Robot-printer/ROV-project/README.md

This is our ROV project, let's add a description here!
