Robot-printer/ROV-project/Documents/Mechanical Documention/CAD Documentation/Design Choices/Structure-Overview wip.md

![[rev3 proto.png]]
 This revision of the AUV was designed to optimize the the our usable space and motor placements. The motors are now at a 45 degree angle. Compared to the previous version having motors at an angle will give the AUV higher degrees of maneuverability
