Robot-printer/ROV-project/Documents/Mechanical Documention/CAD Documentation/Design Choices/Vertical Nacelle documentation -Carson.docx

The vertical nacelles are on either side of both tube brackets. They span the whole height of the sub and are secured in place by flanges on the top and bottom. The propeller is located at the bottom of the nacelle to prioritize upward movement. The propeller mount is removable to allow for the insertion of the propeller. The nacelle is curved to improve flow efficiency.
