Robot-printer/ROV-project/Arduino/mega pinout.png

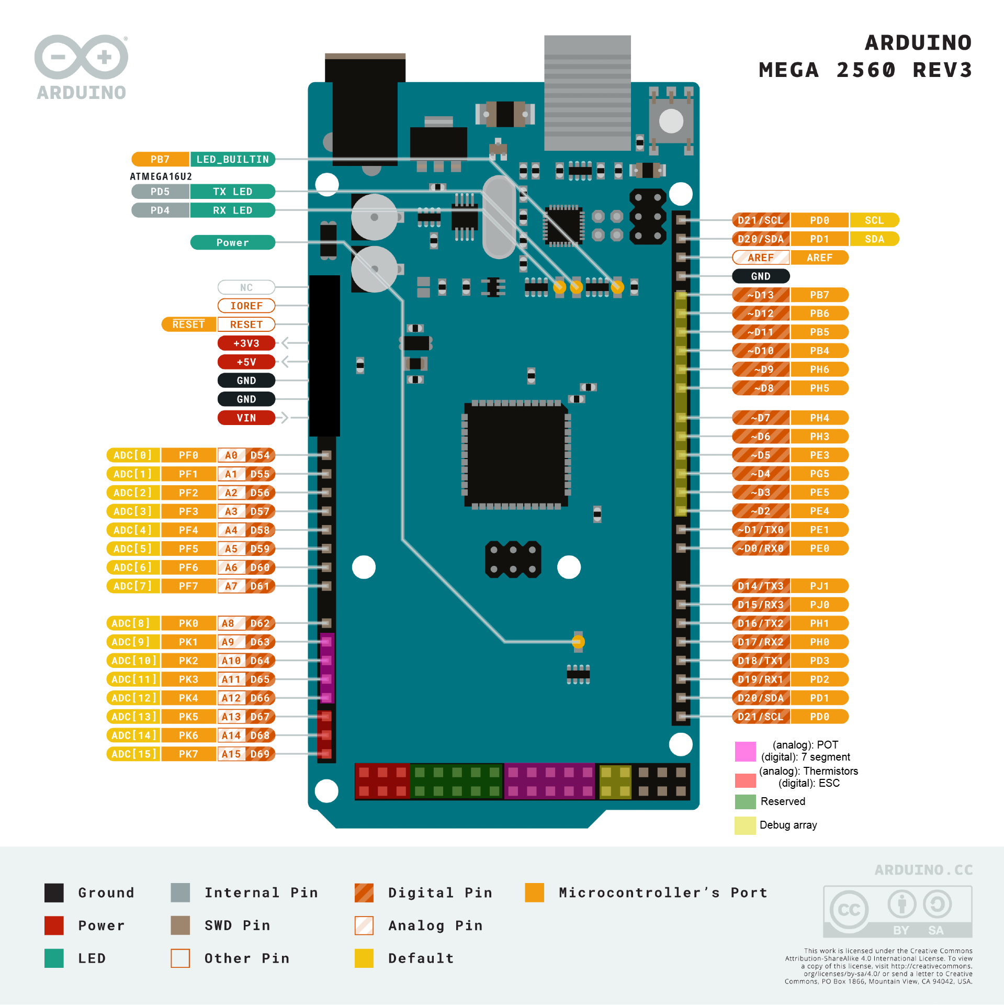
Arduino/mega pinout.png
