Robot-printer/ROV-project/Documents/Mechanical Documention/images/rev3 proto.png

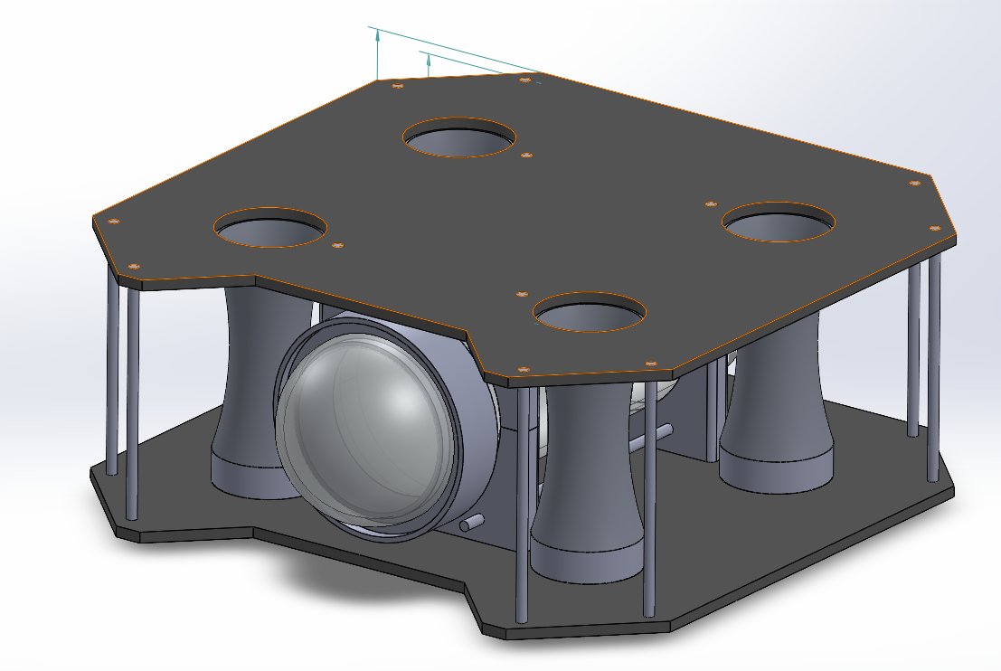
Documents/Mechanical Documention/images/rev3 proto.png
