Robot-printer/ROV-project/3D files/CAD parts/Spring 2025/README.txt

Please follow the guidelines laid out in the CAD Guidelines and CAD Part ID Format files located in the Documents/Cad Documentation folder
