Robot-printer/ROV-project/Documents/BOMs/Anonymous parts list 1 - pending, submitted.pdf

- 50 ft x External cable (https://www.wireandcableyourway.com/18-3-soow-portable-cord-600v-ul-csa) - $0.55/ft - $27.5 total (wireandcable your way)
- 2 x Heat blocks (https://www.amazon.com/dp/B07FZWM4Z7) - $12.99 ea - $ 22.98 total
- Noctua fan (https://www.amazon.com/Noctua-NF-S12A-PWM-Premium-Quiet/dp/B00BEZZBFO) - $21.95
- Coolant (https://www.amazon.com/CORSAIR-Hydro-Performance-Coolant-Clear/dp/B097S5C6DS) - $19.99
- Pump (https://www.amazon.com/Water-Cooling-Pump-Integrated-Exchanger/dp/B09DB7KX41) - $28.99
- Fittings (https://www.amazon.com/uxcell-Straight-Pneumatic-Connect-Fittings/dp/B07KBXZNZH) - $9.49
- Radiator (https://www.amazon.com/DIYhz-Computer-Radiator-Aluminum-Exchanger/dp/B08DMTF9KW) - $15.99
- Soft tubing (https://www.amazon.com/QuQuyi-Vinyl-Tubing-Lightweight-Plastic/dp/B08ZS54YTF) - $11.99
- External pumps (https://www.amazon.com/HiLetgo-Water-Brushless-Pumping-Aquarium/dp/B07X9L5RNS) - $13.69
- Pin headers (https://www.amazon.com/MCIGICM-Header-2-45mm-Arduino-Connector/dp/B07PKKY8BX) - $4.99
- 40 pin block (https://www.amazon.com/Break-Away-2x20-pin-Strip-Header-Raspberry/dp/B0756KM7CY) - $4.61
- 40 pin ribbon cable (https://www.amazon.com/Gowoops-Ribbon-Cable-40pin-Raspberry/dp/B01H53OK5U) - $14.98
- 2x SD card (https://www.amazon.com/SanDisk-Extreme-microSDTM-Adapter-SDSQXCD-256G-GN6MA/dp/B09X7DMBVF) - $ (Sandisk)
- Lipoly charger (https://www.adafruit.com/product/259) - $12.50 (Adafruit)
- Lipoly pack (https://www.adafruit.com/product/5035) - $29.95 (Adafruit)
- E-stop (https://www.digikey.com/en/products/detail/eao/61-6441-4047/8735380?s=N4IgTCBcDaIGwEYC0cAsqEDpUAZUHYQBdAXyA) - $51.64 (digikey)
