Robot-printer/ROV-project/Documents/Electronics Documentation/Electronics team BOM - Sheet1.csv

 | Part name | Unit Price | Total Price | Source | Team | Location (on vehicle) | Specs | Purpose | Part Qauntitiy | Purchase Quantity | Link
 |  | $712.44 | $1,768.63
1 | Raspberry Pi 5 | $80.00 | $80.00 | Digikey | Electronics | Electronics tray | 8gb ram [Need exact part] | Main processor | 1 | 1 | https://www.digikey.com/en/products/detail/raspberry-pi/SC1112/21658257?gclsrc=aw.ds&gad_source=1&gclsrc=aw.ds
1 | Pi Heatsink (ED-PI5PCOOLER) | $4.08 | $4.08 | Digikey | Electronics | Pi | N/A | Cool the Pi | 1 | 1 | https://www.digikey.com/en/products/detail/edatec/ED-PI5PCOOLER/25660654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
 | Micro SD card | $12.80 | $12.80 | Amazon | Electronics | Pi | 128 gb | Store Pi Programs and OS | 1 | 1 | https://www.amazon.com/SanDisk-128GB-Ultra-microSDXC-Memory/dp/B0BDYVC5TD?hvadid=730312820598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
1 | Raspberry Pi M.2 HAT+ | $12.00 | $12.00 | Digikey | Electronics | Pi | N/A | add PCIE expansion to Pi | 1 | 1 | https://www.digikey.com/en/products/detail/raspberry-pi/SC1166/23350779?gclsrc=aw.ds&gad_source=1&gclsrc=aw.ds
1 | Arduino Mega | $22.99 | $22.99 | Amazon | Electronics | Electronics tray | N/A | Main Microcontroller | 1 | 1 | https://www.amazon.com/ELEGOO-Compatible-Arduino-Projects-Compliant/dp/B01H4ZDYCE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
1 | Adafruit ItsyBitsy M0 Express | $11.95 | $35.85 | Adafruit | Electronics | Electronics tray | N/A | Auxilliary microcontroller | 3 | 3 | https://www.adafruit.com/product/3727
1 | DF Robot FIT0701 | $9.90 | $9.90 | Digikey | Electronics | Camera arm | Any USB webcam module | Main Camera | 1 | 1 | https://www.digikey.com/en/products/detail/dfrobot/FIT0701/13166487?gclsrc=aw.ds&gad_source=1&gclsrc=aw.ds
4 | Mg996R | $12.98 | $12.98 | Amazon | Electronics | Dome plate | 55g | Camera Arm Servo | 1 | 1 | https://www.amazon.com/MG996R-Digital-Waterproof-Airplane-Helicopter/dp/B0DCK462XZ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
8 | COM-18732 12v buck regulator | $14.98 | $119.84 | Digikey | Electronics | Electronics tray | 5A minimum, 13v or less minimum voltage input | Regulate voltage to motors | 8 | 8 | https://www.digikey.com/en/products/detail/sparkfun-electronics/COM-18732/15927228
1 | DFRobot DFR0884 5v converter | $8.50 | $17.00 | Digikey | Electronics | Electronics tray | 3A minimum, 13v or less minimum voltage input | regulate voltage to 5v sys | 2 | 2 | https://www.digikey.com/en/products/detail/dfrobot/DFR0884/14824983?gclsrc=aw.ds&gad_source=1&gclsrc=aw.ds
1 | LM3671 3.3V Buck Converter | $4.95 | $14.85 | Adafruit | Electronics | Electronics tray | 0.5A minimum, 13v or less minimum voltage input | regulate voltage to 3.3v sys | 3 | 3 | https://www.adafruit.com/product/2745
2 | 4s 5.2 AH LiPO | $98.99 | $197.98 | Amazon | Electronics | Battery bank | See Part Name | Main Power | 4 | 2 | https://www.amazon.com/Zeee-Battery-5200mAh-Crawler-Monster/dp/B0B1DHNSKZ?s=toys-and-games
 | Samsung 25R 18650 2500mAh 20A | $3.99 | $23.94 | 18650BatteryStore | Electronics | Electronics tray | See Part Name | Auxilliary power | 6 | 6 | https://www.18650batterystore.com/products/samsung-25r-18650?adgroupid=43081474946&gad_source=1
 | AA Batteries | $9.99 | $9.99 | Amazon | Electronics | Battery Packs | N/A | IC power | 6 | 1 | https://www.amazon.com/AmazonBasics-Performance-Alkaline-Batteries-20-Pack/dp/B00NTCH52W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
3 | AA battery packs | $1.30 | $3.90 | Digikey | Electronics | Electronics tray | 2 pack | Hold AAs | 3 | 3 | https://www.digikey.com/en/products/detail/keystone-electronics/2463/303812?gclsrc=aw.ds&gad_source=1
 | 6 AWG cable | $0.92 | $9.20 | WireandCableYourWay | Electronics | Bus Bar to Electronics tray | Stranded | Internal High-current pwr | 10 ft | 10 | https://www.wireandcableyourway.com/6-awg-thhn-building-wire
 | 12 AWG cable | $0.27 | $3.24 | WireandCableYourWay | Electronics | Bus Bar to Electronics tray | Stranded | Internal Mid-Current pwr | 12 ft | 12 | https://www.wireandcableyourway.com/12-awg-xhhw-building-wire
 | Bus bars | $0.00 | $0.00 | Pre-Owned | Electronics | Battery bank |  | Distribute power | 2 | 2
 | Lugs | $0.00 | $0.00 | Pre-Owned | Electronics | Bus Bars |  | connect cables to parts
2 | SK2S120-100 Diodes | $18.24 | $36.48 | Digikey | Electronics | Electronics tray | 50A minimum | prevent backflow on batteries | 2 | 2 | https://www.digikey.com/en/products/detail/smc-diode-solutions/SK2S120-100/9566330
15 | 95SQ015 Diode | $0.99 | $14.85 | Digikey | Electronics | Electronics tray | 5A minimum | prevent backflow on circuits | 15 | 15 | https://www.digikey.com/en/products/detail/smc-diode-solutions/95SQ015/8021508
8 | Waterproof brushless motor 100W 2418 | $25.00 | $200.00 | UnderWaterThrusters | Electronics | Thrusters | [Need exact part] | Thruster motors | 8 | 8 | https://www.underwaterthruster.com/products/waterproof-brushless-motor-100w-2418-corrosion-and-oxidation-resistant-for-use-in-underwater-robots-rovs-unmanned-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
8 | 30A multi-directional Defiant ESC | $18.99 | $151.92 | Amazon | Electronics | Electronics tray | [Need exact part] | Control Thrusters | 8 | 8 | https://www.amazon.com/30A-Defiant-ESC-Controller-Multi-Directional/dp/B0C5RYKSV2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
1 | Flashlight | $8.49 | $8.49 | Amazon | Electronics | Exterior hull | Any | Control circuit and Reflector for led | 2 | 1 | https://www.amazon.com/Military-Lumens-Tactical-Waterproof-Flashlight/dp/B073VZZKK5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
2 | Seeed Studio XIAO ESP32C3 | $4.99 | $9.98 | Digikey | Electronics | Flashlights | [Need exact part] | Control Flashlight logic | 2 | 2 | https://www.digikey.com/en/products/detail/seeed-technology-co-ltd/113991054/16652880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
1 | 2s Lipo Battery 2200mAh | $27.89 | $27.89 | Amazon | Electronics | Flashlights | See Part Name | Powers Flashlights | 2 | 1 | https://www.amazon.com/Zeee-Connector-Helicopter-Airplane-Quadcopter/dp/B0BYNKBKGT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
2 | 5v buck converter | $6.95 | $13.90 | Adafruit | Electronics | Flashlights | 1A minimum | Regulates flashlight power | 2 | 2 | https://www.adafruit.com/product/4739
 | 2 inch pvc | $8.48 | $8.48 | Lowes | Electronics | Flashlights | N/A | Flashlight body | 2ft | 1 | https://www.lowes.com/pd/Charlotte-Pipe-2-in-x-2-ft-PVC-Pipe/5005518961
1 | 2 inch Threaded pvc cap | $7.95 | $15.90 | Amazon | Electronics | Flashlights | N/A | Openable end of flashlights | 2 | 2 | https://www.amazon.com/Threaded-Cap-Schedule-40-PVC/dp/B000VYN23W?mcid=a34623da747b374fb0f44df343a1dd15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
 | 2 inch Threaded pvc adapter | $2.59 | $5.18 | Home Depot | Electronics | Flashlights | N/A | adapter for threaded cap | 2 | 2 | https://www.homedepot.com/pep/Charlotte-Pipe-2-in-PVC-Schedule-40-MPT-x-S-Male-Adapter-PVC-02109-1600HD/203825431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
 | 1 1/2 inch pvc | $5.85 | $5.85 | Home Depot | Electronics | Flashlights | N/A | pvc for clear cap | 6 inches | 1 | https://www.homedepot.com/p/Charlotte-Pipe-1-1-2-in-x-2-ft-PVC-DWV-Schedule-40-Pipe-PVC071120200HA/100581718
 | 2 inch to 1 1/2 inch pvc reducer | $3.32 | $6.64 | Lowes | Electronics | Flashlights | N/A | pvc adapter | 2 | 2 | https://www.lowes.com/pd/Charlotte-Pipe-2-IN-X-1-1-2-IN-SCH40-REDUCER-BUSHING/5012474889
 | 1 1/2 inch clear pvc cap | $3.90 | $7.80 | US Plastic | Electronics | Flashlights | N/A | clear cap | 2 | 2 | https://www.usplastic.com/catalog/item.aspx?itemid=154673&clickid=search
 | Pvc cement | $5.22 | $5.22 | Home Depot | Electronics | Flashlights | N/A | holds PVC parts together | 1 | 1 | https://www.homedepot.com/pep/Oatey-8-oz-Regular-Clear-PVC-Cement-California-Compliant-310133V/322402448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
1 | USB A hub | $6.99 | $13.98 | Amazon | Electronics | Electronics tray | 3 ports or more | adds more USB ports to the Pi | 2 | 2 | https://www.amazon.com/UGREEN-Splitter-Ultra-Slim-Expander-Compatible/dp/B0CD1BHXPZ
1 | Dupont cables | $6.98 | $13.96 | Amazon | Electronics | Electronics tray | N/A | Connects microcontrollers to circuits | 2 | 2 | https://www.amazon.com/Elegoo-EL-CP-004-Multicolored-Breadboard-arduino/dp/B01EV70C78
1 | Noctua 80mm fan | $16.11 | $48.33 | Amazon | Electronics | Interior Cooling ducts | N/A | Provides air circulation | 3 | 3 | https://www.amazon.com/Noctua-Bearing-Premium-NF-A8-PWM/dp/B00VG9PJBO?mcid=9df0e357253335b19d65e9c5ce952d09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
5 | 4468 fans | $2.95 | $14.75 | Digikey | Electronics | Interior Cooling ducts | N/A | directs air onto components | 5 | 5 | https://www.digikey.com/en/products/detail/adafruit-industries-llc/4468/11587354
 | Copper Sheet | $0.00 | $0.00 | Pre-Owned | Electronics | Interior face of Hull |  | Provides thermal mass for dissipation | 1 | 1
 | Thermal paste | $13.99 | $13.99 | Amazon | Electronics | (various locations) | N/A | Provides a thermal bridge | 100g | 1 | https://www.amazon.com/HY-510-1pcs-25g-Thermal-Paste-Conductivity/dp/B07PHT3LWC?sp_csd=d2lkZ2V0TmFtZT1zcF9hdGY
 | Ptm7950 phase change thermal pads | $25.99 | $25.99 | Newegg | Electronics | (various locations) | N/A | Provides a more effective, thinner thermal bridge | 80mmx80mm | 1 | https://www.newegg.com/p/2MB-001F-00072?Item=9SIA4REK368786&cm_sp=product-_-from-price-options
 | Heatsinks | $0.00 | $0.00 | Pre-Owned | Electronics | Interior face of Hull |  | Dissipates heat
10 | 8 connector terminal blocks | $3.83 | $30.64 | Digikey | Electronics | Back plate near glands | [Need exact part] | Takes cable inputs from glands | 8 | 8 | https://www.digikey.com/en/products/detail/phoenix-contact/1715789/260634?gclsrc=aw.ds&gad_source=1
 | 16 gauge x6 cables | $1.48 | $23.68 | WireandCableYourWay | Electronics | Gland outputs | [Need exact part] | cable for glands | 16 | 16 | https://www.wireandcableyourway.com/16-6-soow-portable-cord-600v-ul-csa
 | 18 gauge x3 cables | $0.53 | $21.20 | WireandCableYourWay | Electronics | Gland outputs | [Need exact part] | cable for glands | 40 | 40 | https://www.wireandcableyourway.com/18-3-soow-portable-cord-600v-ul-csa
10 | SPST switch | $0.71 | $7.10 | Digikey | Electronics | Electronics tray | 5V, 5A | Control circuits for power off and debugging | 10 | 10 | https://www.digikey.com/en/products/detail/e-switch/RA1113112R/3778055?gclsrc=aw.ds&gad_source=1
1 | Cutoff switch | $14.99 | $14.99 | Amazon | Electronics | Electronics tray | 12V, 200A | Hard cut for main power | 1 | 1 | https://www.amazon.com/Battery-Disconnect-Current-Isolator-Outboards/dp/B0B17BGHPS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
1 | OLED graphic display | $19.95 | $39.90 | Adafruit | Electronics | Electronics tray | Monochrome 1.3" 128x64 | provides a display for system info | 2 | 2 | https://www.adafruit.com/product/938?gQT=1
1 | Waterproof switch cover | $3.08 | $3.08 | Digikey | Electronics | Back plate | [Need exact part] | Waterproofs a button | 1 | 1 | https://www.digikey.com/en/products/detail/apm-hexseal/N3030-2/340286?gclsrc=aw.ds&gad_source=1
 | Exterior cutoff switch | $2.61 | $2.61 | Digikey | Electronics | Back plate | N/A | Button for emergency cutoff | 1 | 1 | https://www.digikey.com/en/products/detail/c-k/F2UEE/417517
1 | HiLetgo RFID Kit | $5.69 | $5.69 | Amazon | Electronics | Interior face of Hull | [Need exact part] | Reads RFID cards for external controls | 1 | 1 | https://www.amazon.com/HiLetgo-RFID-Kit-Arduino-Raspberry/dp/B01CSTW0IA?mcid=896d590d183434548498ee0eaa5bc8a9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
1 | T5577 Thick Smart Cards | $6.98 | $6.98 | Amazon | Electronics | N/A | Any Programmable RFID cards or tags | Extra RFID cards for other functions | 5 | 1 | https://www.amazon.com/Contactless-Rewritable-Proximity-Clamshell-Compatible/dp/B0DHVXYNZL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
 | Underwater Ultrasonic Obstacle Avoidance Sensor | $32.00 | $256.00 | DFR Robot | Electronics | Exterior mounts | [Need exact part] | Ultrasonic distance sensor, for 3d mapping | 8 | 8 | https://www.dfrobot.com/product-2760.html
1 | 6 axis accelerometer and 3 axis gyroscope | $19.95 | $39.90 | Adafruit | Electronics | Electronics tray | [Need exact part] | detects the orientation of the vehicle | 2 | 2 | https://www.adafruit.com/product/4517
1 | Adafruit AM2320 Sensor | $3.95 | $3.95 | Digikey | Electronics | Electronics tray | [Need exact part] | Detects humidity | 1 | 1 | https://www.digikey.com/en/products/detail/adafruit-industries-llc/3721/8558266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
10 | 10k thermistor | $0.95 | $9.50 | Digikey | Electronics | (various locations) | [Need exact part] | Detects heat at a point to prevent overheating | 10 | 10 | https://www.digikey.com/en/products/detail/adafruit-industries-llc/4890/13982731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
1 | DF Robot SEN0257 | $17.50 | $17.50 | Digikey | Electronics | Exterior mounts | [Need exact part] | Detects pressure under the water (to tell depth) | 1 | 1 | https://www.digikey.com/en/products/detail/dfrobot/SEN0257/8341836?gclsrc=aw.ds&gad_source=1&gclsrc=aw.ds
 | Adafruit MPRLS Ported Pressure Sensor | $29.95 | $29.95 | Adafruit | Electronics | Electronics tray | [Need exact part] | Detects interior pressure to monitor for issues | 1 | 1 | https://www.adafruit.com/product/3965
 | Waterproof DS18B20 Digital temperature sensor | $6.90 | $6.90 | Digikey | Electronics | Exterior mounts | [Need exact part] | detects water temperature | 1 | 1 | https://www.digikey.com/en/products/detail/dfrobot/DFR0198/7597054?gclsrc=aw.ds&gad_source=1&gclsrc=aw.ds
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
 |  | $0.00 | $0.00
 |  | $0.00 | $0.00
 |  | $0.00 | $0.00
 |  | $0.00 | $0.00
 |  | $0.00 | $0.00
 |  | $0.00 | $0.00
 |  | $0.00 | $0.00
 |  | $0.00 | $0.00
 |  | $0.00 | $0.00
 |  | $0.00 | $0.00
 |  | $0.00 | $0.00
 |  | $0.00 | $0.00
 |  | $0.00 | $0.00
 |  | $0.00 | $0.00
