Robot-printer/ROV-project/Documents/Mechanical Documention/BOM/Mech-BOM May.ods

Part number (internal) | Part name | Unit Price | Total Price | Source | Team | Location (on vehicle) | Purpose | Specs | Quantity | Link | Note:
 | HDPE Sheet | 69.72 | 139.44 | McMaster | 1 | Wings | Wings | 75cm/50cm | 2 | https://www.mcmaster.com/products/hdpe-sheets/marine-grade-moisture-resistant-polyethylene-hdpe-sheets-and-bars/
 | M3 Screws/hex kit | 21.99 | 21.99 | Amazon | 1 | everywhere | fix parts to other parts |  | 1 | https://www.amazon.com/M3-Assortment-Screws-Internal-Assorted/dp/B0C7QRW2TF?hvadid=694085230790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
 | M5 Screws/hex kit | 11.99 | 11.99 | Amazon | 1 | everywhere | fix parts to other parts |  | 1 | https://www.amazon.com/Pieces-Washers-Sutemribor-Assortment-Threaded/dp/B0CZRT2B8M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
 | 1kg ASA filament | 29.99 | 499.95 | Elegoo, PolyMaker, Overture, Hatchbox, Bambu Labs | 1 | support parts | support | Color: black | 5 | https://www.amazon.com/Creality-Filament-Printer-Temperature-Resistance/dp/B0CF2384QL
 | Adhesive | unknown | unknown | unknown | 1 | End caps | Glue parts of the end caps together | waterproof | 2
 | n
