Robot-printer/ROV-project/Documents/Mechanical Documention/BOM/Mech-BOM.ods

Part number (internal) | Part name | Unit Price | Total Price | Source | Team | Location (on vehicle) | Purpose | Specs | Quantity | Link | Note:
 | HDPE Sheet | 69.72 | 139.44 | McMaster | 1 | Wings | Wings | 75cm/50cm | 2 | https://www.mcmaster.com/products/hdpe-sheets/marine-grade-moisture-resistant-polyethylene-hdpe-sheets-and-bars/
 | M3 Screws/hex kit | 21.99 | 21.99 | Amazon | 1 | everywhere | fix parts to other parts |  | 1 | https://www.amazon.com/M3-Assortment-Screws-Internal-Assorted/dp/B0C7QRW2TF?hvadid=694085230790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
 | M5 Screws/hex kit | 11.99 | 11.99 | Amazon | 1 | everywhere | fix parts to other parts |  | 1 | https://www.amazon.com/Pieces-Washers-Sutemribor-Assortment-Threaded/dp/B0CZRT2B8M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
 | 3/8’’ threaded rod | 5.68 | 17.04 | Lowe’s | 1 | 4 on each wing | support rods | 36’’ long | 3 | https://www.lowes.com/pd/Hillman-3-8-in-dia-x-3-ft-L-Coarse-Steel-Threaded-Rod/3129283
 | 3/8’’ nuts | 8.42 | 8.42 | Home Depot | 1 | Threaded onto the support rods | lock the support the rods |  | 1(25Pack) | https://www.homedepot.com/p/Everbilt-3-8-in-16-Galvanized-Hex-Nut-25-Pack-802244/204274099
 | PVC tube | unknown | unknown | unknown | 1 | Pressure chamber | Pressure chamber | 18’’ long, ID 152, OD 168 | 1
 | Aluminum | 52 | 208 | ebay | 1 | End caps | support | 6061 T6 9’’x 9’’, ¼’’ thick | 4 | https://www.ebay.com/str/USA-Metal-Online | This was provided to us. This seller does not do standard sizes
 | 1kg nylon filament | $0.00 | $0.00 | Elegoo, PolyMaker, Overture, Hatchbox, Bambu Labs | 1 | support parts | support | Color: black | 5
 | Large Cable Gland | 9.29 | 18.58 | Amazon | 1 | End caps | Cable port | 21mm | 2(20 packs) | https://www.amazon.com/MAKERELE-Plastic-Waterproof-Adjustable-6-8mm-12mm/dp/B0CTCG3PQG?th=1
 | Small Cable Gland | 9.97 | 19.94 | Amazon | 1 | End caps | Cable port | 8.2mm | 2(20 packs)
 | Adhesive | unknown | unknown | unknown | 1 | End caps | Glue parts of the end caps together | waterproof | 2
