Robot-printer/ROV-project/Documents/Software Documentation/Software-BOM.csv

Part number (internal) | Part name | Unit Price | Total Price | Source | Team | Location (on vehicle) | Purpose | Quantity | Link
1 | Turtle Beach VelocityOne Flightstick | $129.36 | $129.36 | Amazon | 3 | N/A | Vehicle control | 1 | https://www.amazon.com/VelocityOne-Flightstick-Simulation-Controller-Gaming-Console/dp/B0BHTPP71M
1 | Crucial BX500 | $94.99 | $94.99 | Amazon | 3 | N/A | Video recording storage | 1 | https://www.amazon.com/Crucial-BX500-NAND-2-5-Inch-Internal/dp/B07YD579WM
 |  | $0.00 | $0.00
 |  | $0.00 | $0.00
 |  | $0.00 | $0.00
 |  | $0.00 | $0.00
 |  | $0.00 | $0.00
 |  | $0.00 | $0.00
 |  | $0.00 | $0.00
 |  | $0.00 | $0.00
 |  | $0.00 | $0.00
 |  | $0.00 | $0.00
 |  | $0.00 | $0.00
 |  | $0.00 | $0.00
 |  | $0.00 | $0.00
 |  | $0.00 | $0.00
 |  | $0.00 | $0.00
 |  | $0.00 | $0.00
 |  | $0.00 | $0.00
 |  | $0.00 | $0.00
 |  | $0.00 | $0.00
 |  | $0.00 | $0.00
 |  | $0.00 | $0.00
 |  | $0.00 | $0.00
 |  | $0.00 | $0.00
 |  | $0.00 | $0.00
 |  | $0.00 | $0.00
 |  | $0.00 | $0.00
 |  | $0.00 | $0.00
 |  | $0.00 | $0.00
 |  | $0.00 | $0.00
 |  | $0.00 | $0.00
 |  | $0.00 | $0.00
 |  | $0.00 | $0.00
 |  | $0.00 | $0.00
 |  | $0.00 | $0.00
 |  | $0.00 | $0.00
 |  | $0.00 | $0.00
 |  | $0.00 | $0.00
 |  | $0.00 | $0.00
 |  | $0.00 | $0.00
 |  | $0.00 | $0.00
 |  | $0.00 | $0.00
 |  | $0.00 | $0.00
 |  | $0.00 | $0.00
 |  | $0.00 | $0.00
 |  | $0.00 | $0.00
 |  | $0.00 | $0.00
 |  | $0.00 | $0.00
 |  | $0.00 | $0.00
 |  | $0.00 | $0.00
 |  | $0.00 | $0.00
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
 |  | $0.00 | $0.00
 |  | $0.00 | $0.00
 |  | $0.00 | $0.00
 |  | $0.00 | $0.00
 |  | $0.00 | $0.00
 |  | $0.00 | $0.00
 |  | $0.00 | $0.00
 |  | $0.00 | $0.00
 |  | $0.00 | $0.00
 |  | $0.00 | $0.00
 |  | $0.00 | $0.00
 |  | $0.00 | $0.00
 |  | $0.00 | $0.00
 |  | $0.00 | $0.00
