Robot-printer/ROV-project/PCB/Altium files/endcap.csv

Line # | Name | Description | Designator | Revision ID | Revision State | Revision Status | Quantity | Manufacturer 1 | Manufacturer Part Number 1 | Manufacturer Lifecycle 1 | Supplier 1 | Supplier Part Number 1 | Supplier Unit Price 1 | Supplier Subtotal 1
 | 615008138221 | Rj45 ports | Rj1, Rj2, Rj3, Rj4, Rj5, Rj6 | CMP-1502-01731-2 | Released | Up to date | 6 | Wurth Electronics | 615008138221 | Volume Production | Digikey | 732-2743-ND | 2.42 | 14.52
