Robot-printer/ROV-project/3D files/CAD parts/Spring 2025/Contemporary Parts/Assembled UUV 1.0.SLDASM

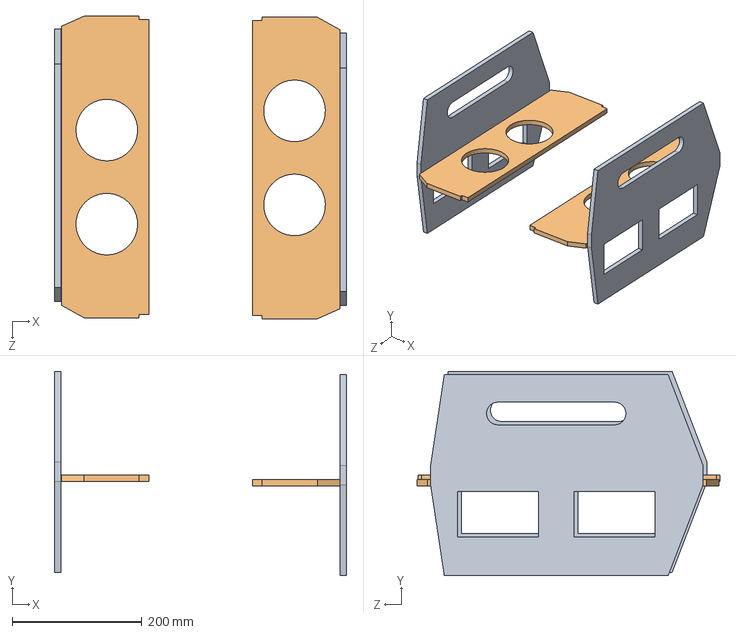
[picture p3: CAD file, 2025-02-06]
3D files/CAD parts/Spring 2025/Contemporary Parts/Assembled UUV 1.0.SLDASM
450.1 x 315.0 x 466.6 mm
Side Flaps 1.0 x 2
Side Wings 1.0 x 2
