Robot-printer/ROV-project/3D files/CAD parts/Spring 2025/Revision3/AUV Assembly.SLDASM

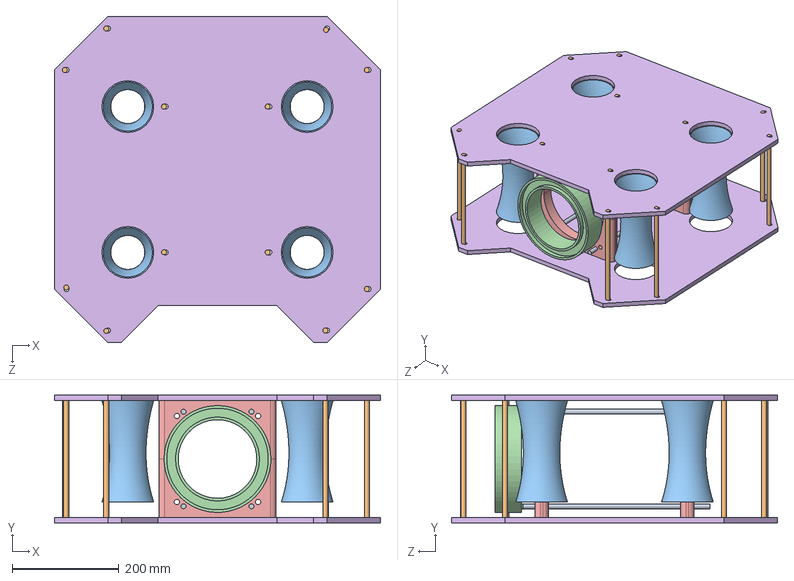
[picture p4: CAD file, 2025-05-07]
3D files/CAD parts/Spring 2025/Revision3/AUV Assembly.SLDASM
610.0 x 239.0 x 610.0 mm
Plate1 x 2
PVC Bracket x 4
Front collar
Vertical Nacelles x 4
Steel Rod x 12
Long steel rod x 4
