Robot-printer/ROV-project/3D files/CAD parts/Spring 2025/Addison's CAD Files/Main tube mm.SLDPRT

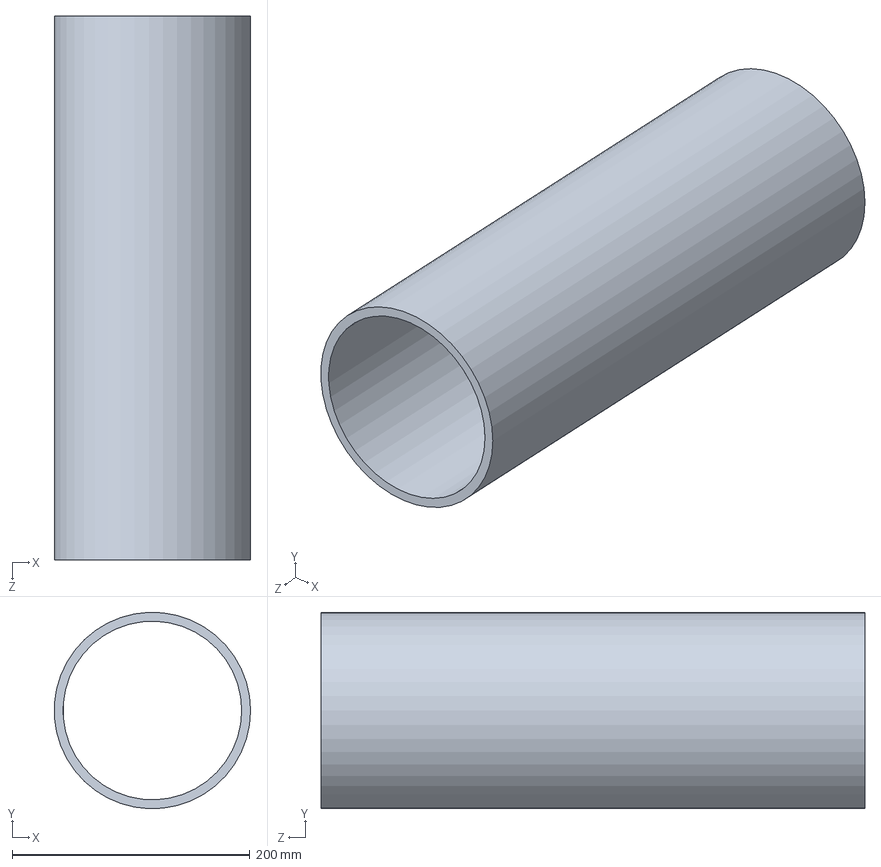
[picture p5: CAD file, 2025-04-10]
3D files/CAD parts/Spring 2025/Addison's CAD Files/Main tube mm.SLDPRT
164.9 x 165.0 x 457.2 mm
