Robot-printer/ROV-project/3D files/CAD parts/Spring 2025/Addison's CAD Files/Dimentioned assembly MMGS.SLDASM

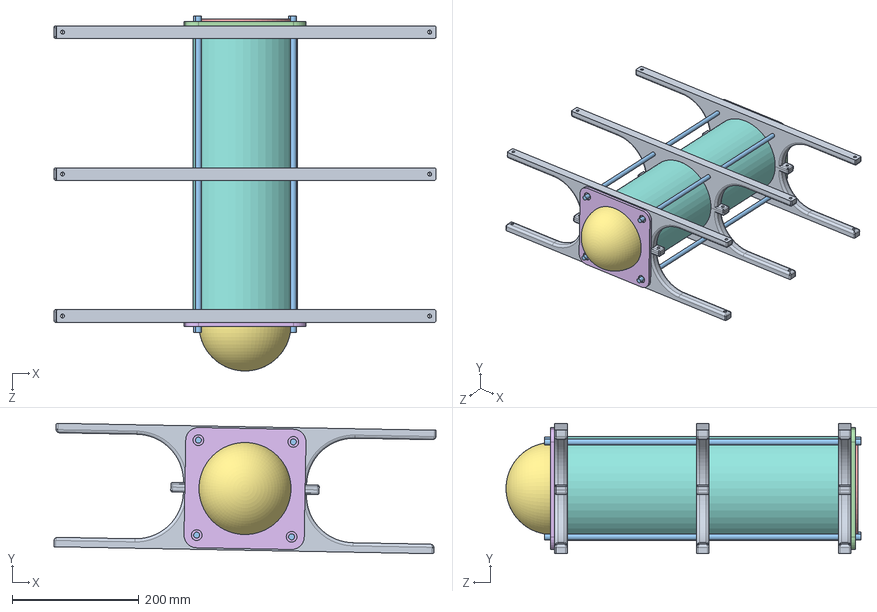
[picture p6: CAD file, 2025-04-10]
3D files/CAD parts/Spring 2025/Addison's CAD Files/Dimentioned assembly MMGS.SLDASM
603.5 x 206.0 x 560.8 mm
Main tube mm
Dome MMGS
Aluminum faceplate mms
Updated end cap
Back faceplate MMGS
aluminum rod MMGS x 4
Front Endcap Updated mmgs
Updated Bracket2 mmgs x 6
