Robot-printer/ROV-project/3D files/CAD parts/Active parts/Printables/PVC Bracket.STEP

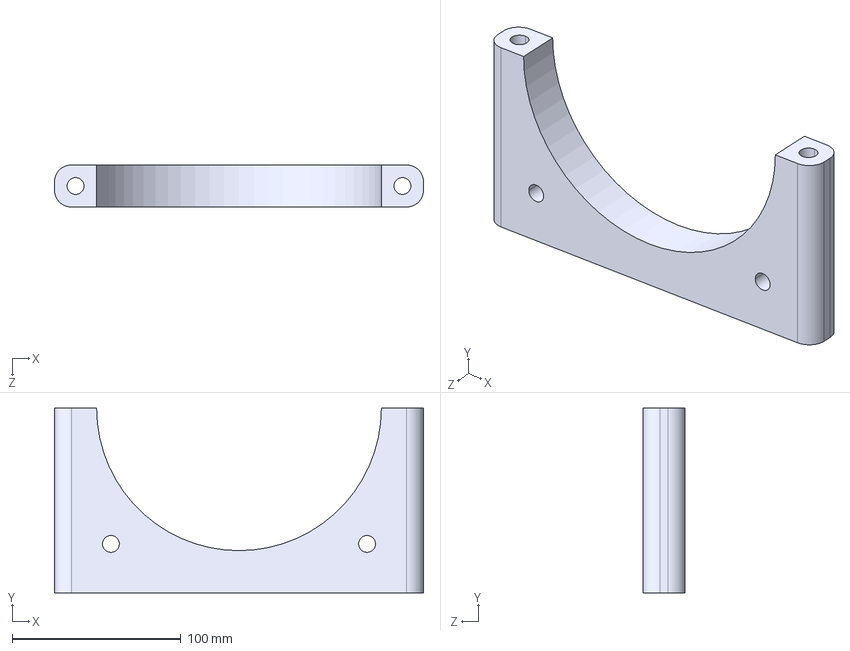
[picture p7: CAD file, 2025-07-30]
3D files/CAD parts/Active parts/Printables/PVC Bracket.STEP
219.0 x 109.5 x 25.0 mm
