Robot-printer/ROV-project/3D files/CAD parts/Spring 2025/Addison's CAD Files/Aluminum faceplate mms.SLDPRT

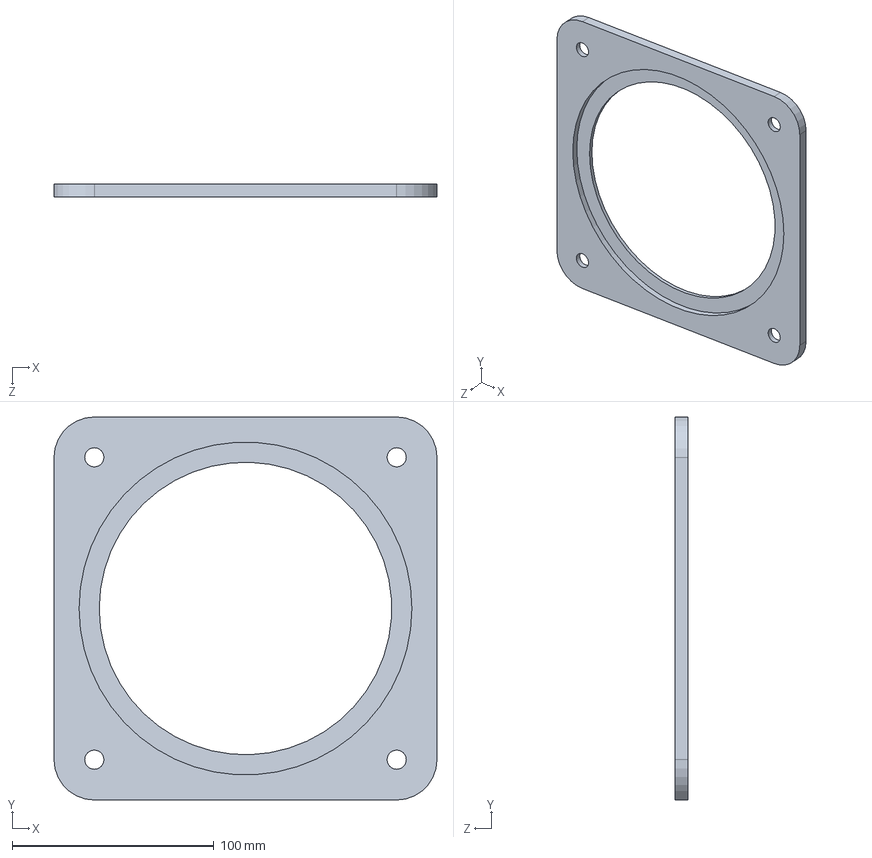
[picture p8: CAD file, 2025-04-10]
3D files/CAD parts/Spring 2025/Addison's CAD Files/Aluminum faceplate mms.SLDPRT
190.0 x 190.0 x 6.35 mm
