Robot-printer/ROV-project/3D files/CAD parts/Spring 2025/Contemporary Parts/UUV Battery 1.0.SLDPRT

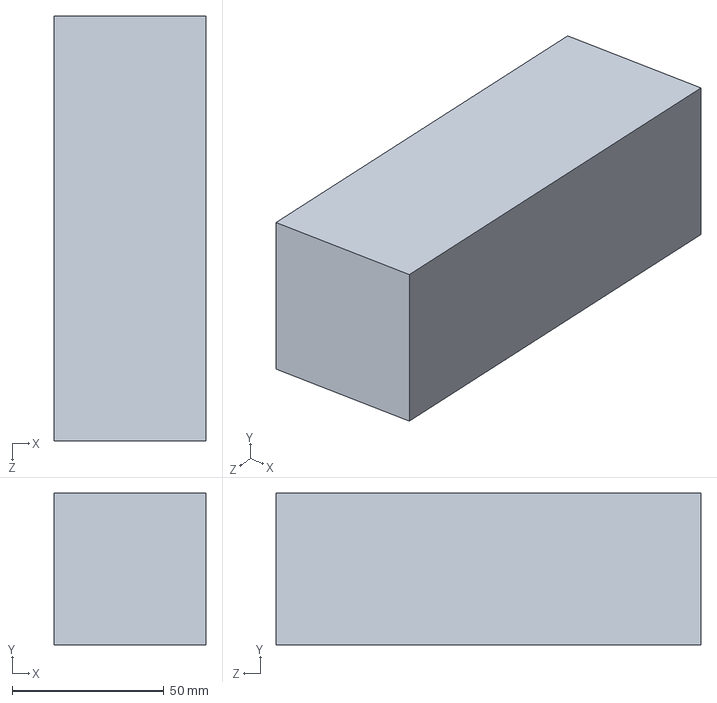
[picture p9: CAD file, 2025-02-06]
3D files/CAD parts/Spring 2025/Contemporary Parts/UUV Battery 1.0.SLDPRT
50.0 x 50.0 x 140.0 mm
