Robot-printer/ROV-project/3D files/CAD parts/Spring 2025/Feet 02.SLDPRT

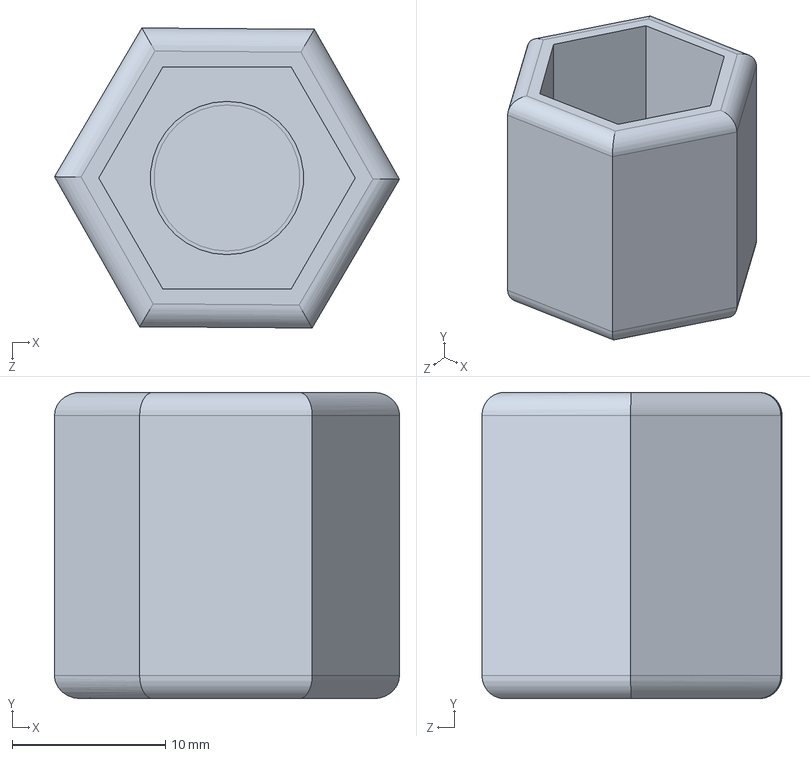
[picture p11: CAD file, 2025-08-07]
3D files/CAD parts/Spring 2025/Feet 02.SLDPRT
22.5 x 20.0 x 19.6 mm
