Robot-printer/ROV-project/3D files/CAD parts/Spring 2025/Revision3/Vertical Nacelles.SLDPRT

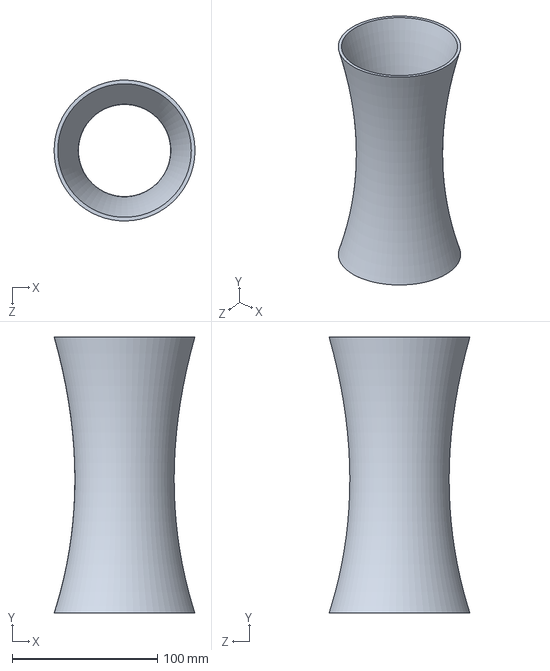
[picture p12: CAD file, 2025-05-07]
3D files/CAD parts/Spring 2025/Revision3/Vertical Nacelles.SLDPRT
96.9 x 190.0 x 97.0 mm
