Robot-printer/ROV-project/3D files/CAD parts/Spring 2025/WIP/electronics tray.SLDPRT

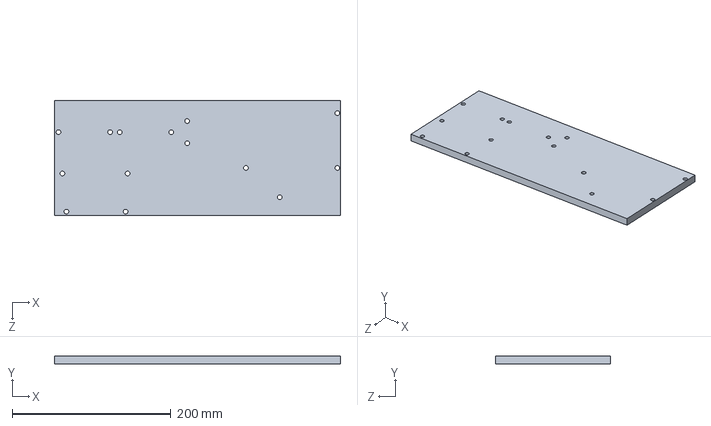
[picture p13: CAD file, 2025-06-06]
3D files/CAD parts/Spring 2025/WIP/electronics tray.SLDPRT
360.0 x 10.0 x 145.0 mm
