Robot-printer/ROV-project/3D files/CAD parts/Summer 2025/HandleA.STEP

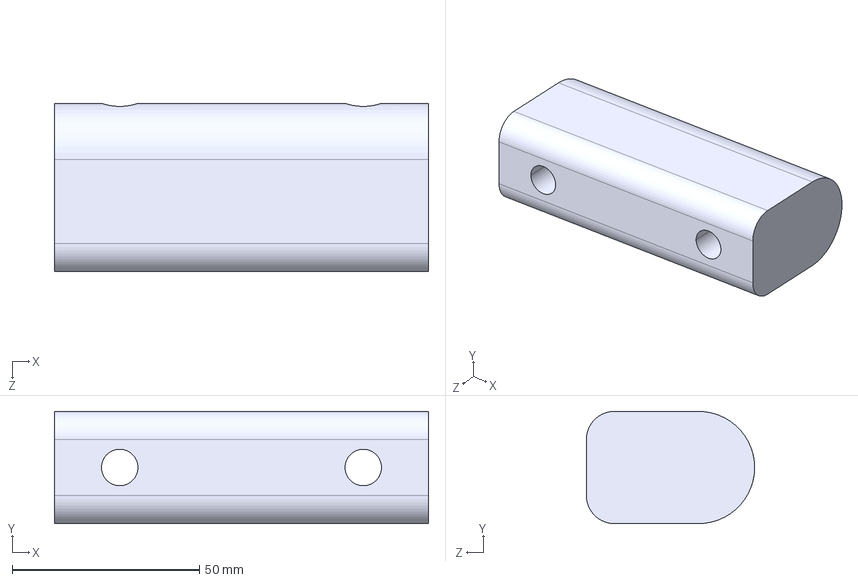
[picture p14: CAD file, 2025-07-07]
3D files/CAD parts/Summer 2025/HandleA.STEP
100.0 x 30.0 x 45.0 mm
