Robot-printer/ROV-project/3D files/electronic mock ups/EndCapPCB.step

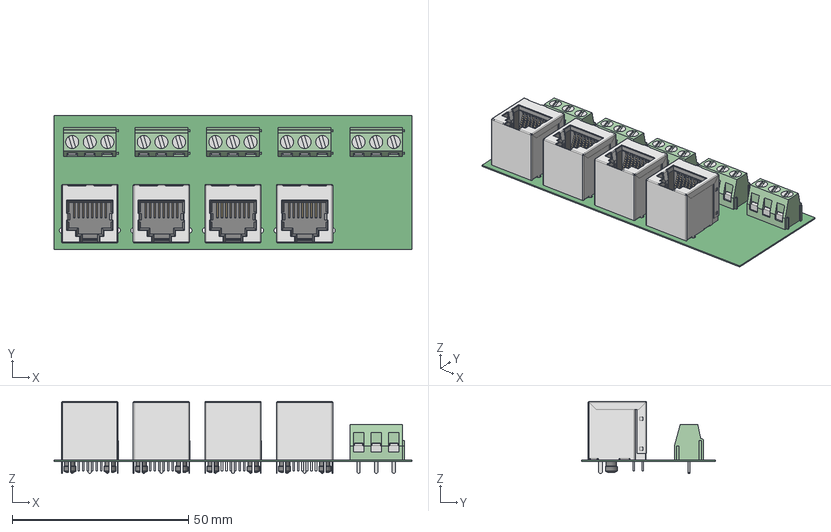
[picture p15: CAD file, 2025-04-16]
3D files/electronic mock ups/EndCapPCB.step
101.6 x 38.0 x 20.5 mm
Shielding x 4
Insulator x 4
Insulator_2 x 4
Pin2 x 16
Pin1 x 16
6912137100xx_MASS x 15
6912137100xx_VIS x 15
6912137100xx_PIN x 15
