Robot-printer/ROV-project/3D files/Electronics mounts/Switch plate.SLDPRT

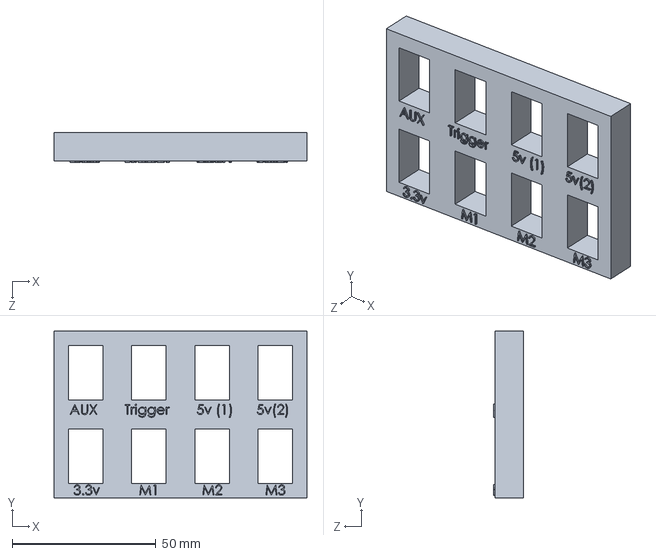
[picture p16: CAD file, 2025-07-03]
3D files/Electronics mounts/Switch plate.SLDPRT
88.0 x 58.0 x 10.5 mm
