Robot-printer/ROV-project/3D files/Structure/Rear Endcap Outer.SLDPRT

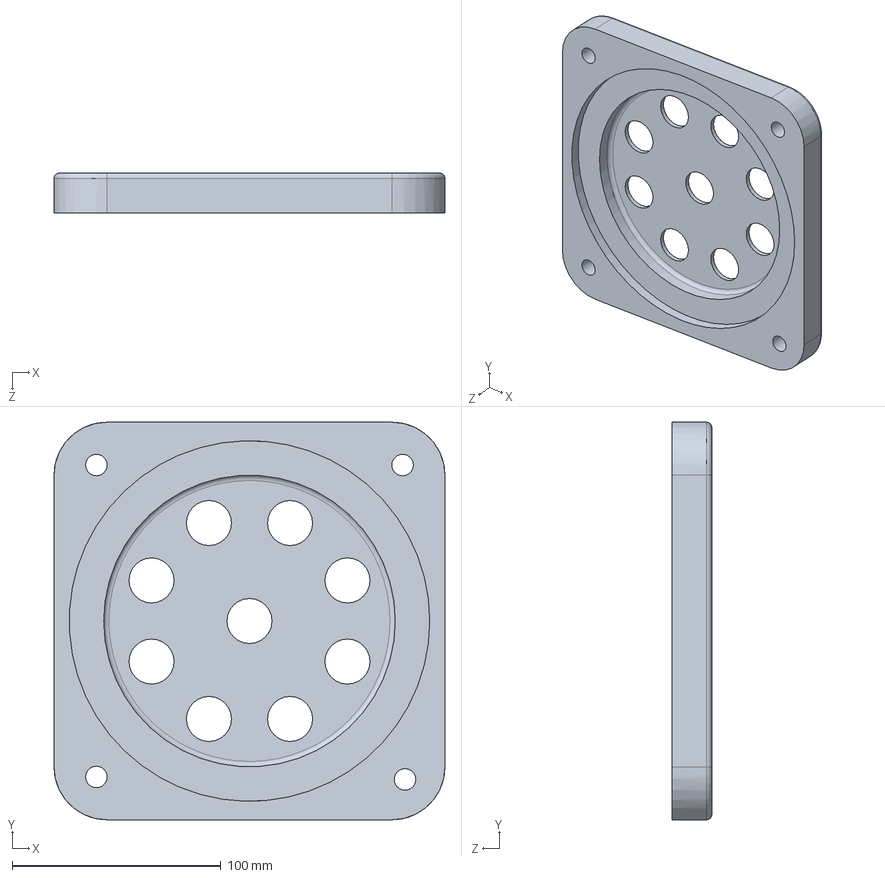
[picture p17: CAD file, 2025-01-29]
3D files/Structure/Rear Endcap Outer.SLDPRT
187.3 x 190.5 x 19.1 mm
