Robot-printer/ROV-project/3D files/CAD parts/Active parts/Printables/S01_1.3.STEP

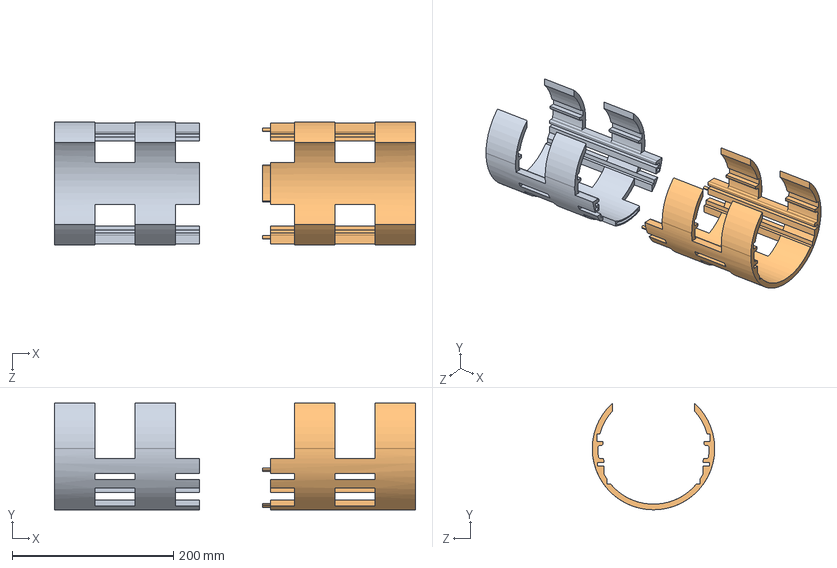
[picture p18: CAD file, 2025-02-06]
3D files/CAD parts/Active parts/Printables/S01_1.3.STEP
447.9 x 132.3 x 152.0 mm
