Robot-printer/ROV-project/3D files/CAD parts/Spring 2025/Addison's CAD Files/Updated end cap.SLDPRT

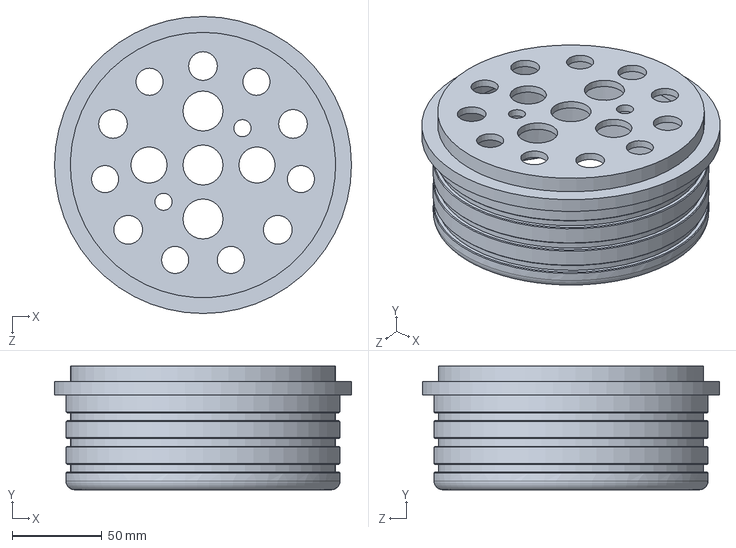
[picture p19: CAD file, 2025-04-10]
3D files/CAD parts/Spring 2025/Addison's CAD Files/Updated end cap.SLDPRT
165.1 x 68.8 x 165.1 mm
