Robot-printer/ROV-project/3D files/CAD parts/Spring 2025/AUV Assembly/Propeller-Z01.SLDPRT

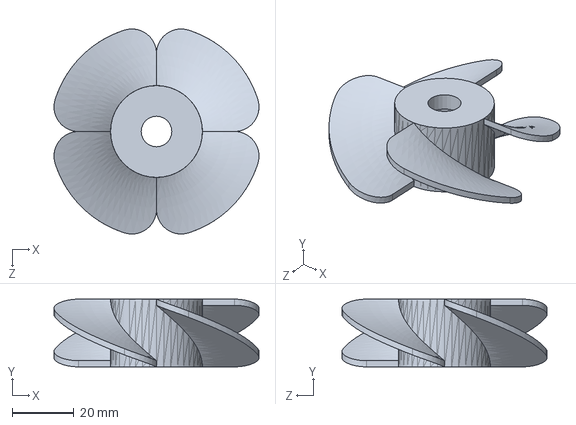
[picture p20: CAD file, 2025-07-01]
3D files/CAD parts/Spring 2025/AUV Assembly/Propeller-Z01.SLDPRT
66.5 x 22.0 x 66.5 mm
