Robot-printer/ROV-project/3D files/CAD parts/Spring 2025/Electronics tray/E04_1.0.STEP

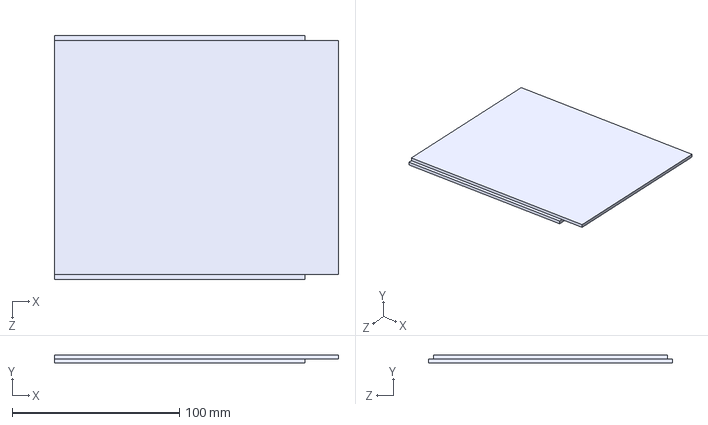
[picture p21: CAD file, 2025-07-30]
3D files/CAD parts/Spring 2025/Electronics tray/E04_1.0.STEP
170.0 x 5.00 x 146.0 mm
