Robot-printer/ROV-project/3D files/CAD parts/Spring 2025/Motor mount vert 003.SLDPRT

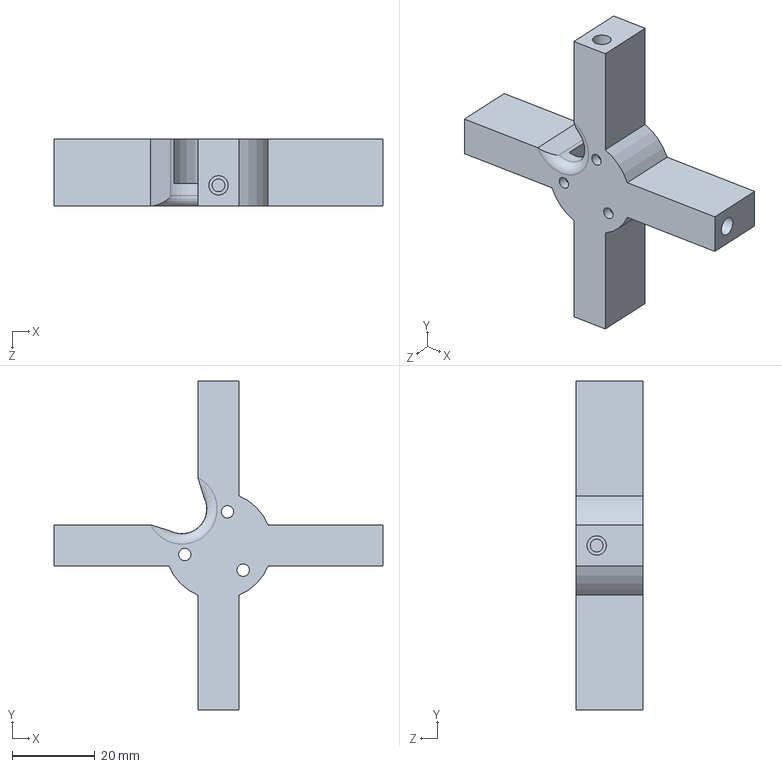
[picture p22: CAD file, 2025-07-30]
3D files/CAD parts/Spring 2025/Motor mount vert 003.SLDPRT
79.6 x 79.6 x 16.2 mm
