Robot-printer/ROV-project/3D files/CAD parts/Spring 2025/Revision3/Front collar.SLDPRT

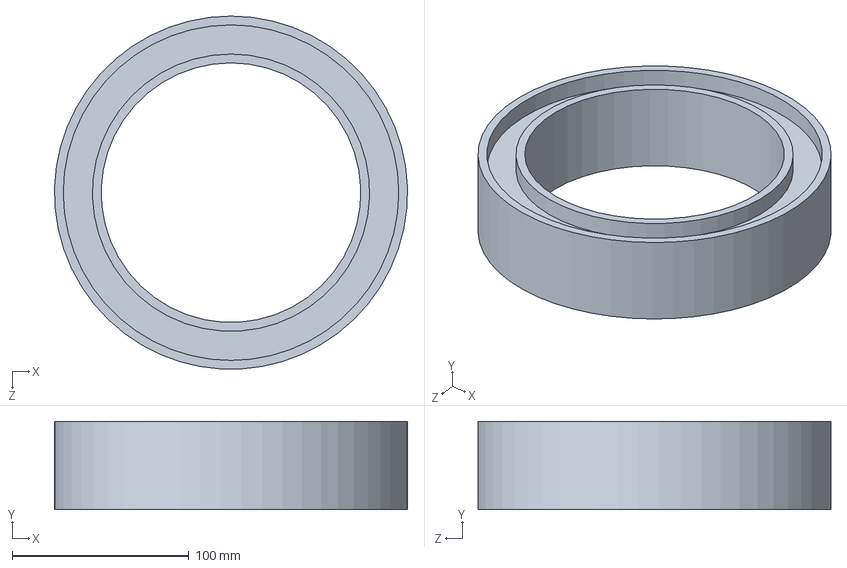
[picture p23: CAD file, 2025-05-07]
3D files/CAD parts/Spring 2025/Revision3/Front collar.SLDPRT
199.9 x 50.0 x 199.8 mm
