Robot-printer/ROV-project/3D files/CAD parts/Active parts/Ranger-01/Vertical Nacelle.SLDPRT

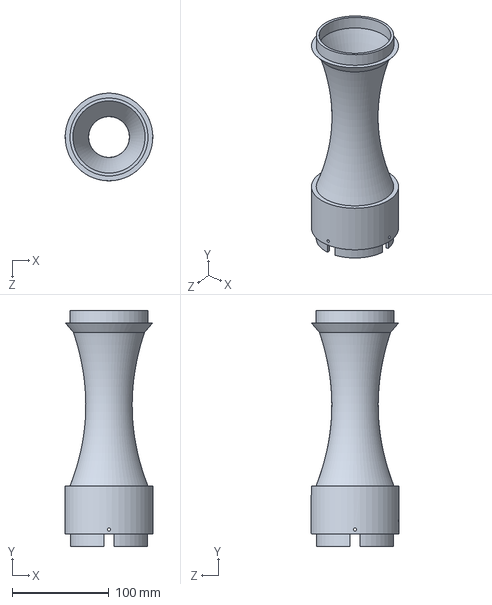
[picture p24: CAD file, 2025-07-10]
3D files/CAD parts/Active parts/Ranger-01/Vertical Nacelle.SLDPRT
90.8 x 244.4 x 90.8 mm
