Robot-printer/ROV-project/3D files/CAD parts/Spring 2025/Addison's CAD Files/aluminum rod MMGS.SLDPRT

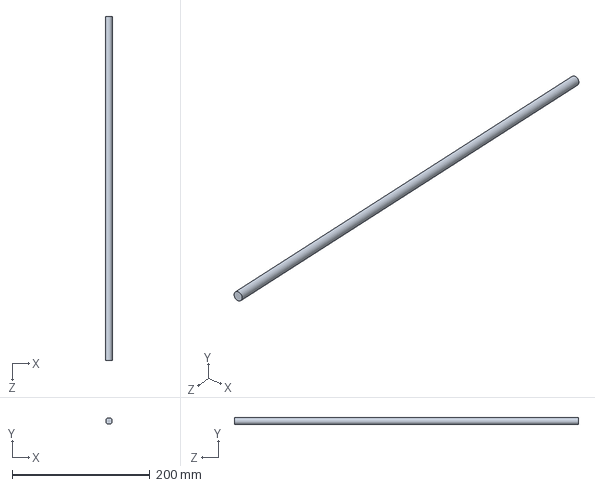
[picture p25: CAD file, 2025-04-10]
3D files/CAD parts/Spring 2025/Addison's CAD Files/aluminum rod MMGS.SLDPRT
9.53 x 9.53 x 500.0 mm
