Robot-printer/ROV-project/3D files/CAD parts/Spring 2025/Hor Nacell 005 FINAL.SLDPRT

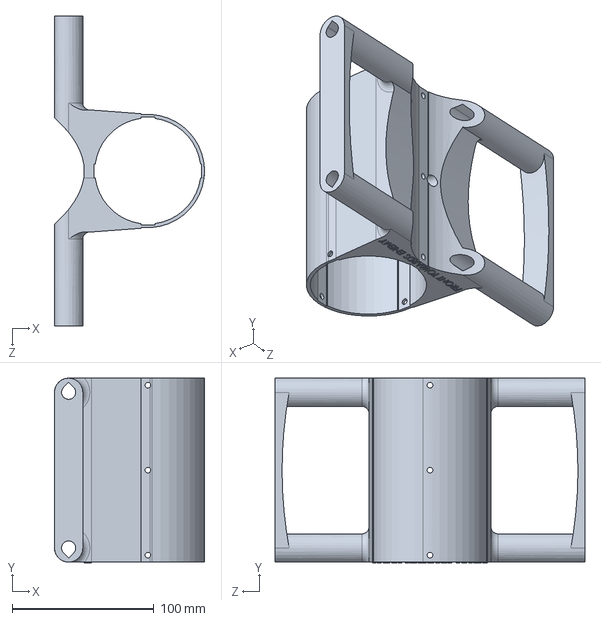
[picture p26: CAD file, 2025-07-30]
3D files/CAD parts/Spring 2025/Hor Nacell 005 FINAL.SLDPRT
106.0 x 130.5 x 219.0 mm
