Robot-printer/ROV-project/3D files/CAD parts/Spring 2025/Revision3/Plate1.SLDPRT

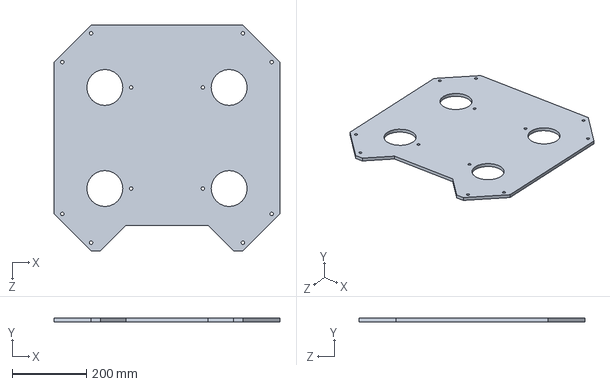
[picture p27: CAD file, 2025-05-07]
3D files/CAD parts/Spring 2025/Revision3/Plate1.SLDPRT
610.0 x 10.0 x 610.0 mm
