Robot-printer/ROV-project/3D files/CAD parts/Spring 2025/WIP/B02_1.2.SLDPRT

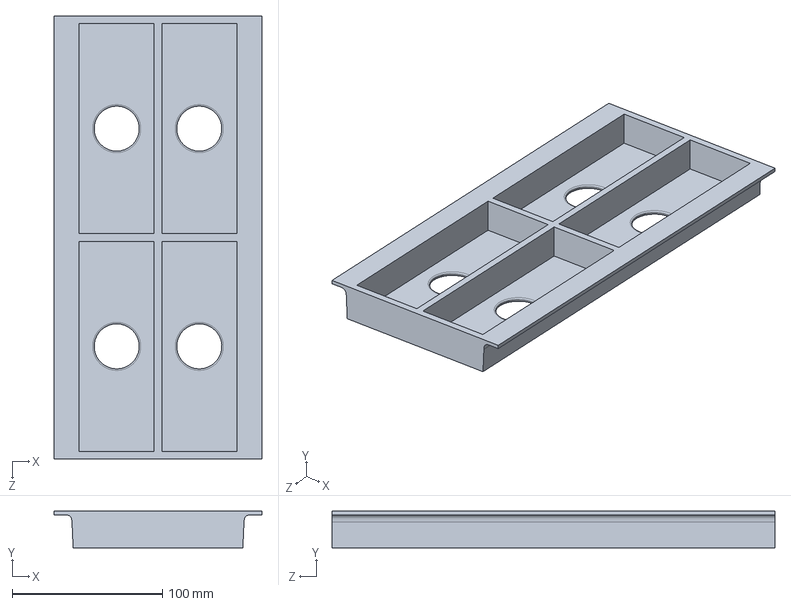
[picture p28: CAD file, 2025-02-06]
3D files/CAD parts/Spring 2025/WIP/B02_1.2.SLDPRT
138.4 x 24.5 x 295.0 mm
