Robot-printer/ROV-project/3D files/CAD parts/Spring 2025/Addison's CAD Files/Back faceplate MMGS.SLDPRT

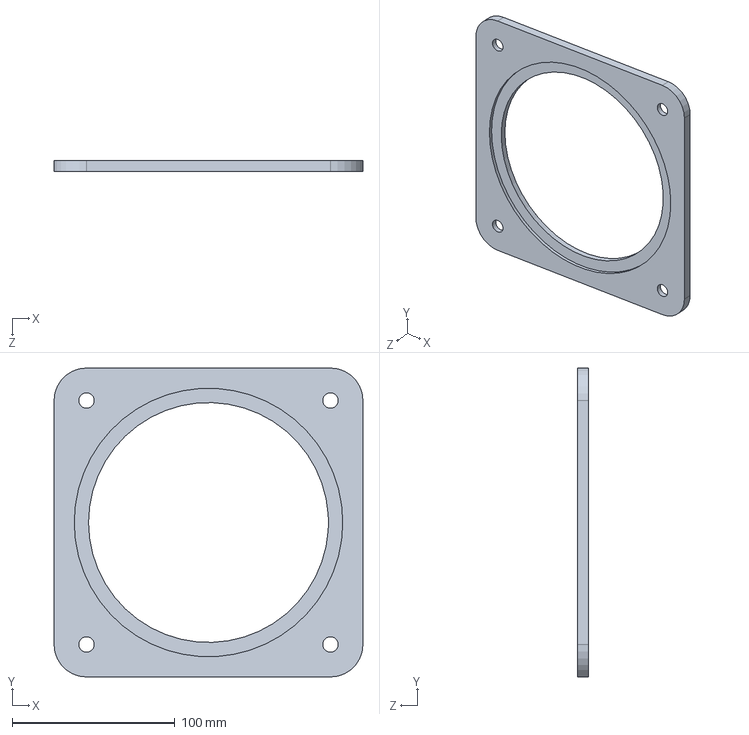
[picture p30: CAD file, 2025-04-10]
3D files/CAD parts/Spring 2025/Addison's CAD Files/Back faceplate MMGS.SLDPRT
190.0 x 190.0 x 6.75 mm
