Robot-printer/ROV-project/3D files/CAD parts/Spring 2025/Contemporary Parts/Electronics Tray 1.0 (WIP; Height subject to change).SLDPRT

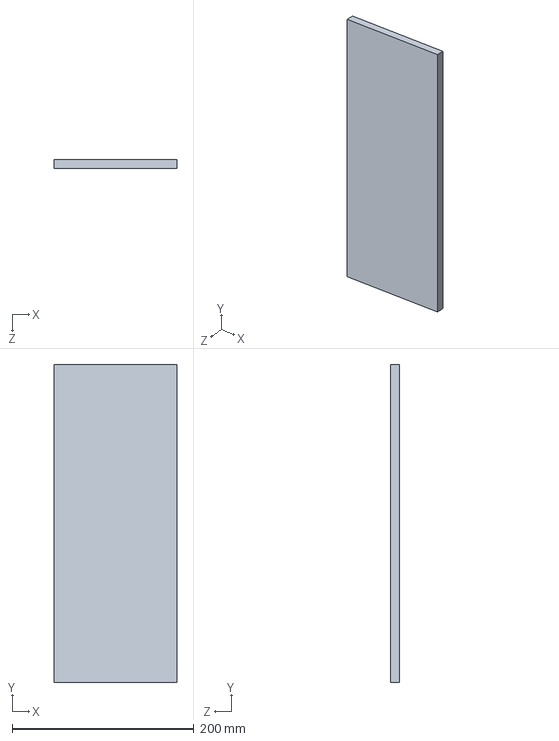
[picture p31: CAD file, 2025-02-06]
3D files/CAD parts/Spring 2025/Contemporary Parts/Electronics Tray 1.0 (WIP; Height subject to change).SLDPRT
135.0 x 350.0 x 10.0 mm
