Robot-printer/ROV-project/3D files/CAD parts/Spring 2025/Propeller FINAL.STEP

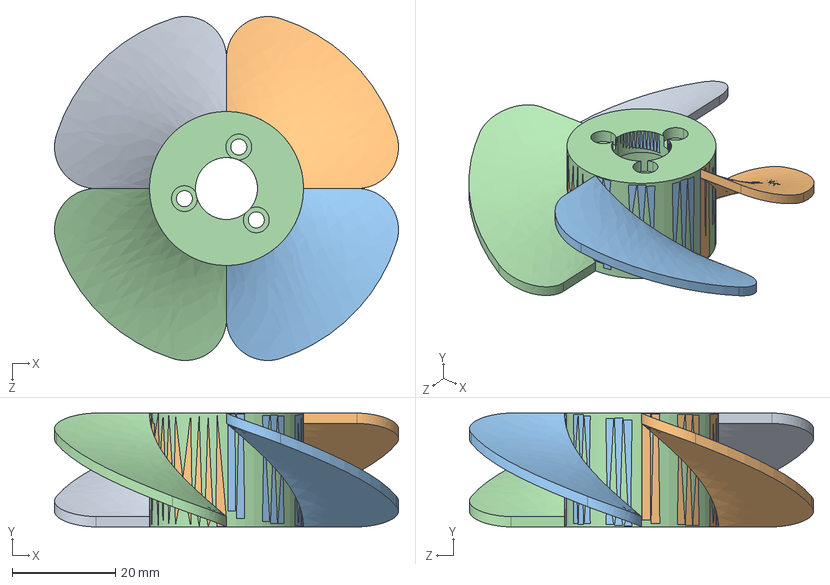
[picture p32: CAD file, 2025-07-30]
3D files/CAD parts/Spring 2025/Propeller FINAL.STEP
66.5 x 22.0 x 66.5 mm
