Robot-printer/ROV-project/3D files/CAD parts/Spring 2025/Revision3/Steel Rod.SLDPRT

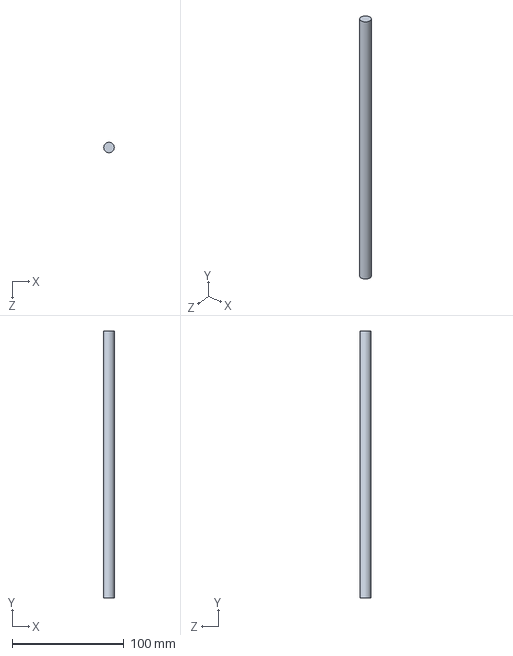
[picture p33: CAD file, 2025-05-07]
3D files/CAD parts/Spring 2025/Revision3/Steel Rod.SLDPRT
9.53 x 239.0 x 9.53 mm
