Robot-printer/ROV-project/3D files/Structure/T200 mounting bracket horizontal.SLDPRT

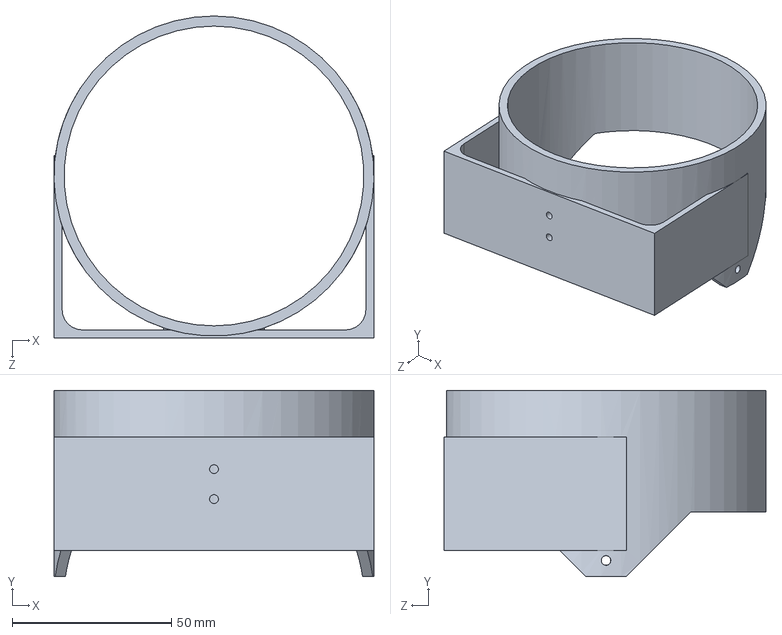
[picture p34: CAD file, 2025-01-29]
3D files/Structure/T200 mounting bracket horizontal.SLDPRT
100.3 x 58.4 x 101.0 mm
