Robot-printer/ROV-project/3D files/CAD parts/Active parts/Ranger-01/Vice Plate 002.SLDPRT

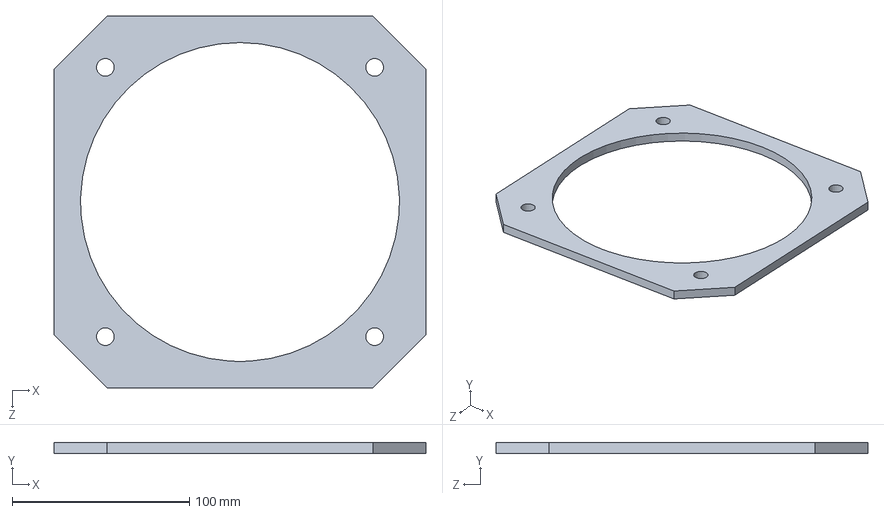
[picture p35: CAD file, 2025-07-10]
3D files/CAD parts/Active parts/Ranger-01/Vice Plate 002.SLDPRT
210.0 x 6.35 x 210.0 mm
