Robot-printer/ROV-project/3D files/CAD parts/Spring 2025/Addison's CAD Files/Front Endcap Updated mmgs.SLDPRT

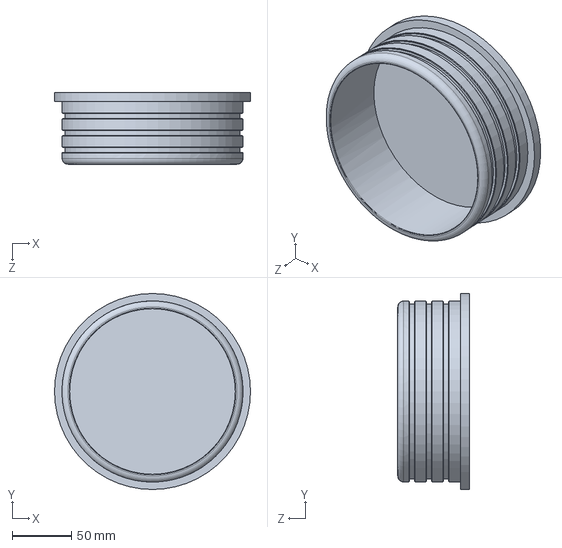
[picture p36: CAD file, 2025-04-10]
3D files/CAD parts/Spring 2025/Addison's CAD Files/Front Endcap Updated mmgs.SLDPRT
165.1 x 165.1 x 60.2 mm
