Robot-printer/ROV-project/3D files/CAD parts/Spring 2025/AUV Assembly/End Cap 012.SLDPRT

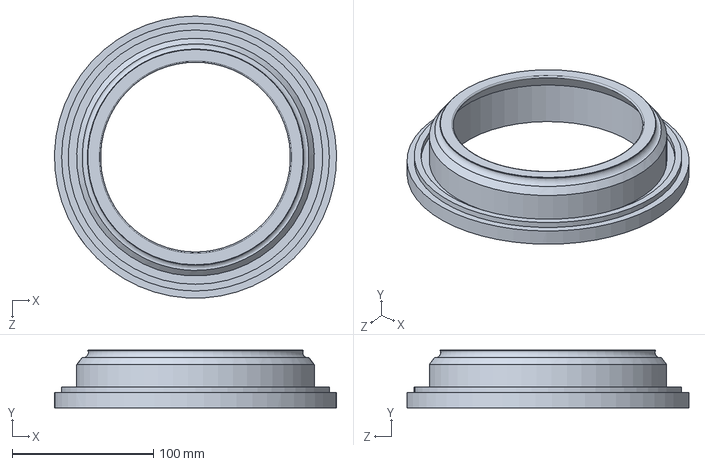
[picture p37: CAD file, 2025-05-23]
3D files/CAD parts/Spring 2025/AUV Assembly/End Cap 012.SLDPRT
199.9 x 41.0 x 199.8 mm
