Robot-printer/ROV-project/3D files/CAD parts/Spring 2025/Contemporary Parts/Side Wings 1.0.SLDPRT

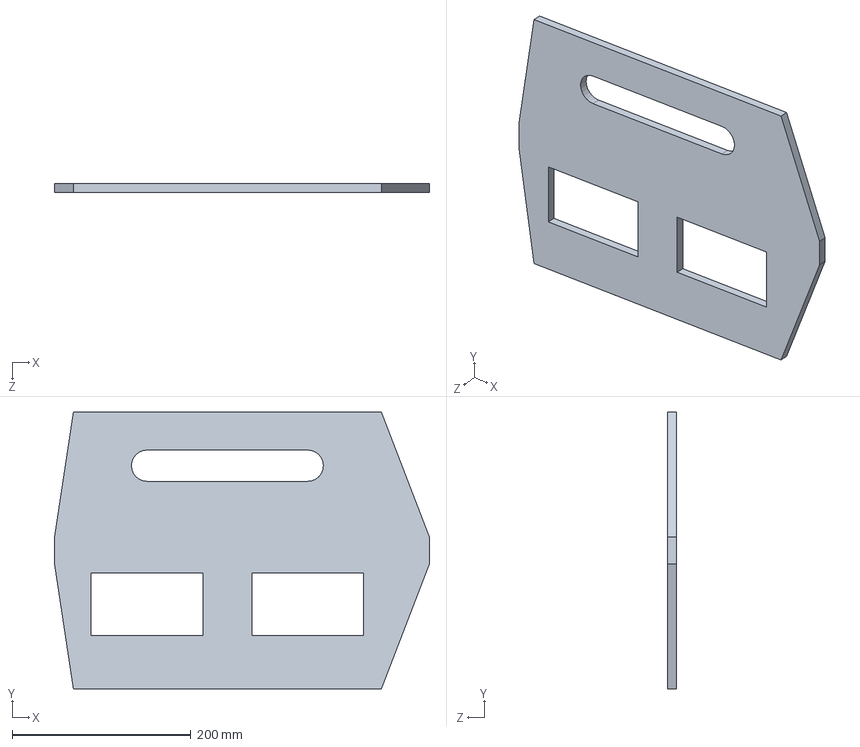
[picture p38: CAD file, 2025-02-06]
3D files/CAD parts/Spring 2025/Contemporary Parts/Side Wings 1.0.SLDPRT
420.0 x 310.0 x 10.0 mm
