Robot-printer/ROV-project/3D files/CAD parts/Spring 2025/Motor mount Hor 001 FINAL.SLDPRT

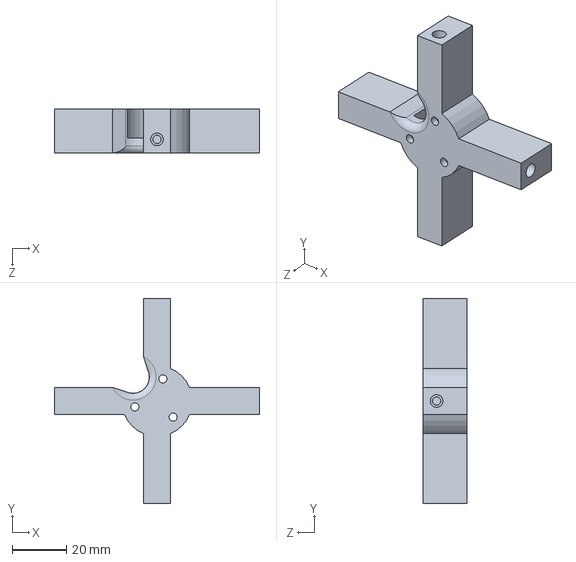
[picture p39: CAD file, 2025-07-30]
3D files/CAD parts/Spring 2025/Motor mount Hor 001 FINAL.SLDPRT
75.6 x 75.6 x 16.2 mm
