Robot-printer/ROV-project/3D files/CAD parts/Active parts/Ranger-01/Vert Steel Rod.SLDPRT

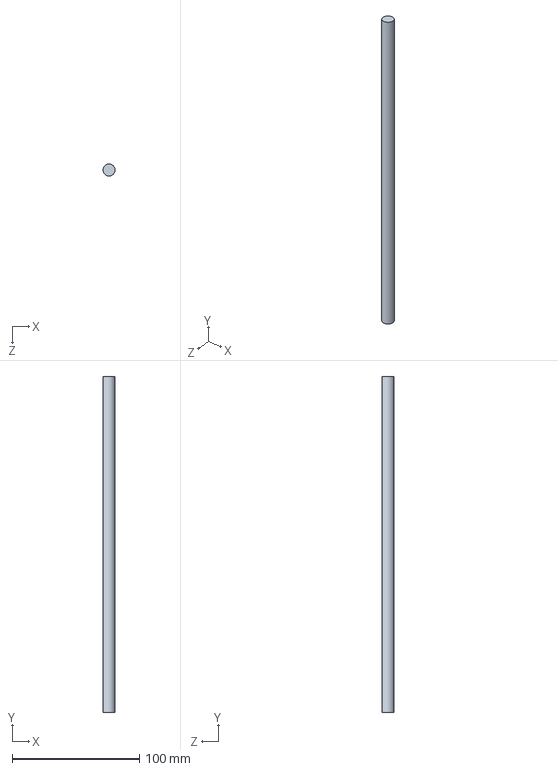
[picture p40: CAD file, 2025-07-10]
3D files/CAD parts/Active parts/Ranger-01/Vert Steel Rod.SLDPRT
9.49 x 264.0 x 9.51 mm
