Robot-printer/ROV-project/3D files/CAD parts/Spring 2025/Addison's CAD Files/Updated Bracket2 mmgs.SLDPRT

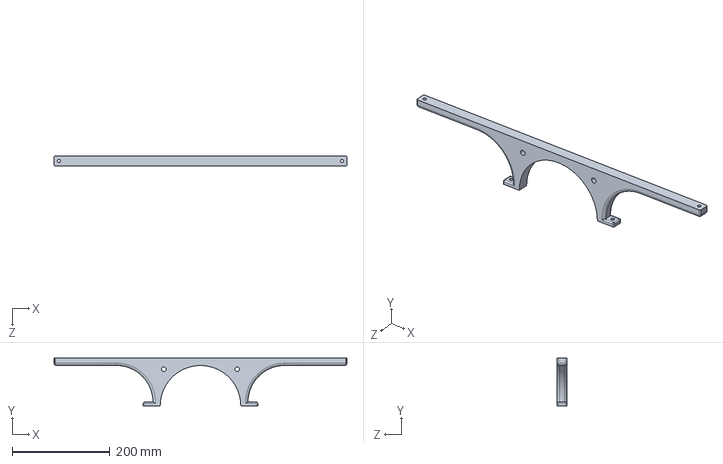
[picture p41: CAD file, 2025-04-10]
3D files/CAD parts/Spring 2025/Addison's CAD Files/Updated Bracket2 mmgs.SLDPRT
600.0 x 97.5 x 20.0 mm
