Robot-printer/ROV-project/3D files/CAD parts/Spring 2025/AUV Assembly/Plate1.SLDPRT

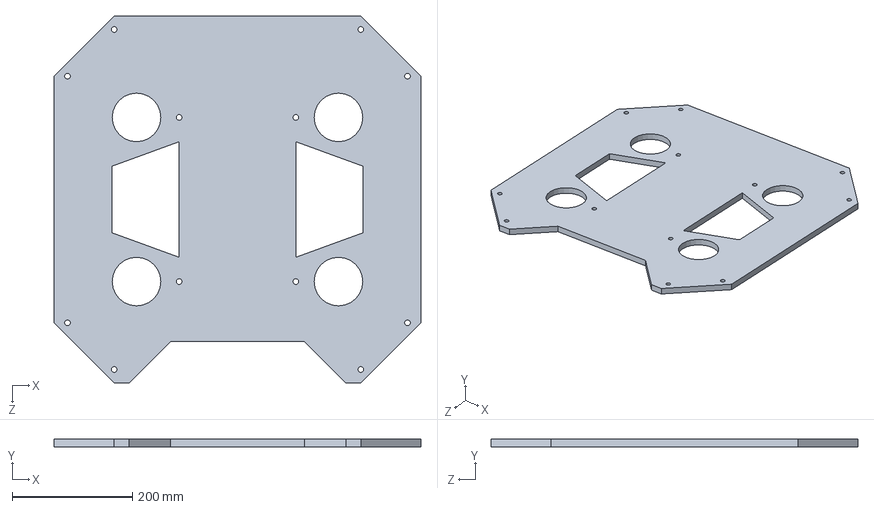
[picture p42: CAD file, 2025-05-23]
3D files/CAD parts/Spring 2025/AUV Assembly/Plate1.SLDPRT
610.0 x 12.7 x 610.0 mm
