Robot-printer/ROV-project/3D files/CAD parts/Spring 2025/Contemporary Parts/Side Flaps 1.0.SLDPRT

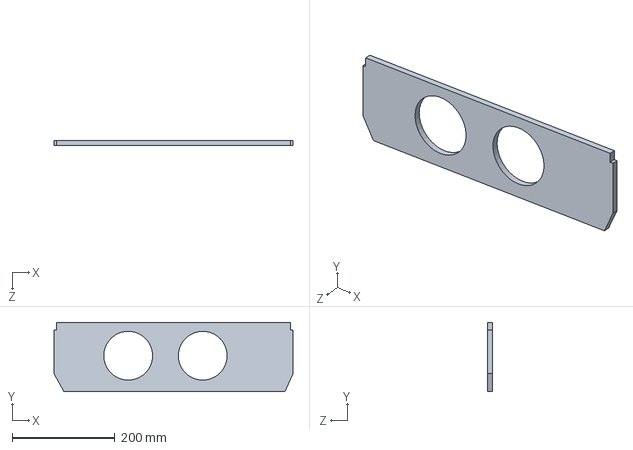
[picture p43: CAD file, 2025-02-06]
3D files/CAD parts/Spring 2025/Contemporary Parts/Side Flaps 1.0.SLDPRT
465.0 x 135.0 x 10.0 mm
