Robot-printer/ROV-project/3D files/CAD parts/Spring 2025/Revision3/Long steel rod.SLDPRT

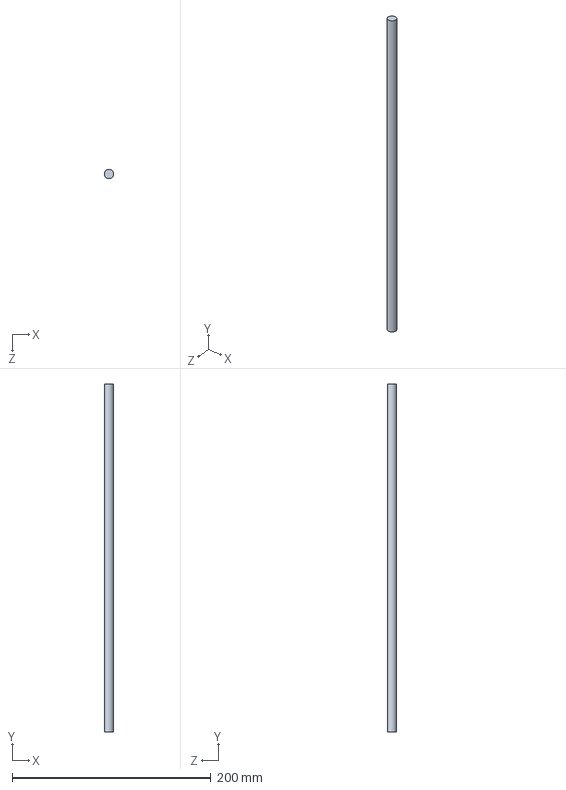
[picture p44: CAD file, 2025-05-07]
3D files/CAD parts/Spring 2025/Revision3/Long steel rod.SLDPRT
9.46 x 350.0 x 9.53 mm
