Robot-printer/ROV-project/3D files/Structure/Clear_Acrylic_Dome.SLDPRT

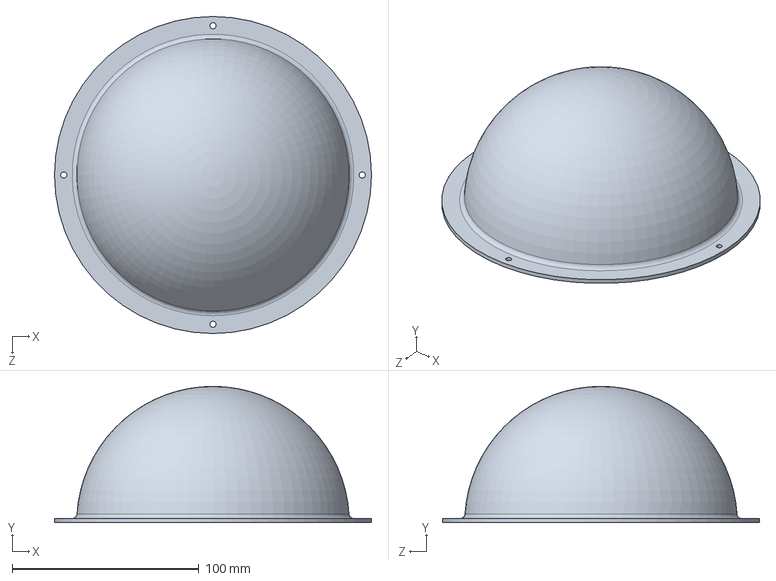
[picture p45: CAD file, 2025-01-29]
3D files/Structure/Clear_Acrylic_Dome.SLDPRT
169.9 x 73.0 x 169.9 mm
