Robot-printer/ROV-project/3D files/CAD parts/Spring 2025/Addison's CAD Files/Dome MMGS.SLDPRT

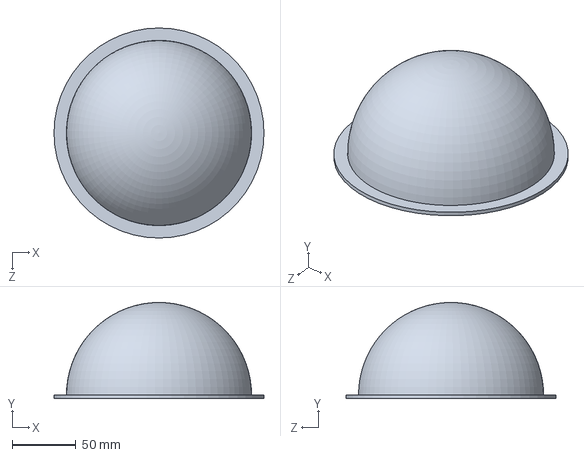
[picture p46: CAD file, 2025-04-10]
3D files/CAD parts/Spring 2025/Addison's CAD Files/Dome MMGS.SLDPRT
165.1 x 75.5 x 165.1 mm
