Robot-printer/ROV-project/3D files/CAD parts/Spring 2025/AUV Assembly/Hull Collar 003.SLDPRT

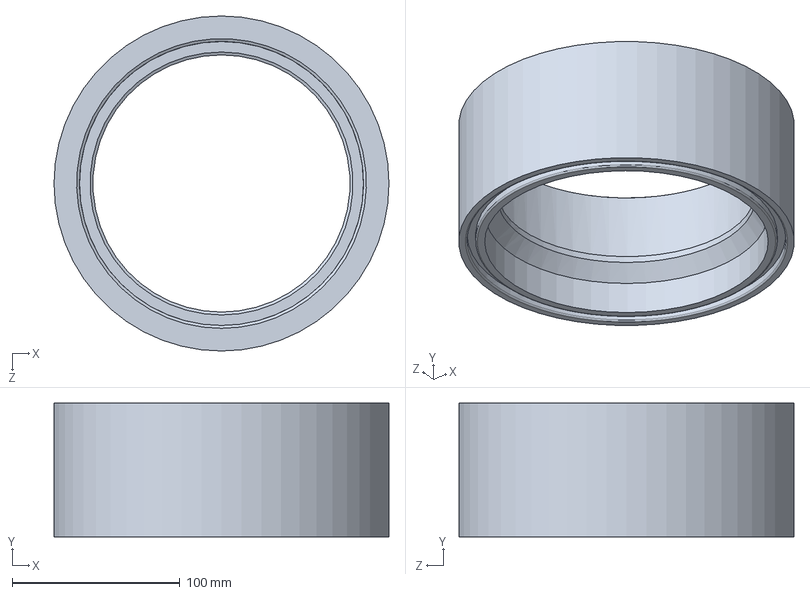
[picture p47: CAD file, 2025-05-23]
3D files/CAD parts/Spring 2025/AUV Assembly/Hull Collar 003.SLDPRT
200.0 x 80.0 x 200.0 mm
