Robot-printer/ROV-project/3D files/CAD parts/Spring 2025/Contemporary Parts/Central Pipe 1.0.SLDPRT

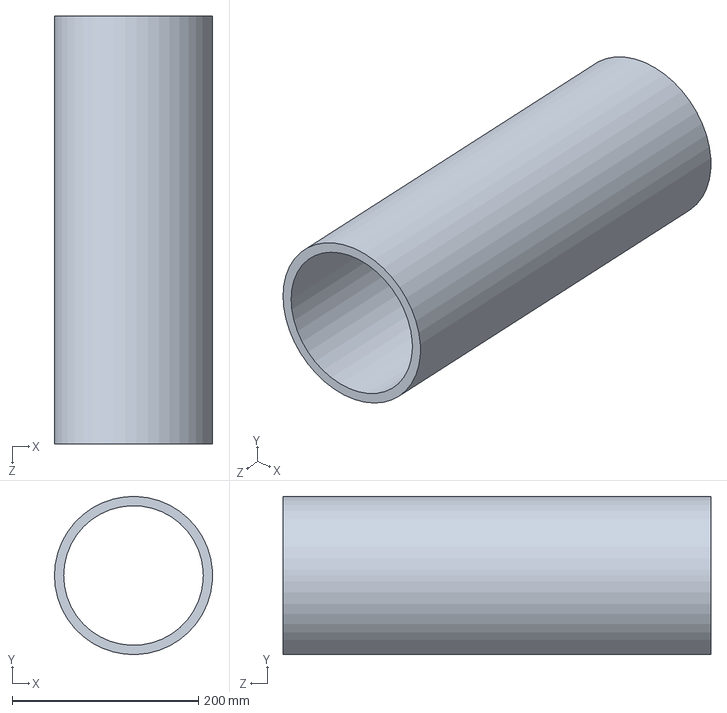
[picture p48: CAD file, 2025-02-06]
3D files/CAD parts/Spring 2025/Contemporary Parts/Central Pipe 1.0.SLDPRT
170.0 x 169.9 x 460.0 mm
