Robot-printer/ROV-project/3D files/CAD parts/Spring 2025/Revision3/Vert Shroud.SLDPRT

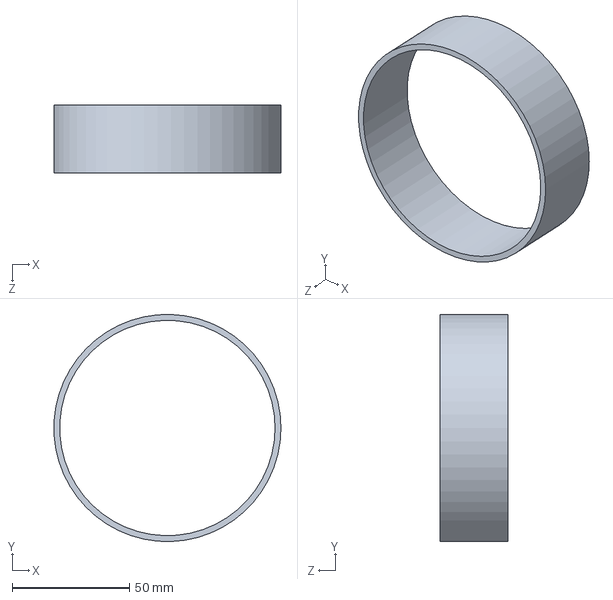
[picture p49: CAD file, 2025-05-07]
3D files/CAD parts/Spring 2025/Revision3/Vert Shroud.SLDPRT
96.9 x 97.0 x 29.0 mm
