Robot-printer/ROV-project/3D files/CAD parts/Active parts/Ranger-01/Dome 001.SLDPRT

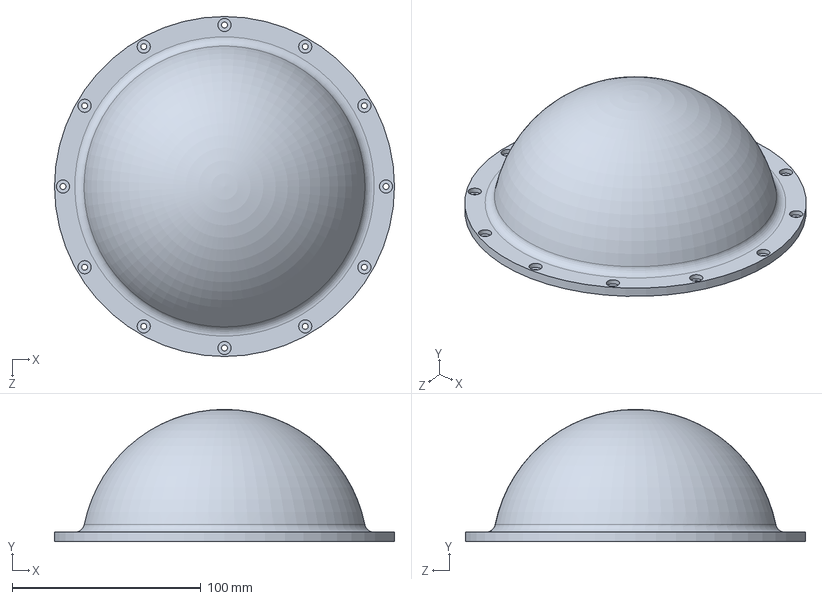
[picture p50: CAD file, 2025-07-10]
3D files/CAD parts/Active parts/Ranger-01/Dome 001.SLDPRT
180.0 x 70.0 x 180.0 mm
