Robot-printer/ROV-project/3D files/CAD parts/Spring 2025/Revision3/PVC Bracket.SLDPRT

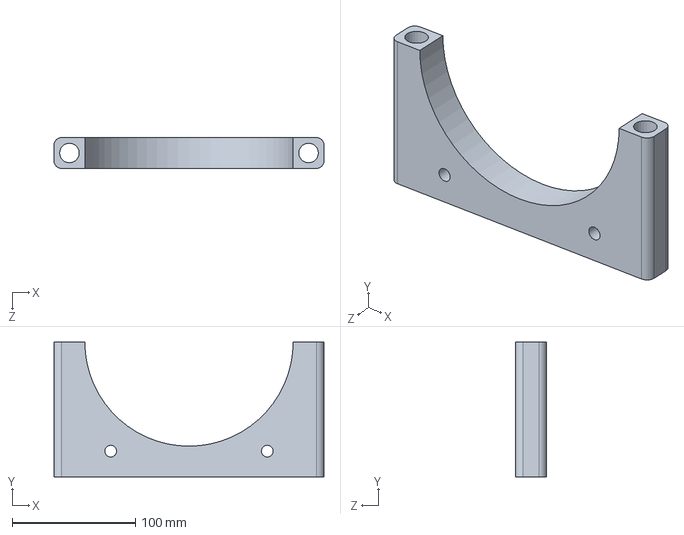
[picture p51: CAD file, 2025-05-07]
3D files/CAD parts/Spring 2025/Revision3/PVC Bracket.SLDPRT
219.0 x 109.5 x 25.0 mm
