Robot-printer/ROV-project/3D files/CAD parts/Active parts/Ranger-01/Horizontal Steel Rod.SLDPRT

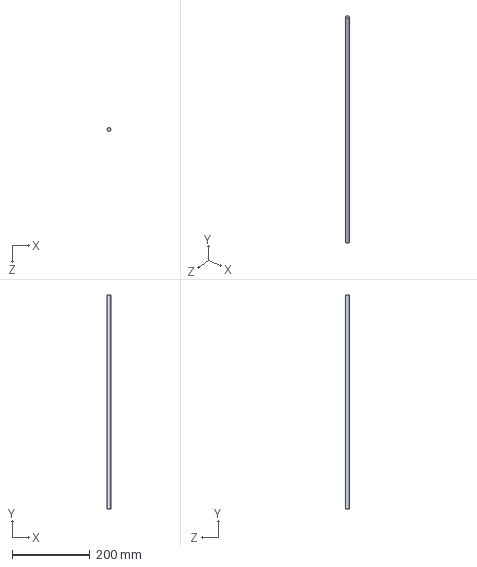
[picture p52: CAD file, 2025-07-10]
3D files/CAD parts/Active parts/Ranger-01/Horizontal Steel Rod.SLDPRT
9.53 x 550.0 x 9.53 mm
