Robot-printer/ROV-project/3D files/Structure/Rear Endcap v2.3mf

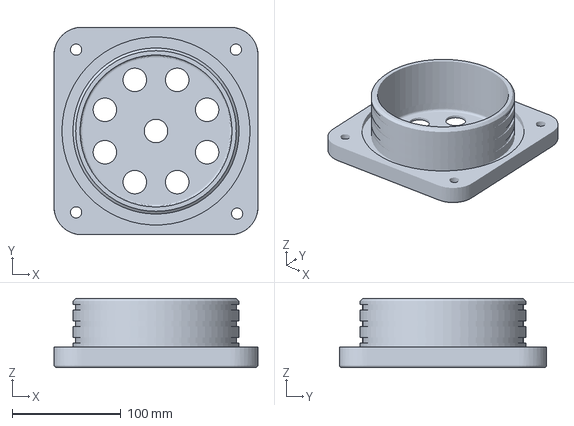
[picture p53: CAD file, 2025-01-29]
3D files/Structure/Rear Endcap v2.3mf
187.3 x 190.5 x 63.5 mm
