Robot-printer/ROV-project/3D files/CAD parts/Active parts/Ranger-01/Dome Spacer 001.SLDPRT

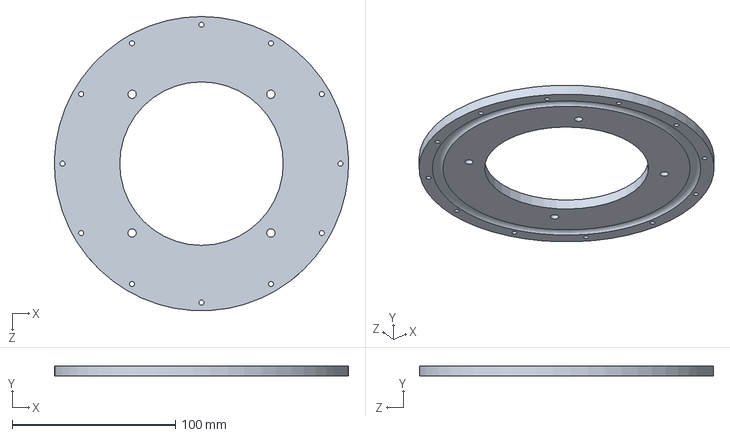
[picture p54: CAD file, 2025-07-10]
3D files/CAD parts/Active parts/Ranger-01/Dome Spacer 001.SLDPRT
179.9 x 6.35 x 179.8 mm
