Robot-printer/ROV-project/3D files/CAD parts/Spring 2025/AUV Assembly/Front dome.SLDPRT

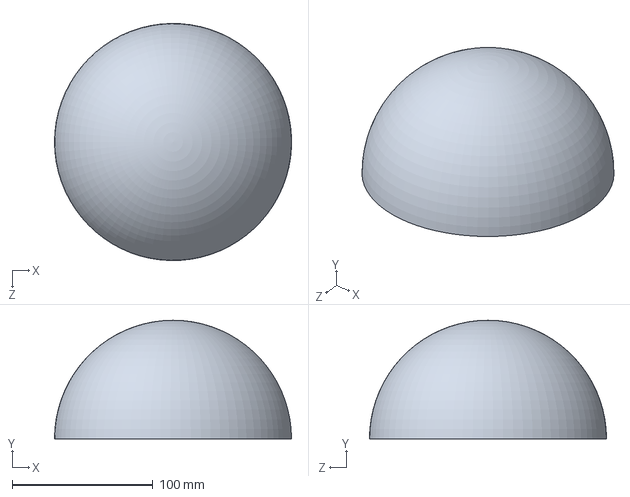
[picture p55: CAD file, 2025-05-07]
3D files/CAD parts/Spring 2025/AUV Assembly/Front dome.SLDPRT
168.4 x 84.2 x 168.5 mm
