Robot-printer/ROV-project/3D files/CAD parts/Active parts/Ranger-01/Plate1.SLDPRT

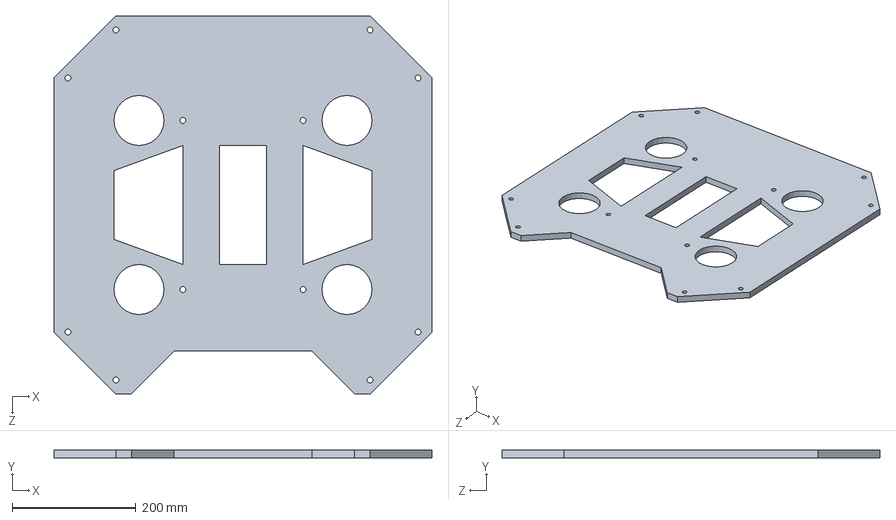
[picture p56: CAD file, 2025-07-10]
3D files/CAD parts/Active parts/Ranger-01/Plate1.SLDPRT
610.0 x 12.7 x 610.0 mm
