Robot-printer/ROV-project/3D files/CAD parts/Spring 2025/AUV Assembly/PVC Pipe.SLDPRT

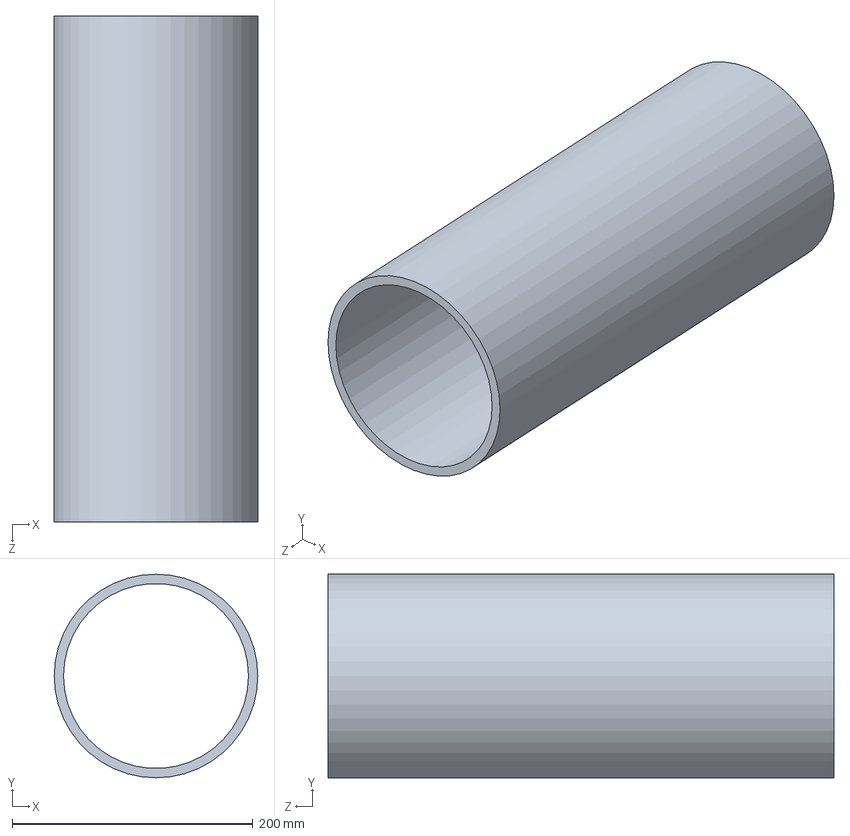
[picture p57: CAD file, 2025-05-07]
3D files/CAD parts/Spring 2025/AUV Assembly/PVC Pipe.SLDPRT
169.0 x 169.0 x 420.0 mm
