Robot-printer/ROV-project/3D files/Structure/Side Frame Panel [PORT]v2.SLDPRT

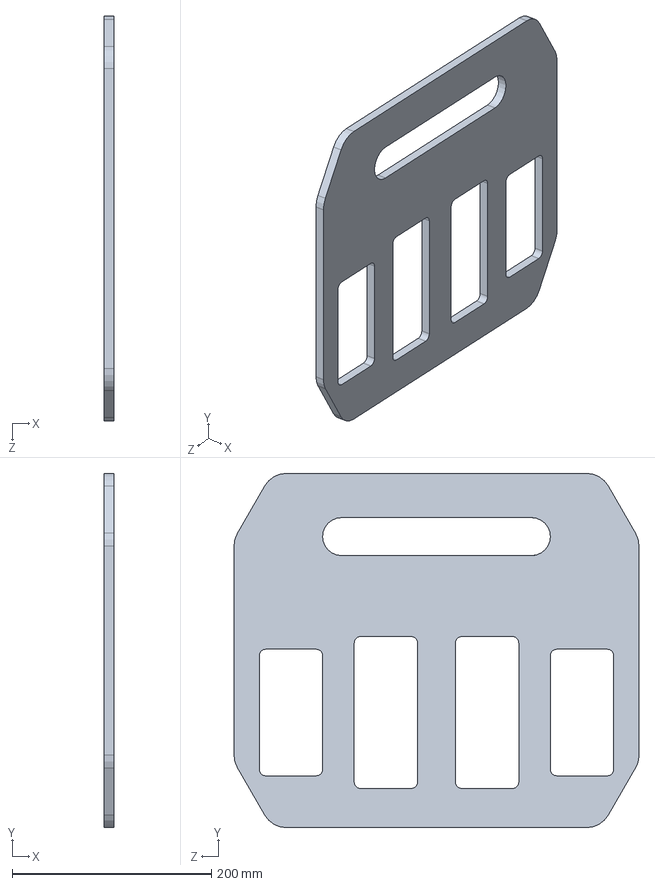
[picture p58: CAD file, 2025-01-29]
3D files/Structure/Side Frame Panel [PORT]v2.SLDPRT
10.2 x 355.6 x 406.4 mm
