Robot-printer/ROV-project/3D files/Structure/Front_cap thin.3MF

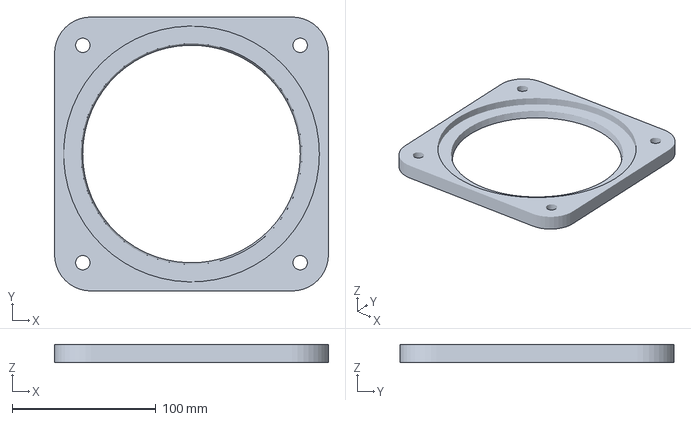
[picture p59: CAD file, 2025-01-29]
3D files/Structure/Front_cap thin.3MF
190.5 x 190.5 x 12.7 mm
