Robot-printer/ROV-project/3D files/CAD parts/Active parts/Ranger-01/Fan Blades.SLDPRT

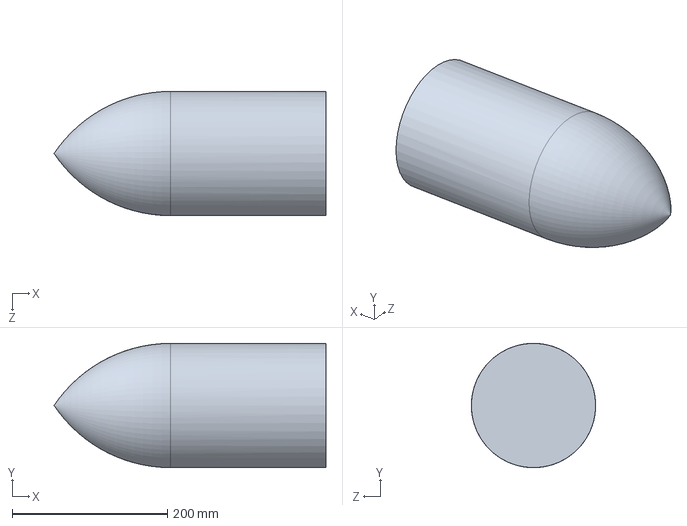
[picture p60: CAD file, 2025-07-10]
3D files/CAD parts/Active parts/Ranger-01/Fan Blades.SLDPRT
350.0 x 160.0 x 160.0 mm
