Robot-printer/ROV-project/3D files/Structure/Cage_Side.SLDPRT

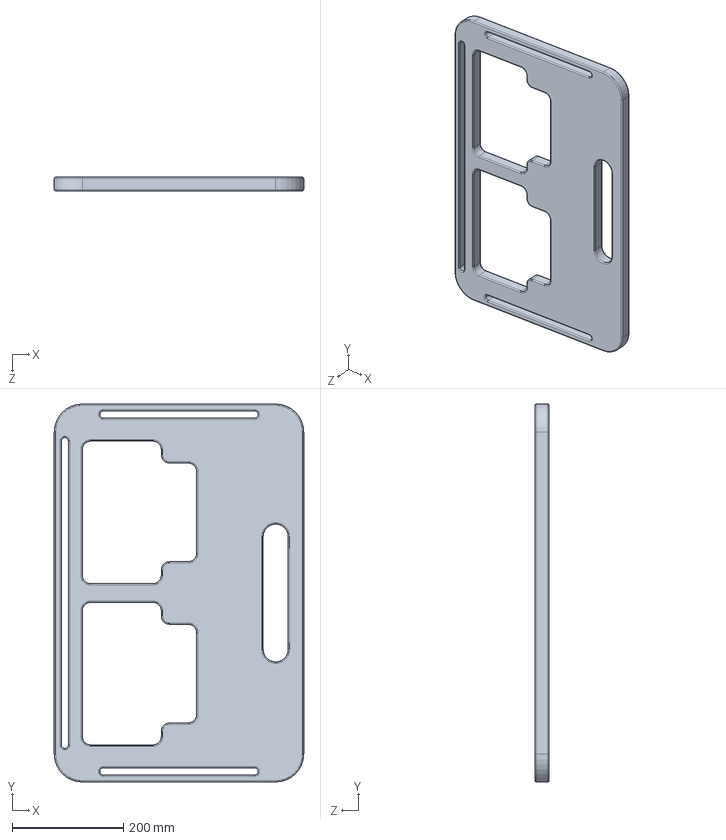
[picture p61: CAD file, 2025-01-29]
3D files/Structure/Cage_Side.SLDPRT
449.2 x 680.5 x 25.4 mm
