Robot-printer/ROV-project/3D files/CAD parts/Active parts/Ranger-01/Hull Collar 007.SLDPRT

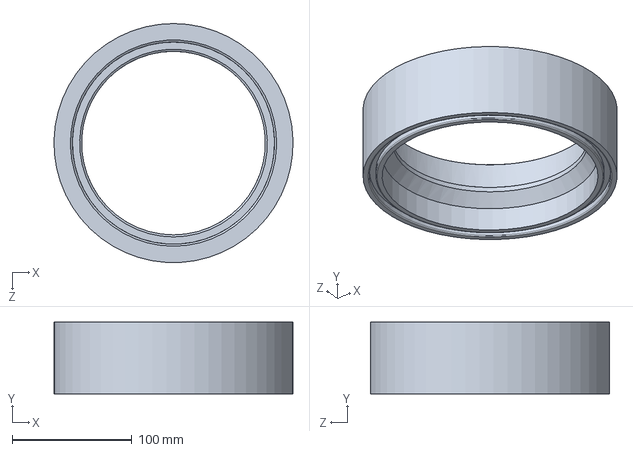
[picture p62: CAD file, 2025-07-10]
3D files/CAD parts/Active parts/Ranger-01/Hull Collar 007.SLDPRT
199.9 x 60.0 x 199.8 mm
