Robot-printer/ROV-project/3D files/Structure/Endcap thin.SLDPRT

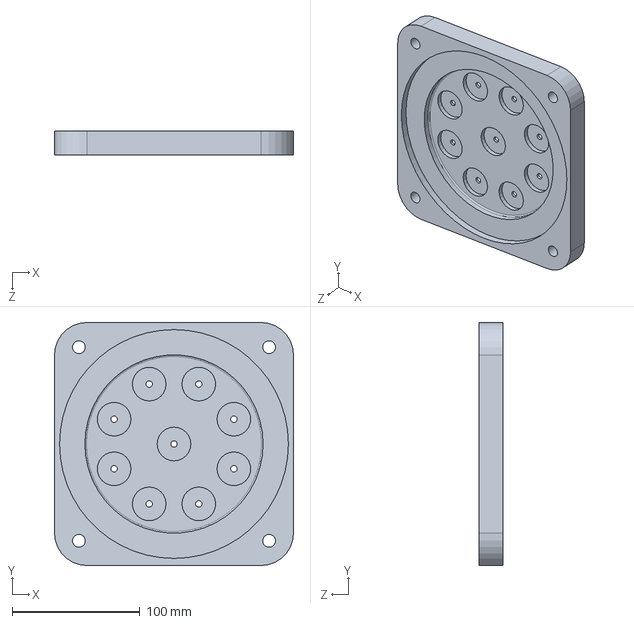
[picture p63: CAD file, 2025-01-29]
3D files/Structure/Endcap thin.SLDPRT
187.3 x 190.5 x 19.1 mm
