Robot-printer/ROV-project/3D files/CAD parts/Active parts/Ranger-01/End Cap 017 Hole Face Wetlinks.SLDPRT

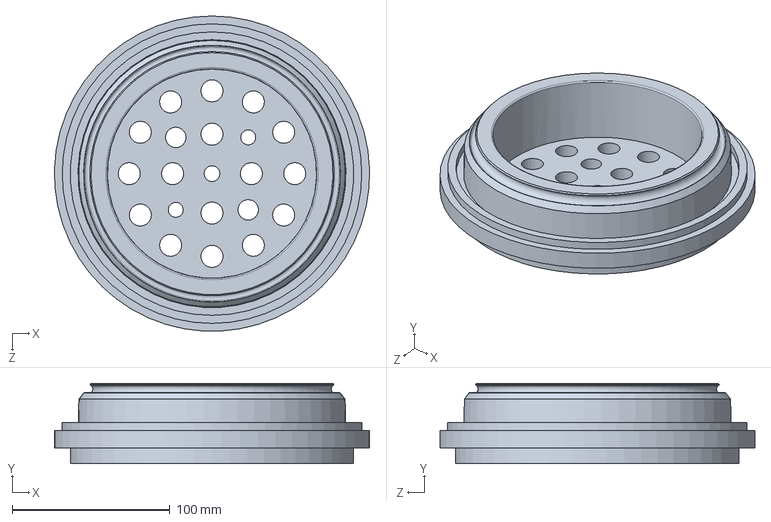
[picture p64: CAD file, 2025-07-10]
3D files/CAD parts/Active parts/Ranger-01/End Cap 017 Hole Face Wetlinks.SLDPRT
199.9 x 51.0 x 199.8 mm
