Robot-printer/ROV-project/3D files/Structure/Side Frame Panel [PORT].SLDPRT

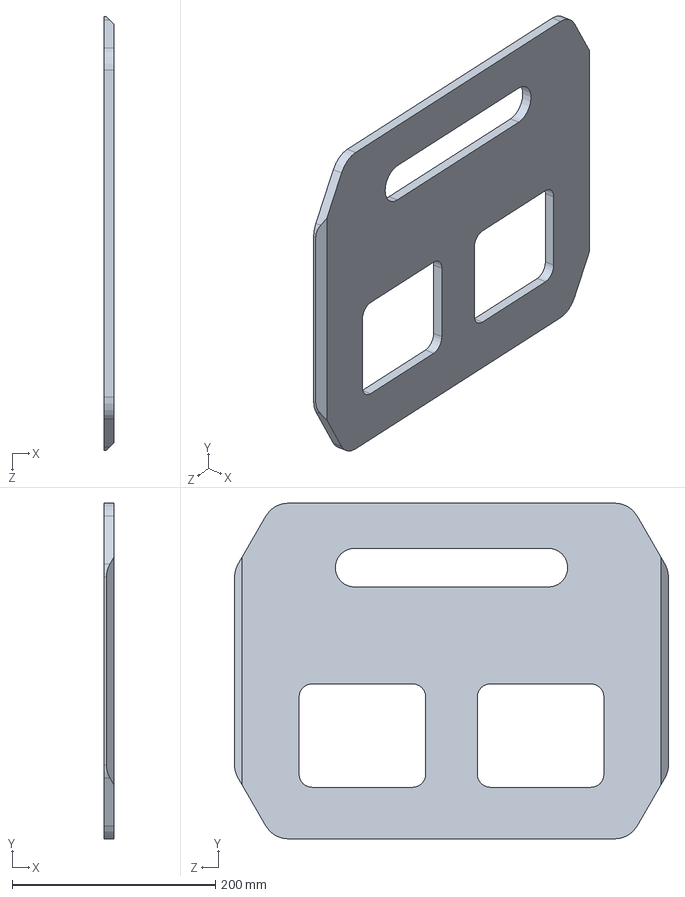
[picture p65: CAD file, 2025-01-29]
3D files/Structure/Side Frame Panel [PORT].SLDPRT
10.2 x 330.2 x 426.7 mm
