Robot-printer/ROV-project/3D files/CAD parts/Active parts/Ranger-01/AUVMotorSupport.SLDPRT

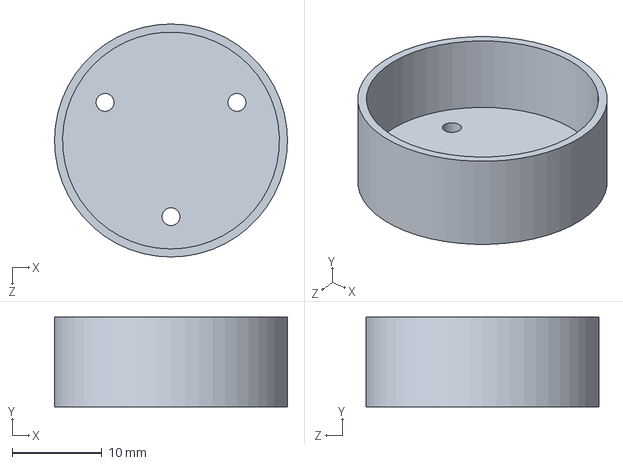
[picture p66: CAD file, 2025-04-10]
3D files/CAD parts/Active parts/Ranger-01/AUVMotorSupport.SLDPRT
26.0 x 10.0 x 26.0 mm
