Robot-printer/ROV-project/3D files/Structure/T200 mounting bracket round V2.SLDPRT

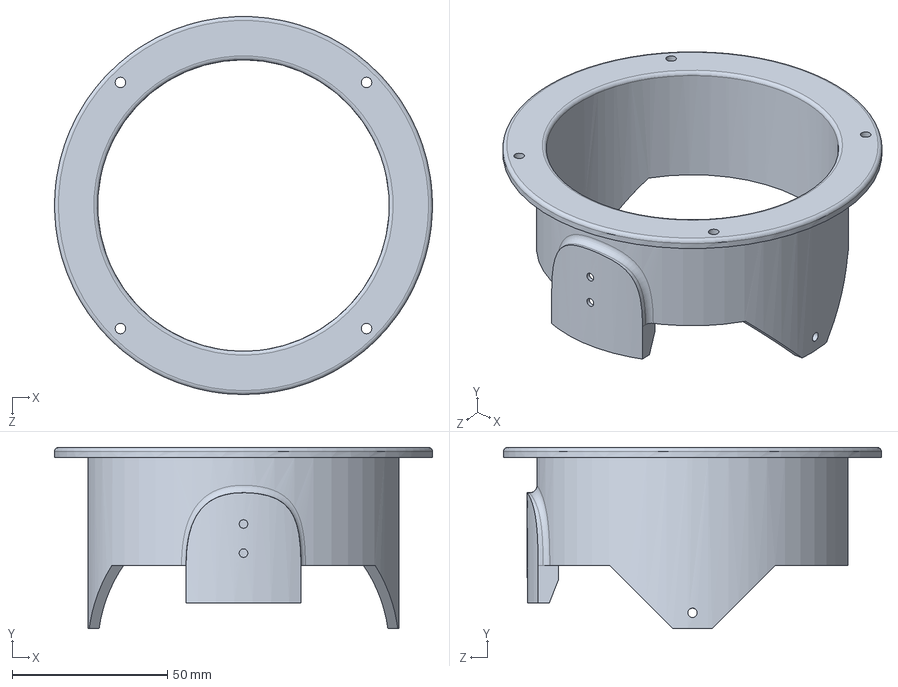
[picture p67: CAD file, 2025-01-29]
3D files/Structure/T200 mounting bracket round V2.SLDPRT
121.9 x 58.4 x 121.9 mm
