Robot-printer/ROV-project/3D files/CAD parts/Active parts/Ranger-01/Vertical Nacelles.SLDPRT

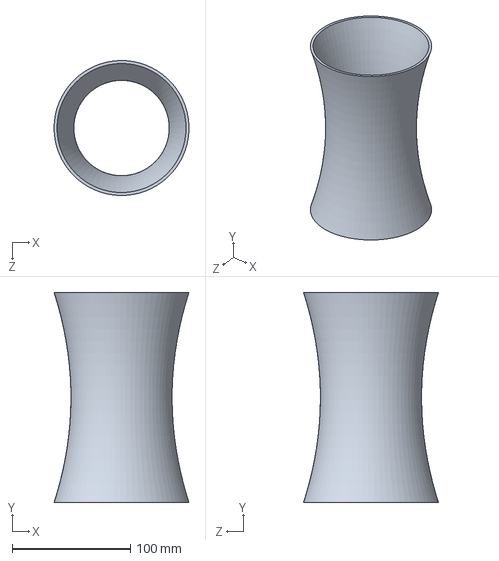
[picture p68: CAD file, 2025-04-10]
3D files/CAD parts/Active parts/Ranger-01/Vertical Nacelles.SLDPRT
114.2 x 177.8 x 114.3 mm
