Robot-printer/ROV-project/3D files/CAD parts/Active parts/Ranger-01/S01_1.2.SLDPRT

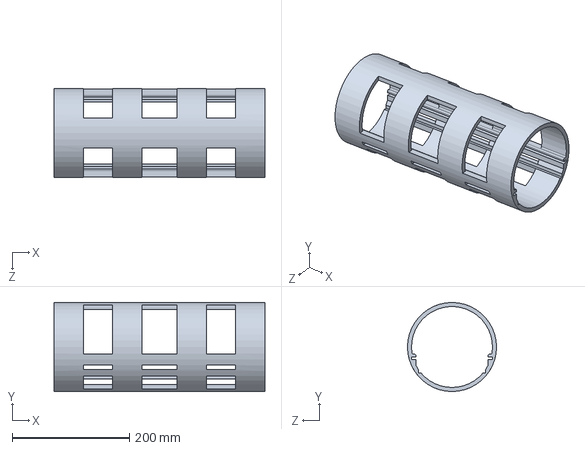
[picture p69: CAD file, 2025-02-06]
3D files/CAD parts/Active parts/Ranger-01/S01_1.2.SLDPRT
360.0 x 152.0 x 152.0 mm
