Robot-printer/ROV-project/3D files/CAD parts/Active parts/Ranger-01/E03_2.1.SLDPRT

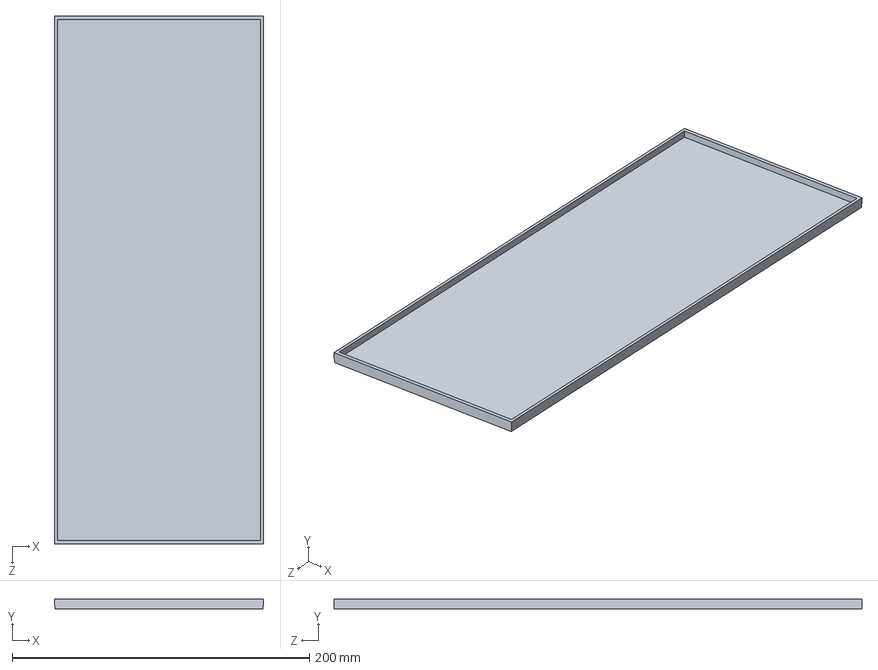
[picture p70: CAD file, 2025-02-06]
3D files/CAD parts/Active parts/Ranger-01/E03_2.1.SLDPRT
140.6 x 7.00 x 355.0 mm
