Robot-printer/ROV-project/3D files/Structure/Pi_Cam_Plate.SLDPRT

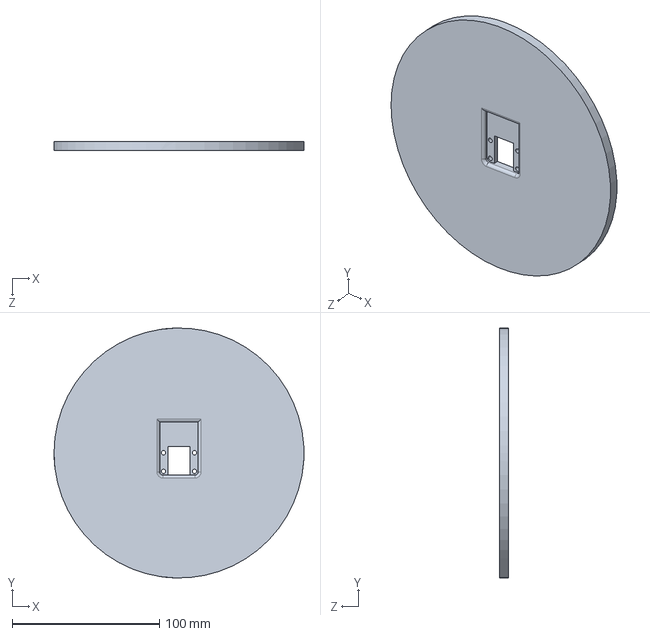
[picture p71: CAD file, 2025-01-29]
3D files/Structure/Pi_Cam_Plate.SLDPRT
169.9 x 169.8 x 6.35 mm
