Robot-printer/ROV-project/3D files/CAD parts/Active parts/Ranger-01/B02_1.1.SLDPRT

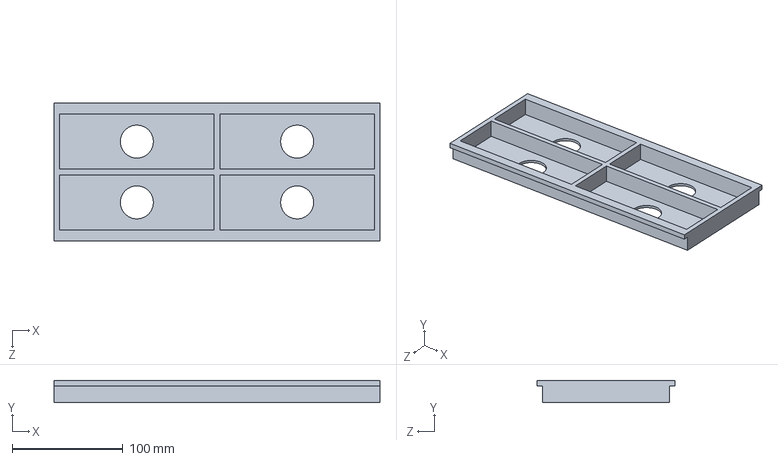
[picture p72: CAD file, 2025-02-06]
3D files/CAD parts/Active parts/Ranger-01/B02_1.1.SLDPRT
295.0 x 20.0 x 125.0 mm
