Robot-printer/ROV-project/3D files/Structure/Brackets.SLDPRT

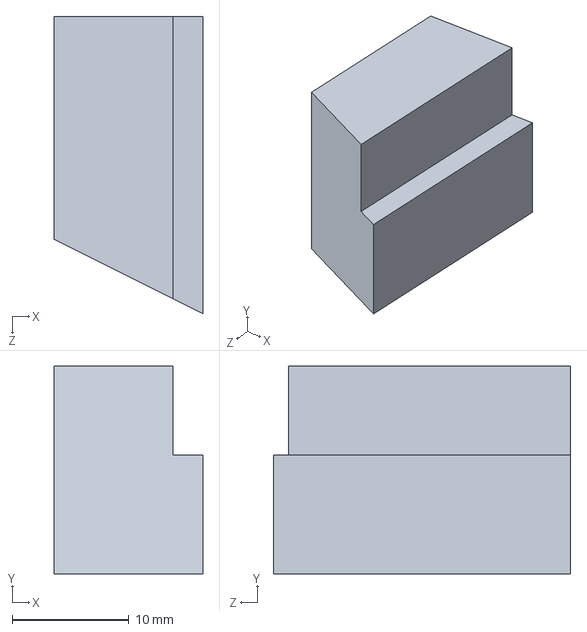
[picture p73: CAD file, 2025-01-29]
3D files/Structure/Brackets.SLDPRT
12.7 x 17.8 x 25.4 mm
