Robot-printer/ROV-project/3D files/CAD parts/Active parts/Ranger-01/S01_1.1.SLDPRT

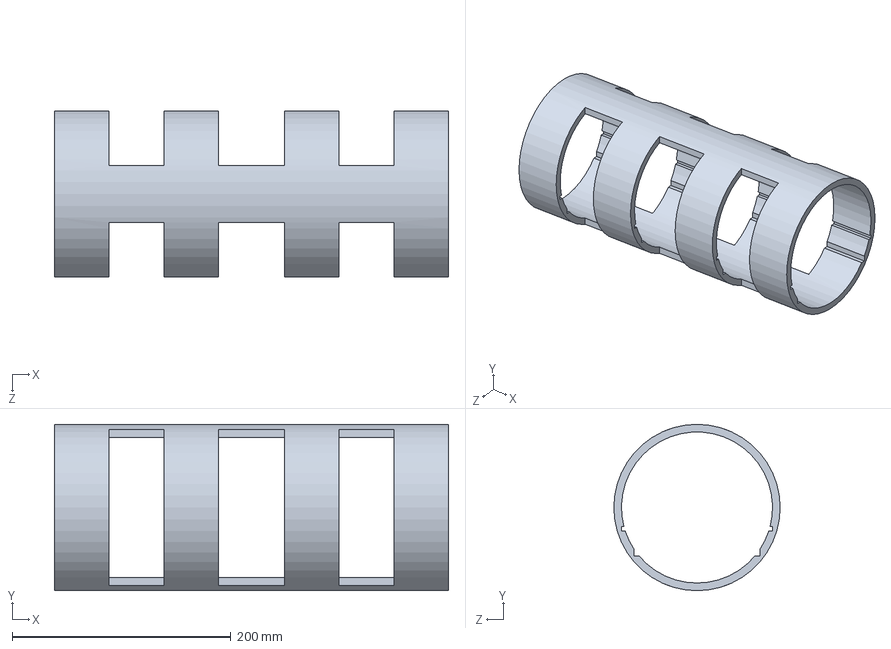
[picture p74: CAD file, 2025-02-06]
3D files/CAD parts/Active parts/Ranger-01/S01_1.1.SLDPRT
360.0 x 152.0 x 152.0 mm
