Robot-printer/ROV-project/3D files/CAD parts/Active parts/Ranger-01/E01_1.1.SLDPRT

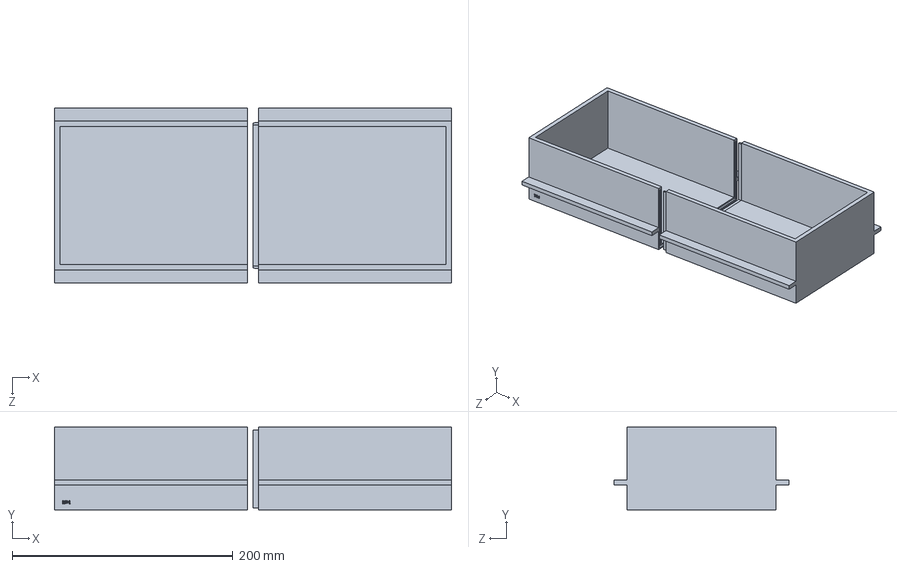
[picture p75: CAD file, 2025-02-06]
3D files/CAD parts/Active parts/Ranger-01/E01_1.1.SLDPRT
360.0 x 75.0 x 158.4 mm
