Robot-printer/ROV-project/3D files/Structure/T200 mounting bracket.SLDPRT

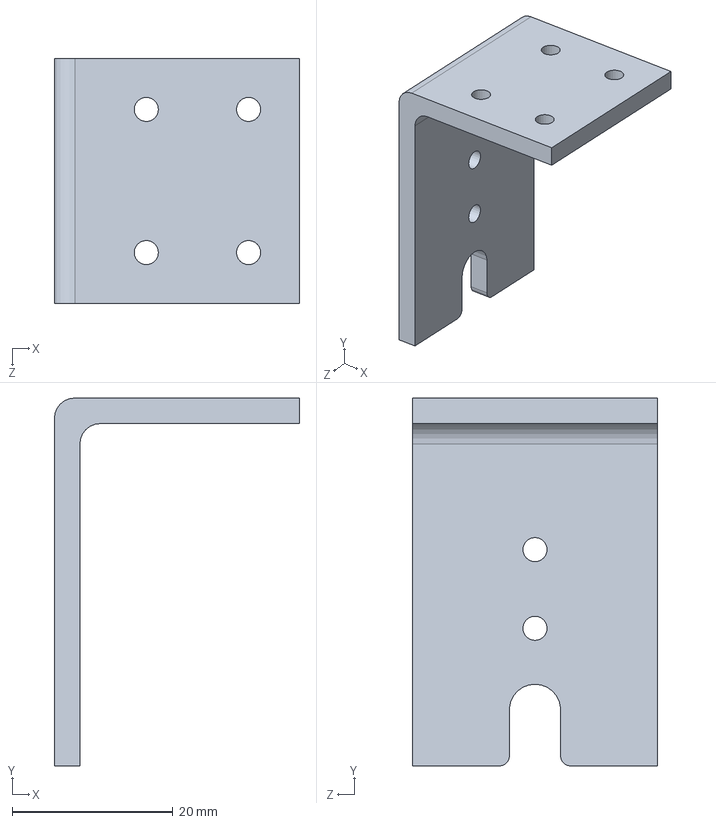
[picture p76: CAD file, 2025-01-29]
3D files/Structure/T200 mounting bracket.SLDPRT
30.5 x 45.7 x 30.5 mm
