Robot-printer/ROV-project/3D files/CAD parts/Active parts/Ranger-01/W02_1.1.SLDPRT

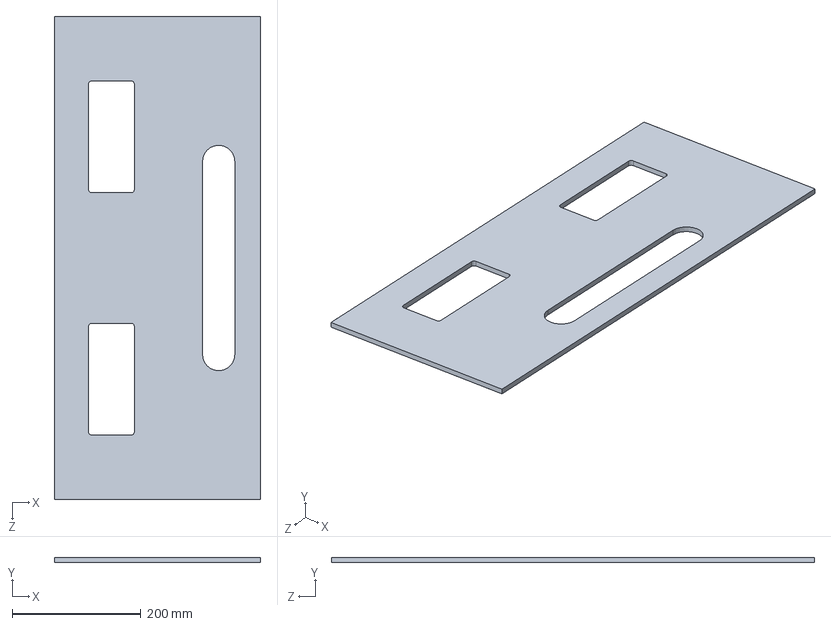
[picture p77: CAD file, 2025-02-06]
3D files/CAD parts/Active parts/Ranger-01/W02_1.1.SLDPRT
320.0 x 8.00 x 750.0 mm
