Robot-printer/ROV-project/3D files/CAD parts/Active parts/Ranger-01/W01_1.1.SLDPRT

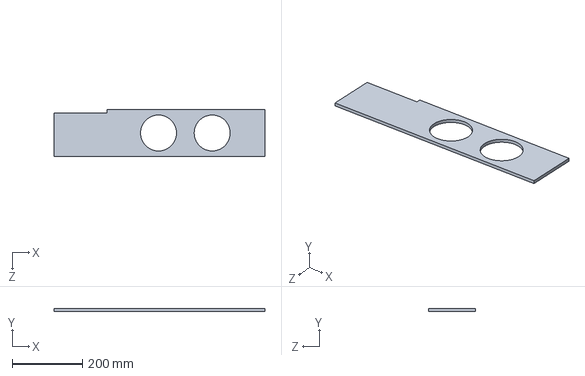
[picture p78: CAD file, 2025-02-06]
3D files/CAD parts/Active parts/Ranger-01/W01_1.1.SLDPRT
600.0 x 8.00 x 135.0 mm
