Robot-printer/ROV-project/3D files/Structure/Side Frame Panel [STBD].SLDPRT

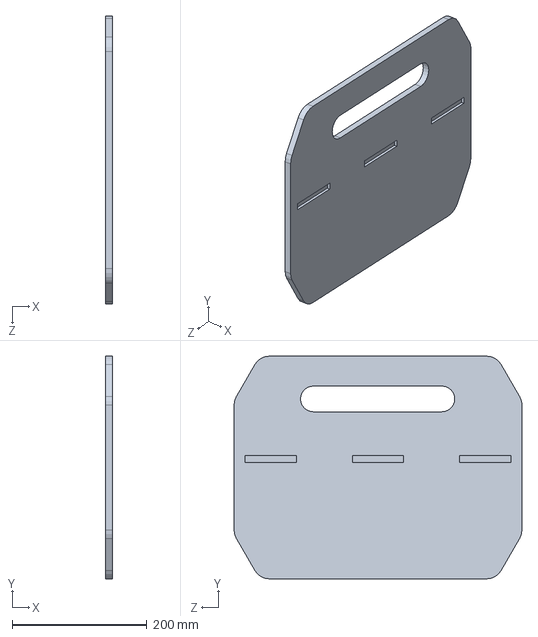
[picture p79: CAD file, 2025-01-29]
3D files/Structure/Side Frame Panel [STBD].SLDPRT
10.2 x 330.2 x 426.7 mm
