Robot-printer/ROV-project/3D files/Structure/Clear_PVC_Pipe.SLDPRT

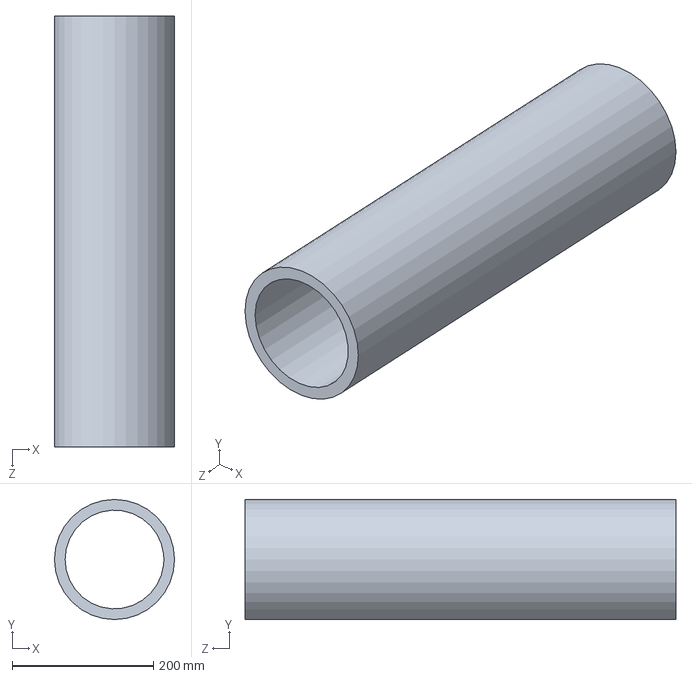
[picture p80: CAD file, 2025-01-29]
3D files/Structure/Clear_PVC_Pipe.SLDPRT
169.9 x 169.9 x 609.6 mm
