Robot-printer/ROV-project/3D files/Structure/T200 mounting bracket round.SLDPRT

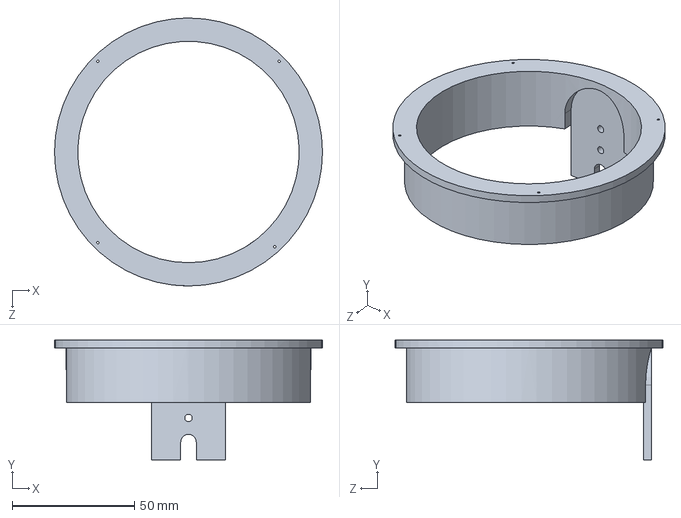
[picture p81: CAD file, 2025-01-29]
3D files/Structure/T200 mounting bracket round.SLDPRT
109.5 x 48.9 x 109.5 mm
