Robot-printer/ROV-project/3D files/Structure/Rear Endcap Inner TEST.SLDPRT

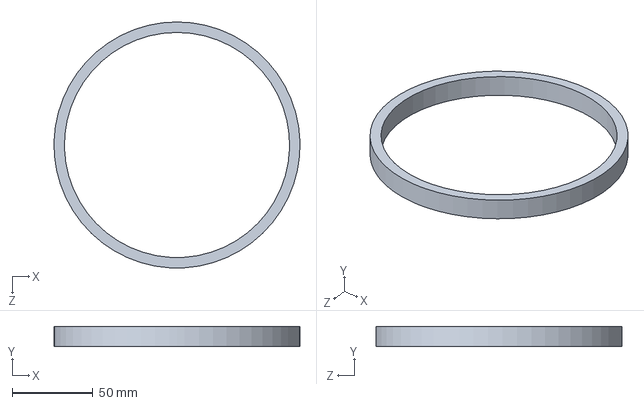
[picture p82: CAD file, 2025-01-29]
3D files/Structure/Rear Endcap Inner TEST.SLDPRT
152.4 x 12.7 x 152.5 mm
