Robot-printer/ROV-project/3D files/Structure/Cam servo mount.STEP

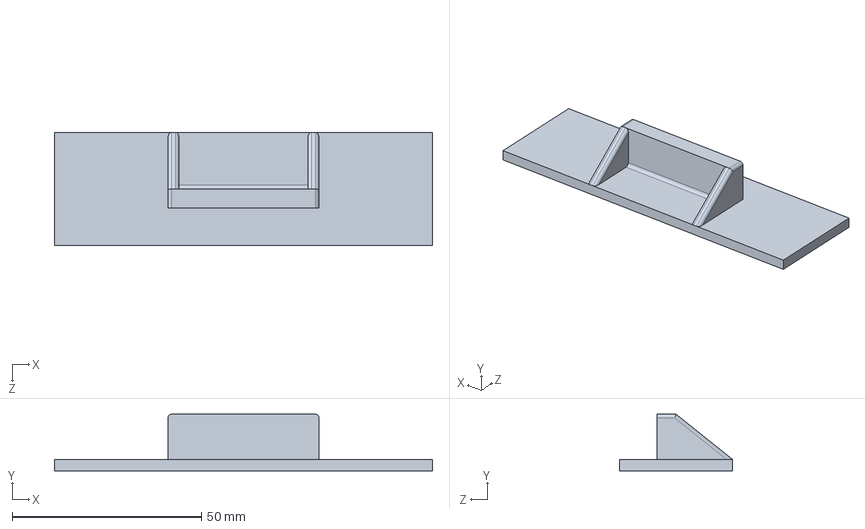
[picture p83: CAD file, 2025-01-29]
3D files/Structure/Cam servo mount.STEP
100.0 x 15.0 x 30.0 mm
