Robot-printer/ROV-project/3D files/Structure/T200 mounting bracket vertical.STL

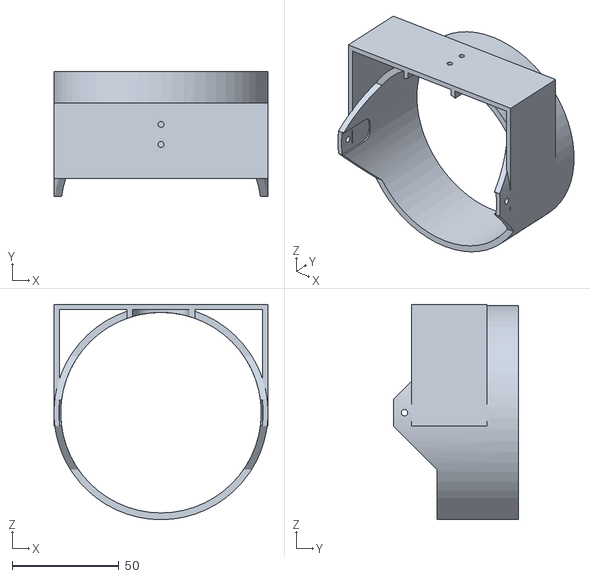
[picture p84: CAD file, 2025-01-29]
3D files/Structure/T200 mounting bracket vertical.STL
100.3 x 58.4 x 101.0
