Robot-printer/ROV-project/3D files/Structure/Endcap_inner_cap.SLDPRT

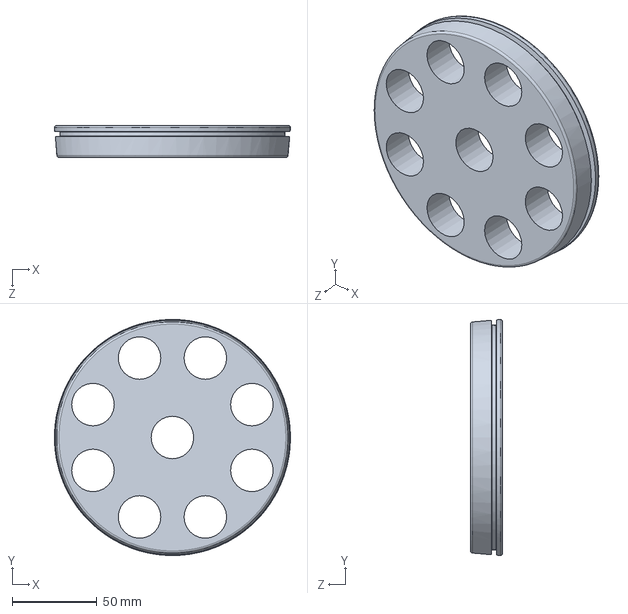
[picture p85: CAD file, 2025-01-29]
3D files/Structure/Endcap_inner_cap.SLDPRT
139.4 x 139.4 x 19.1 mm
