Robot-printer/ROV-project/3D files/Structure/Rear Endcap Inner-JamesSanPC.SLDPRT

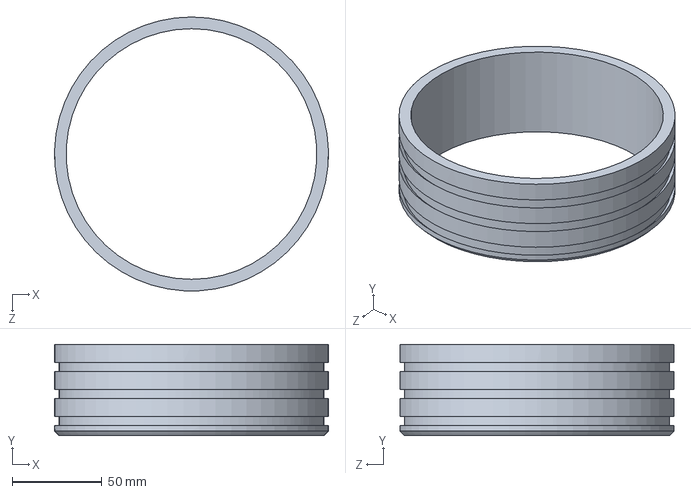
[picture p86: CAD file, 2025-01-29]
3D files/Structure/Rear Endcap Inner-JamesSanPC.SLDPRT
152.5 x 50.8 x 152.5 mm
