Robot-printer/ROV-project/3D files/Structure/Tray Railing.STL

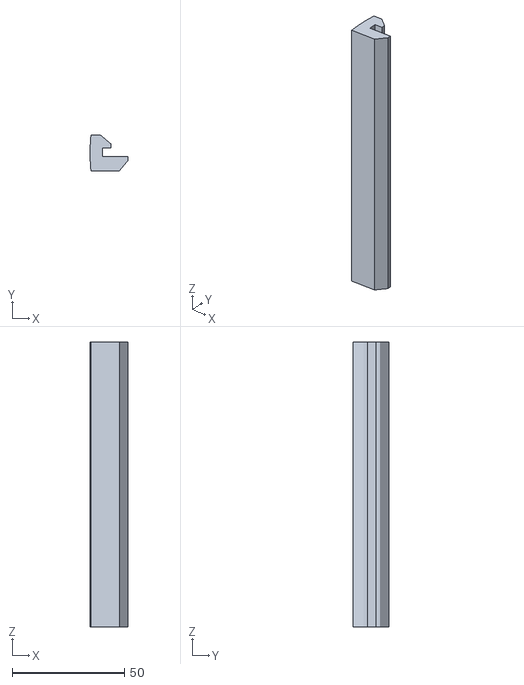
[picture p88: CAD file, 2025-01-29]
3D files/Structure/Tray Railing.STL
16.9 x 15.9 x 127.0
