Robot-printer/ROV-project/3D files/Structure/ShortRibs-Francis-2.SLDPRT

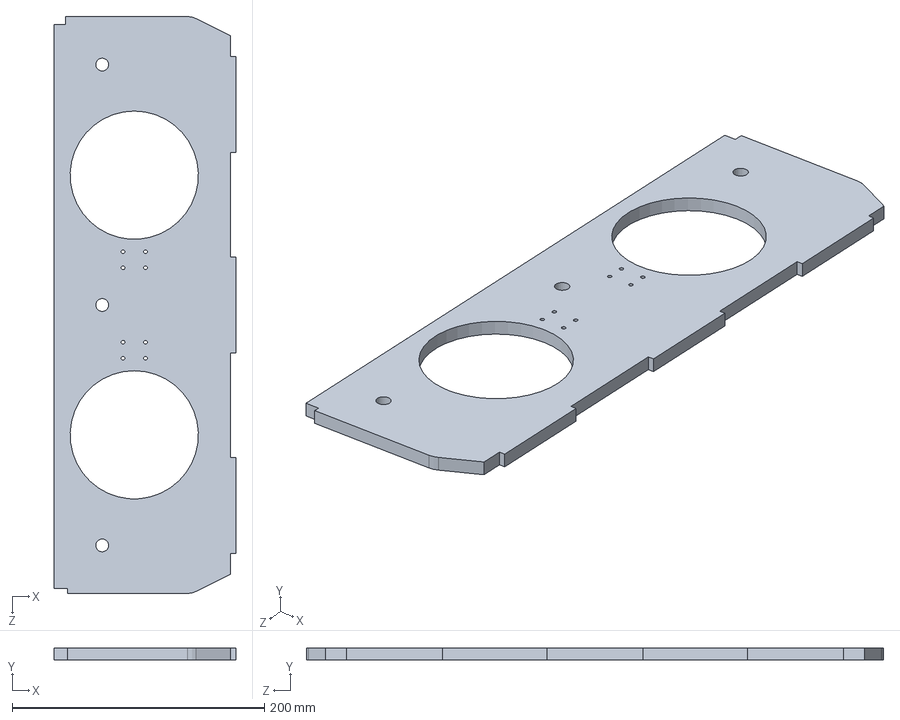
[picture p89: CAD file, 2025-01-29]
3D files/Structure/ShortRibs-Francis-2.SLDPRT
144.0 x 9.65 x 457.2 mm
