Robot-printer/ROV-project/3D files/Structure/Ribs.SLDPRT

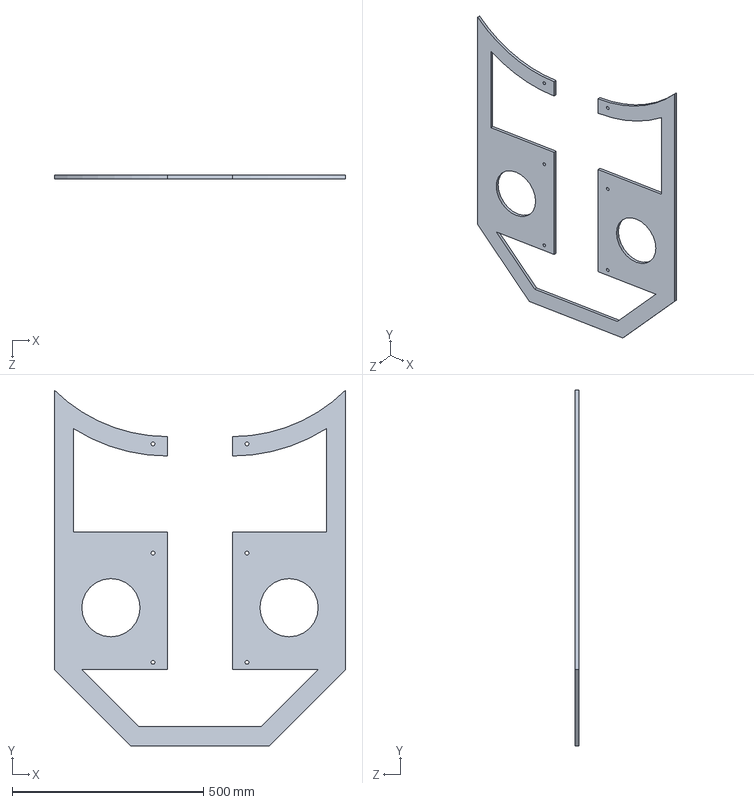
[picture p90: CAD file, 2025-01-29]
3D files/Structure/Ribs.SLDPRT
762.4 x 931.4 x 9.53 mm
