Robot-printer/ROV-project/3D files/Structure/Endcap_outer_cap (1).SLDPRT

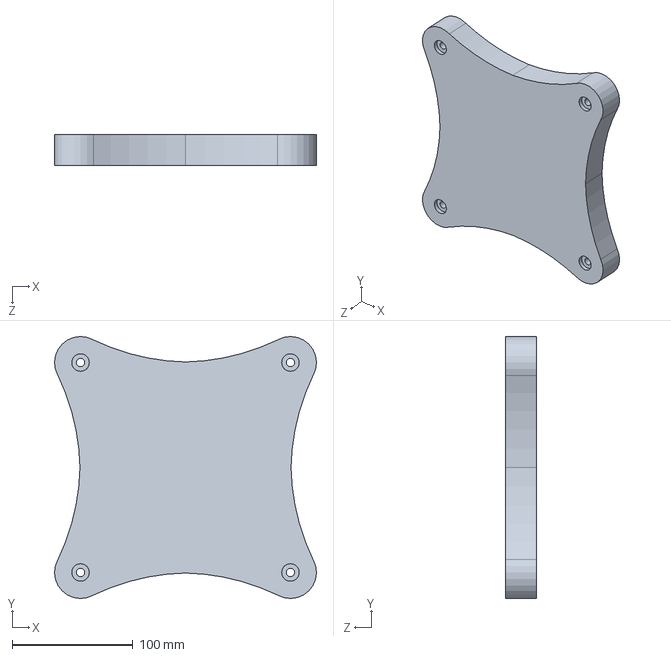
[picture p91: CAD file, 2025-01-29]
3D files/Structure/Endcap_outer_cap (1).SLDPRT
217.2 x 217.2 x 25.4 mm
