Robot-printer/ROV-project/3D files/Structure/T200-THRUSTER-R1.SLDPRT

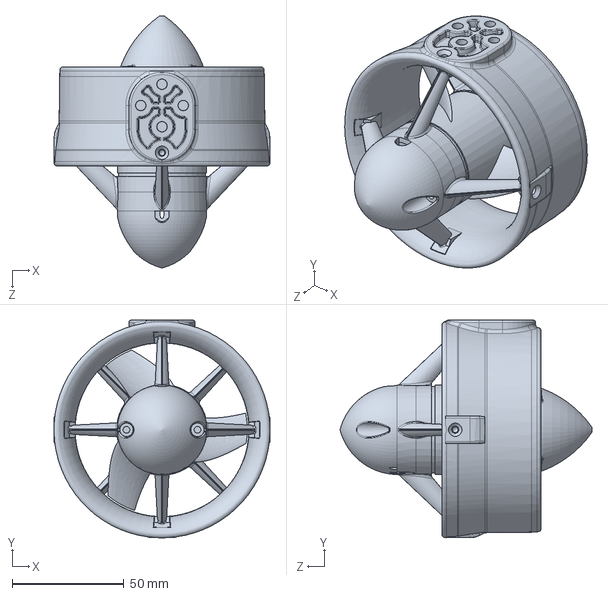
[picture p92: CAD file, 2025-01-29]
3D files/Structure/T200-THRUSTER-R1.SLDPRT
96.6 x 97.3 x 112.7 mm
