Robot-printer/ROV-project/3D files/Structure/Mid_Bracket.SLDPRT

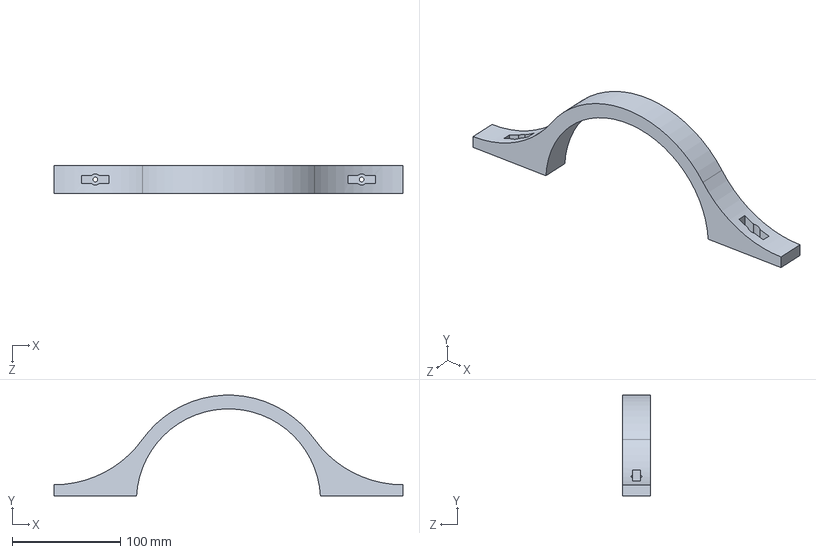
[picture p94: CAD file, 2025-01-29]
3D files/Structure/Mid_Bracket.SLDPRT
322.0 x 92.7 x 25.4 mm
