Robot-printer/ROV-project/3D files/Structure/ShortRibs-Francis.SLDPRT

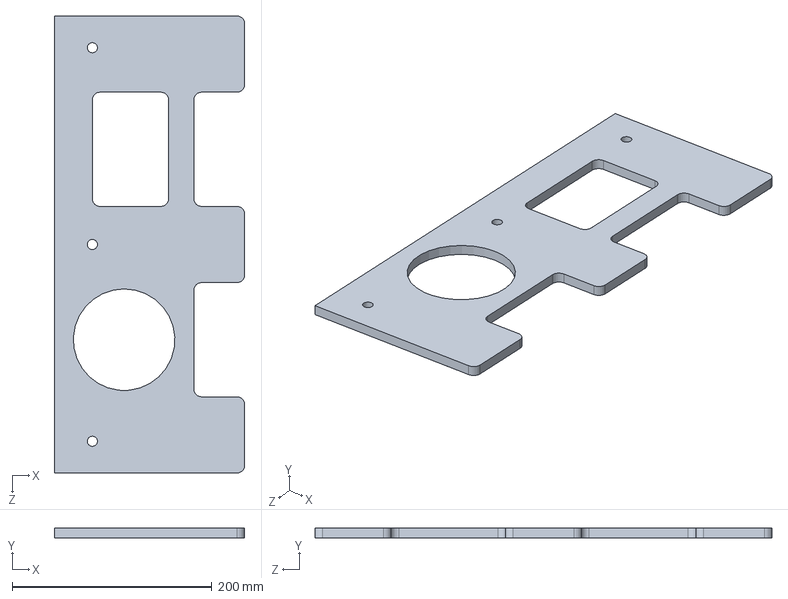
[picture p95: CAD file, 2025-01-29]
3D files/Structure/ShortRibs-Francis.SLDPRT
190.5 x 9.65 x 457.2 mm
