Robot-printer/ROV-project/3D files/Structure/Baseplate SHORT.SLDPRT

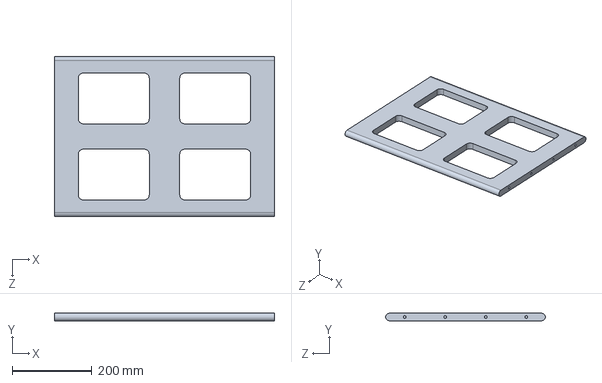
[picture p97: CAD file, 2025-01-29]
3D files/Structure/Baseplate SHORT.SLDPRT
550.9 x 19.1 x 400.1 mm
