Robot-printer/ROV-project/3D files/Structure/Gopro Plate for new PVC pipe.SLDPRT

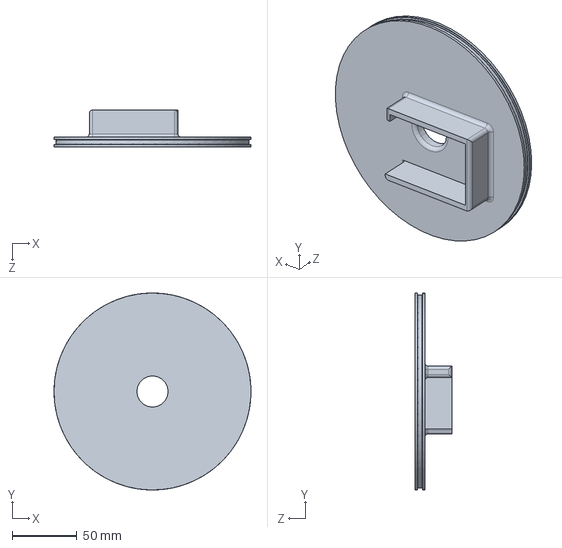
[picture p98: CAD file, 2025-01-29]
3D files/Structure/Gopro Plate for new PVC pipe.SLDPRT
152.4 x 152.3 x 28.4 mm
