Robot-printer/ROV-project/3D files/Structure/ShortRibs v2.SLDPRT

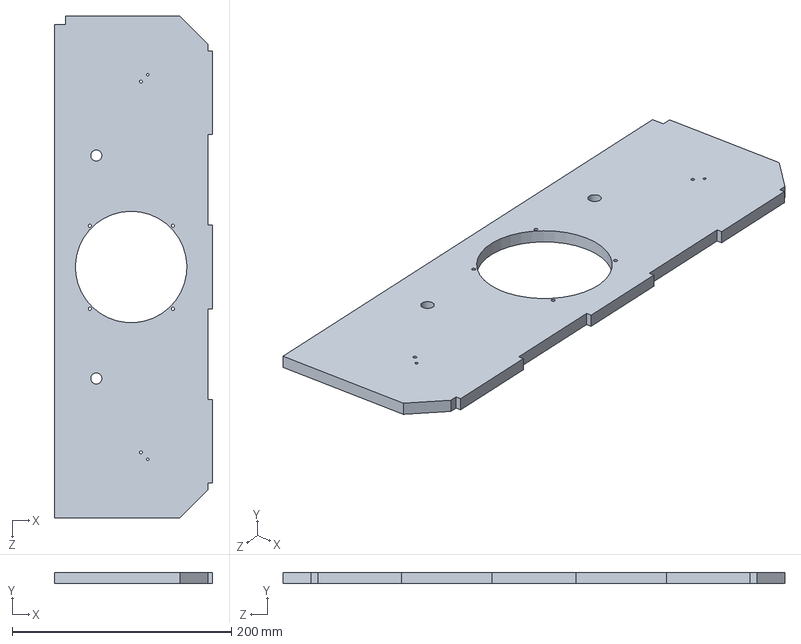
[picture p99: CAD file, 2025-01-29]
3D files/Structure/ShortRibs v2.SLDPRT
144.0 x 9.65 x 457.2 mm
