Robot-printer/ROV-project/3D files/Structure/Inner Front Cap.SLDASM

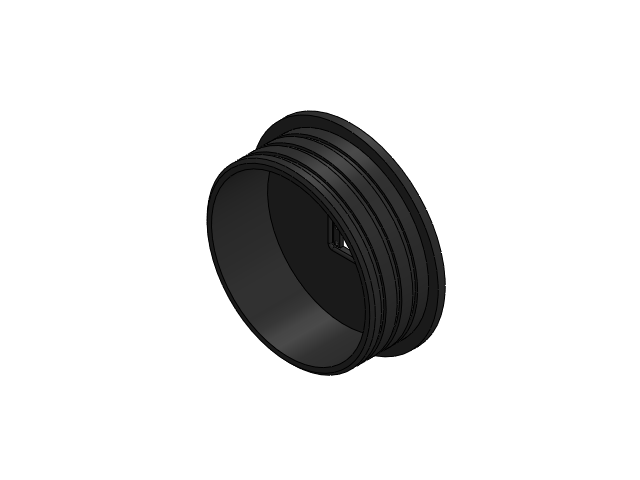
[picture p100: CAD file, 2025-01-29]
3D files/Structure/Inner Front Cap.SLDASM
Pi_Cam_Plate
Rear Endcap Inner
