Robot-printer/ROV-project/3D files/Structure/OCEC ROV MAIN ASM v.4.SLDASM

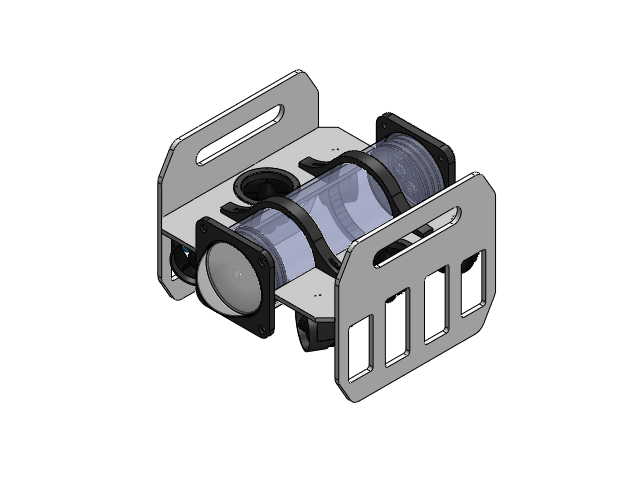
[picture p101: CAD file, 2025-01-29]
3D files/Structure/OCEC ROV MAIN ASM v.4.SLDASM
Clear_PVC_Pipe 18in
Mid_Bracket x 4
ShortRibs v2 x 2
Side Frame Panel [PORT]v2
Side Frame Panel [STBD]v2
Rear Endcap Outer
Rear Endcap Inner x 2
Front_cap (1)
T200 mounting bracket round V2 x 2
Pi_Cam_Plate
T200-THRUSTER-R1 x 6
Clear_Acrylic_Dome
7310K23_Plastic Submersible Cord Grip x 9
T200 mounting bracket horizontal x 4
91290A113_Alloy Steel Socket Head Screw x 2
91290A119_Alloy Steel Socket Head Screw x 4
