Robot-printer/ROV-project/3D files/Structure/Rear Endcap.SLDASM

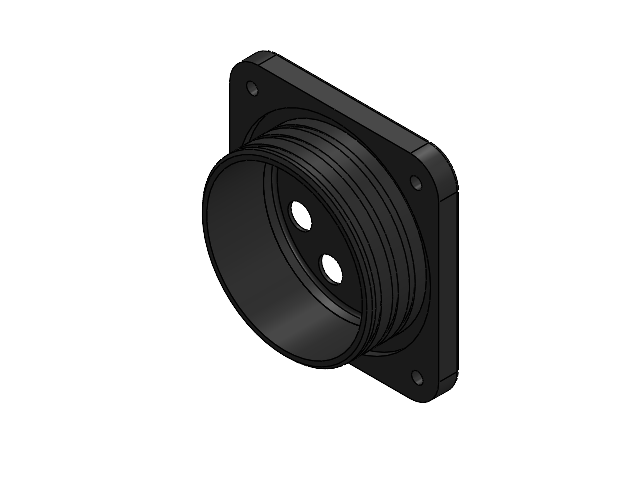
[picture p102: CAD file, 2025-01-29]
3D files/Structure/Rear Endcap.SLDASM
Rear Endcap Outer
Rear Endcap Inner
Front_cap (1)
