Robot-printer/ROV-project/(list of files, cad)

Other CAD files:
3D files/CAD parts/Active parts/Ranger-01/PVC Bracket.SLDPRT
3D files/CAD parts/Spring 2025/AUV Assembly/PVC Bracket.SLDPRT
3D files/CAD parts/Spring 2025/WIP/S01_1.3.SLDPRT
3D files/CAD parts/Spring 2025/AUV Assembly/Horizontal Nacelle.SLDPRT
3D files/CAD parts/Active parts/Ranger-01/Horizontal Nacelle.SLDPRT
3D files/Structure/Clear_Acrylic_Dome-JamesSanPC.SLDPRT
3D files/CAD parts/Spring 2025/AUV Assembly/Steel Rod.SLDPRT
3D files/CAD parts/Spring 2025/AUV Assembly/Horizontal Steel Rod.SLDPRT
3D files/CAD parts/Spring 2025/AUV Assembly/Vertical Nacelle.SLDPRT
3D files/CAD parts/Active parts/Ranger-01/Steel Rod.SLDPRT
3D files/Structure/Clear_PVC_Pipe 18in.SLDPRT
3D files/CAD parts/Active parts/Ranger-01/Hull Collar 003.SLDPRT
3D files/CAD parts/Active parts/Ranger-01/End Cap 012.SLDPRT
3D files/Structure/Bottom_Cage.SLDPRT
3D files/Structure/Rear Endcap - Rear Endcap Outer-1.STL
3D files/Structure/Endcap_inner_cap-08136-10-15321.SLDPRT
3D files/Structure/Threaded_Rod.SLDPRT
3D files/Structure/Rubber_Gasket_Plate.SLDPRT
3D files/Structure/Cage_Side left.SLDPRT
3D files/Structure/Front_cap (1)-08136-10-15321.SLDPRT
3D files/Structure/Rear Endcap - Rear Endcap Inner-1.3mf
3D files/Structure/Side Frame Panel [STBD]v2.SLDPRT
3D files/Structure/ShortRibs-08136-10-15321.SLDPRT
3D files/Structure/Front_cap (1).SLDPRT
3D files/CAD parts/Active parts/Printables/PVC Bracket.3mf
3D files/CAD parts/Spring 2025/Electronics tray/E04_1.0.SLDPRT
3D files/OLD - TIE FIGHTER/17715A11_Galvanized Steel Corner Bracket.SLDPRT
3D files/OLD - TIE FIGHTER/7310K12_Plastic Submersible Cord Grip.SLDPRT
3D files/OLD - TIE FIGHTER/7310K23_Plastic Submersible Cord Grip.SLDPRT
3D files/OLD - TIE FIGHTER/90242A160_Super-Corrosion-Resistant 316 Stainless Steel Hex Nut.SLDPRT
3D files/OLD - TIE FIGHTER/90257A007_Super-Corrosion-Resistant 316 Stainless Steel Hex Nut.SLDPRT
3D files/OLD - TIE FIGHTER/90585A116_316 Stainless Steel Hex Drive Flat Head Screw.SLDPRT
3D files/OLD - TIE FIGHTER/91290A113_Alloy Steel Socket Head Screw.SLDPRT
3D files/OLD - TIE FIGHTER/91290A119_Alloy Steel Socket Head Screw.SLDPRT
3D files/OLD - TIE FIGHTER/92185A155_Super-Corrosion-Resistant 316 Stainless Steel Socket Head Screw.SLDPRT
3D files/OLD - TIE FIGHTER/92185A178_Super-Corrosion-Resistant 316 Stainless Steel Socket Head Screw.SLDPRT
3D files/OLD - TIE FIGHTER/99149A112_Black Coated 6061 Aluminum Hex Nut.SLDPRT
3D files/OLD - TIE FIGHTER/Bottom_Cage.SLDPRT
3D files/OLD - TIE FIGHTER/Cage_Side left.SLDPRT
3D files/OLD - TIE FIGHTER/Clear_Acrylic_Dome-JamesSanPC.SLDPRT
3D files/OLD - TIE FIGHTER/Clear_PVC_Pipe 18in.SLDPRT
3D files/OLD - TIE FIGHTER/Endcap thin.3MF
3D files/OLD - TIE FIGHTER/Endcap thin.STL
3D files/OLD - TIE FIGHTER/Endcap_inner_cap-08136-10-15321.SLDPRT
3D files/OLD - TIE FIGHTER/Endcap_inner_cap.3MF
3D files/OLD - TIE FIGHTER/Front_cap (1)-08136-10-15321.SLDPRT
3D files/OLD - TIE FIGHTER/Front_cap (1).3MF
3D files/OLD - TIE FIGHTER/Front_cap (1).SLDPRT
3D files/OLD - TIE FIGHTER/Gopro Plate for new PVC pipe.STL
3D files/OLD - TIE FIGHTER/Inner Front Cap.3mf
3D files/OLD - TIE FIGHTER/Inner Front Cap.STL
3D files/OLD - TIE FIGHTER/Mid_Bracket.STL
3D files/OLD - TIE FIGHTER/Pi_Cam_Plate.STL
3D files/OLD - TIE FIGHTER/Rear Endcap - Rear Endcap Inner-1.3mf
3D files/OLD - TIE FIGHTER/Rear Endcap - Rear Endcap Inner-1.STL
3D files/OLD - TIE FIGHTER/Rear Endcap - Rear Endcap Outer-1.STL
3D files/OLD - TIE FIGHTER/Rear Endcap Inner TEST.STL
3D files/OLD - TIE FIGHTER/Rear Endcap Inner.STL
3D files/OLD - TIE FIGHTER/Rear Endcap Outer.STL
3D files/OLD - TIE FIGHTER/Rear Endcap v2.STL
3D files/OLD - TIE FIGHTER/Rear Endcap.STL
3D files/OLD - TIE FIGHTER/Rubber_Gasket_Plate.SLDPRT
3D files/OLD - TIE FIGHTER/ShortRibs v1.SLDPRT
3D files/OLD - TIE FIGHTER/ShortRibs-08136-10-15321.SLDPRT
3D files/OLD - TIE FIGHTER/ShortRibs.SLDDRW
3D files/OLD - TIE FIGHTER/Side Frame Panel [PORT].SLDDRW
3D files/OLD - TIE FIGHTER/Side Frame Panel [STBD]v2.SLDPRT
3D files/OLD - TIE FIGHTER/T200 mounting bracket horizontal.STL
3D files/OLD - TIE FIGHTER/T200 mounting bracket round V2.STL
3D files/OLD - TIE FIGHTER/T200 mounting bracket.STL
3D files/OLD - TIE FIGHTER/Threaded_Rod.SLDPRT
3D files/Structure/17715A11_Galvanized Steel Corner Bracket.SLDPRT
3D files/Structure/7310K12_Plastic Submersible Cord Grip.SLDPRT
3D files/Structure/7310K23_Plastic Submersible Cord Grip.SLDPRT
3D files/Structure/90242A160_Super-Corrosion-Resistant 316 Stainless Steel Hex Nut.SLDPRT
3D files/Structure/90257A007_Super-Corrosion-Resistant 316 Stainless Steel Hex Nut.SLDPRT
3D files/Structure/90585A116_316 Stainless Steel Hex Drive Flat Head Screw.SLDPRT
3D files/Structure/91290A113_Alloy Steel Socket Head Screw.SLDPRT
3D files/Structure/91290A119_Alloy Steel Socket Head Screw.SLDPRT
3D files/Structure/92185A155_Super-Corrosion-Resistant 316 Stainless Steel Socket Head Screw.SLDPRT
3D files/Structure/92185A178_Super-Corrosion-Resistant 316 Stainless Steel Socket Head Screw.SLDPRT
3D files/Structure/99149A112_Black Coated 6061 Aluminum Hex Nut.SLDPRT
3D files/Structure/Endcap thin.3MF
3D files/Structure/Endcap thin.STL
3D files/Structure/Endcap_inner_cap.3MF
3D files/Structure/Front_cap (1).3MF
3D files/Structure/Gopro Plate for new PVC pipe.STL
3D files/Structure/Inner Front Cap.3mf
3D files/Structure/Inner Front Cap.STL
3D files/Structure/Mid_Bracket.STL
3D files/Structure/Pi_Cam_Plate.STL
3D files/Structure/Rear Endcap - Rear Endcap Inner-1.STL
3D files/Structure/Rear Endcap Inner TEST.STL
3D files/Structure/Rear Endcap Inner.STL
3D files/Structure/Rear Endcap Outer.STL
3D files/Structure/Rear Endcap v2.STL
3D files/Structure/Rear Endcap.STL
3D files/Structure/ShortRibs v1.SLDPRT
3D files/Structure/ShortRibs.SLDDRW
3D files/Structure/Side Frame Panel [PORT].SLDDRW
3D files/Structure/T200 mounting bracket horizontal.STL
3D files/Structure/T200 mounting bracket round V2.STL
3D files/Structure/T200 mounting bracket.STL
Documents/Mechanical Documention/CAD Documentation/Drawings/Dome Spacer 001.SLDDRW
Documents/Mechanical Documention/CAD Documentation/Drawings/Hor Nacell FINAL DRAWING.SLDDRW
Documents/Mechanical Documention/CAD Documentation/Drawings/Horizontal Nacell Guard DRAWING.SLDDRW
Documents/Mechanical Documention/CAD Documentation/Drawings/Hull Collar 007.SLDDRW
Documents/Mechanical Documention/CAD Documentation/Drawings/Verical Motor Mount DRAWING.SLDDRW
Documents/Mechanical Documention/CAD Documentation/Drawings/Vertical Nacelle drawing.SLDDRW
