Robot-printer/ROV-project/Documents/Mechanical Documention/Templates and Guidelines/CAD Guidelines.md

* ALL CAD files should be in MMGS(millimeter, grams, seconds)
* When naming CAD files refer to the "CAD ID Format" file.
* When finalizing a CAD file cut the CAD ID into the part.
* Place CAD files into "3D files\\CAD parts" folder.
* Do this stuff
