Robot-printer/ROV-project/3D files/CAD parts/Spring 2025/AUV Assembly/AUV Assembly.PNG

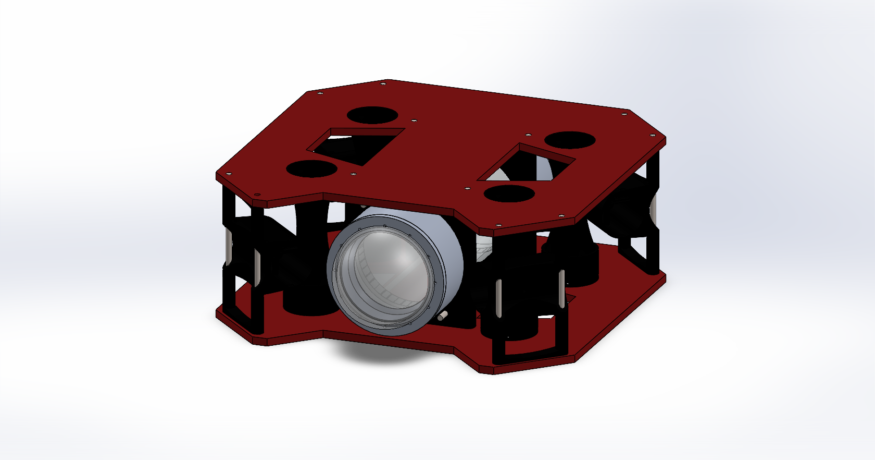
3D files/CAD parts/Spring 2025/AUV Assembly/AUV Assembly.PNG
