Robot-printer/ROV-project/Documents/Project Log/2025 ROV Project Log.docx

2025 project log: Olympic Engineering Club ROV

DATE | Mechanical Notes | Electrical Notes | Software Notes
1/28 | Start work on model for internal skeleton. Start electronics tray. Start endcaps. | Ethernet port adapter. Discuss PCB work | Planning. Next step, attempt new programs. Deliberate tasks.
