Robot-printer/ROV-project/3D files/CAD parts/Active parts/TODO.txt

Rename all parts to have the correct part ID
