Robot-printer/ROV-project/3D files/CAD parts/Spring 2025/todo.txt

rename all final parts to have the correct part id
