Robot-printer/ROV-project/Documents/Project Log/ROV Circuit diagram - Page 1.png

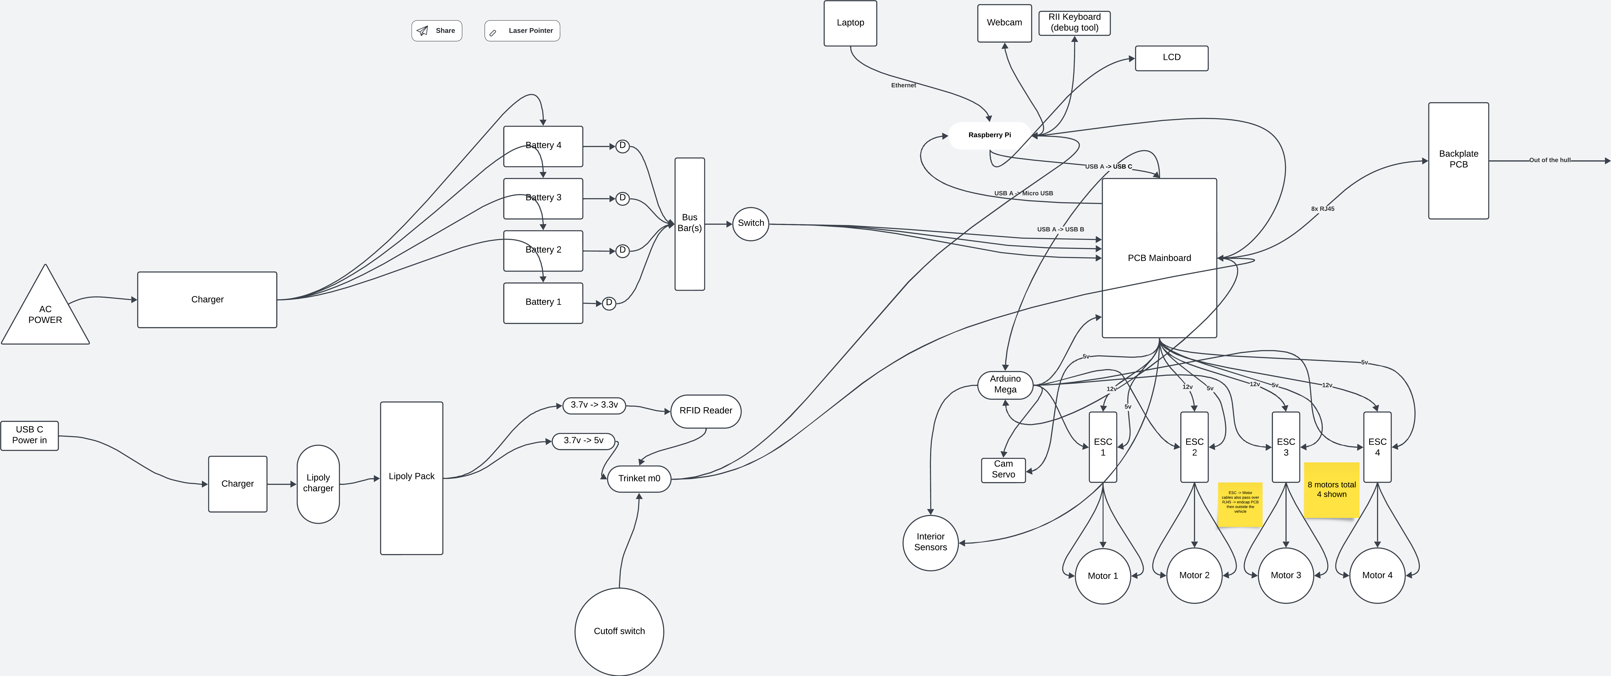
Documents/Project Log/ROV Circuit diagram - Page 1.png
