Robot-printer/ROV-project/Documents/Mechanical Documention/CAD Documentation/Drawings/Dome Spacer 001.pdf

B B

2

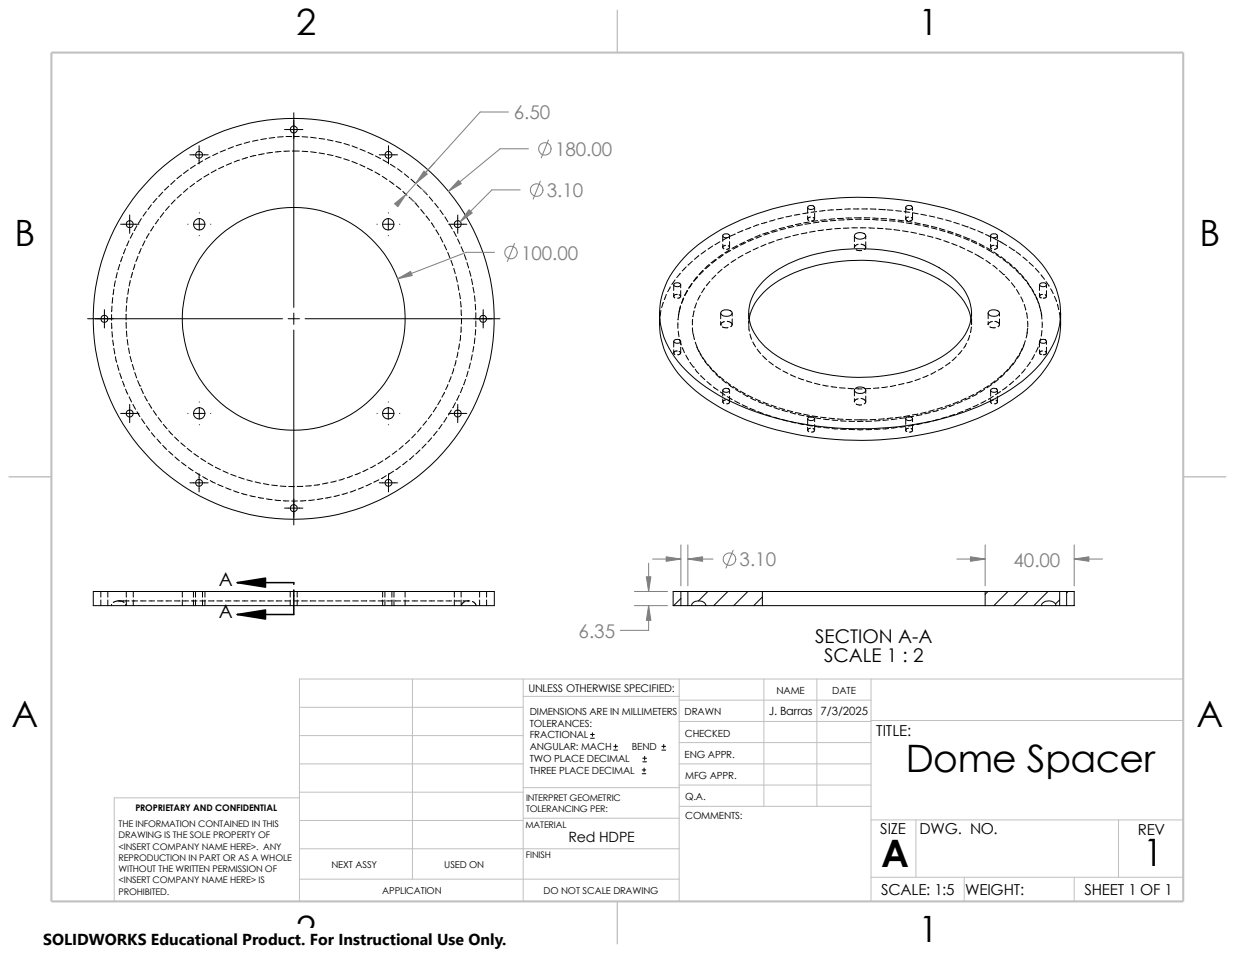
[picture p105: page 1]
COMMENTS:; SECTION A-A SCALE 1 : 2

UNLESS OTHERWISE SPECIFIED: | | NAME | DATE
DIMENSIONS ARE IN MILLIMETERS TOLERANCES: FRACTIONAL ANGULAR: MACH BEND TWO PLACE DECIMAL THREE PLACE DECIMAL | DRAWN | J. Barras | 7/3/2025

CHECKED | | | TITLE: Dome Spacer

ENG APPR.
MFG APPR.

INTERPRET GEOMETRIC TOLERANCING PER: | Q.A.
MATERIAL Red HDPE | | SIZE A | DWG. NO. | REV 1

PROPRIETARY AND CONFIDENTIAL
THE INFORMATION CONTAINED IN THIS
DRAWING IS THE SOLE PROPERTY OF
<INSERT COMPANY NAME HERE>. ANY
REPRODUCTION IN PART OR AS A WHOLE
WITHOUT THE WRITTEN PERMISSION OF
<INSERT COMPANY NAME HERE> IS
PROHIBITED.

NEXT ASSY | USED ON | FINISH

APPLICATION | DO NOT SCALE DRAWING | | SCALE: 1:5 | WEIGHT: | SHEET 1 OF 1

SOLIDWORKS Educational Product. For Instructional Use Only.
