Robot-printer/ROV-project/Documents/Mechanical Documention/CAD Documentation/Drawings/Hull Collar 007 drawing.pdf

B B

2

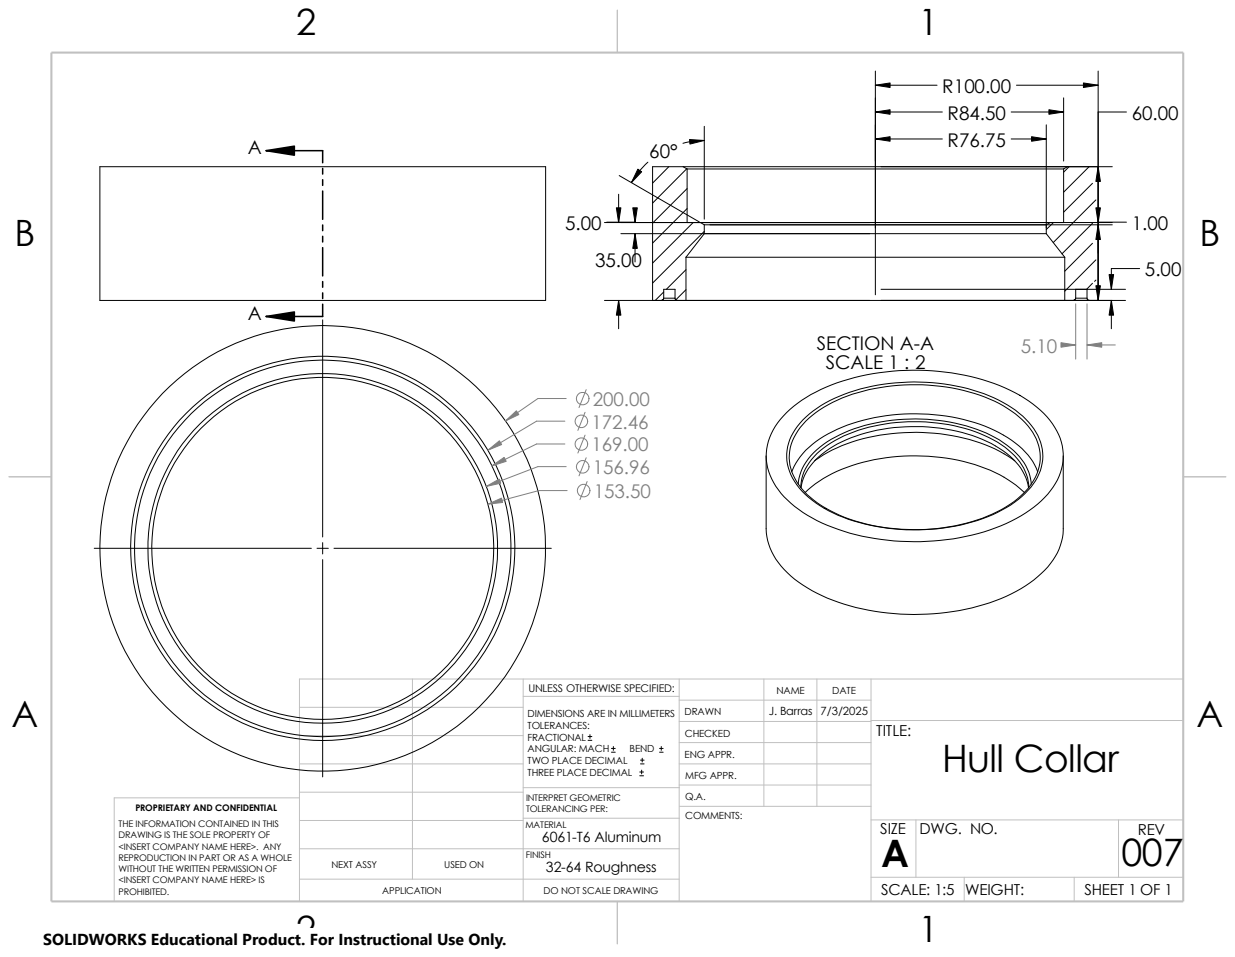
[picture p106: page 1]
COMMENTS:; SECTION A-A SCALE 1 : 2

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

CHECKED | | | TITLE: Hull Collar

ENG APPR.
MFG APPR.

INTERPRET GEOMETRIC TOLERANCING PER: | Q.A.
MATERIAL 6061-T6 Aluminum | | SIZE A | DWG. NO. | REV 007

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

NEXT ASSY | USED ON | FINISH 32-64 Roughness

APPLICATION | DO NOT SCALE DRAWING | | SCALE: 1:5 | WEIGHT: | SHEET 1 OF 1

SOLIDWORKS Educational Product. For Instructional Use Only.
