Robot-printer/ROV-project/Documents/Electronics Documentation/UUV Electronics major design descions.pdf

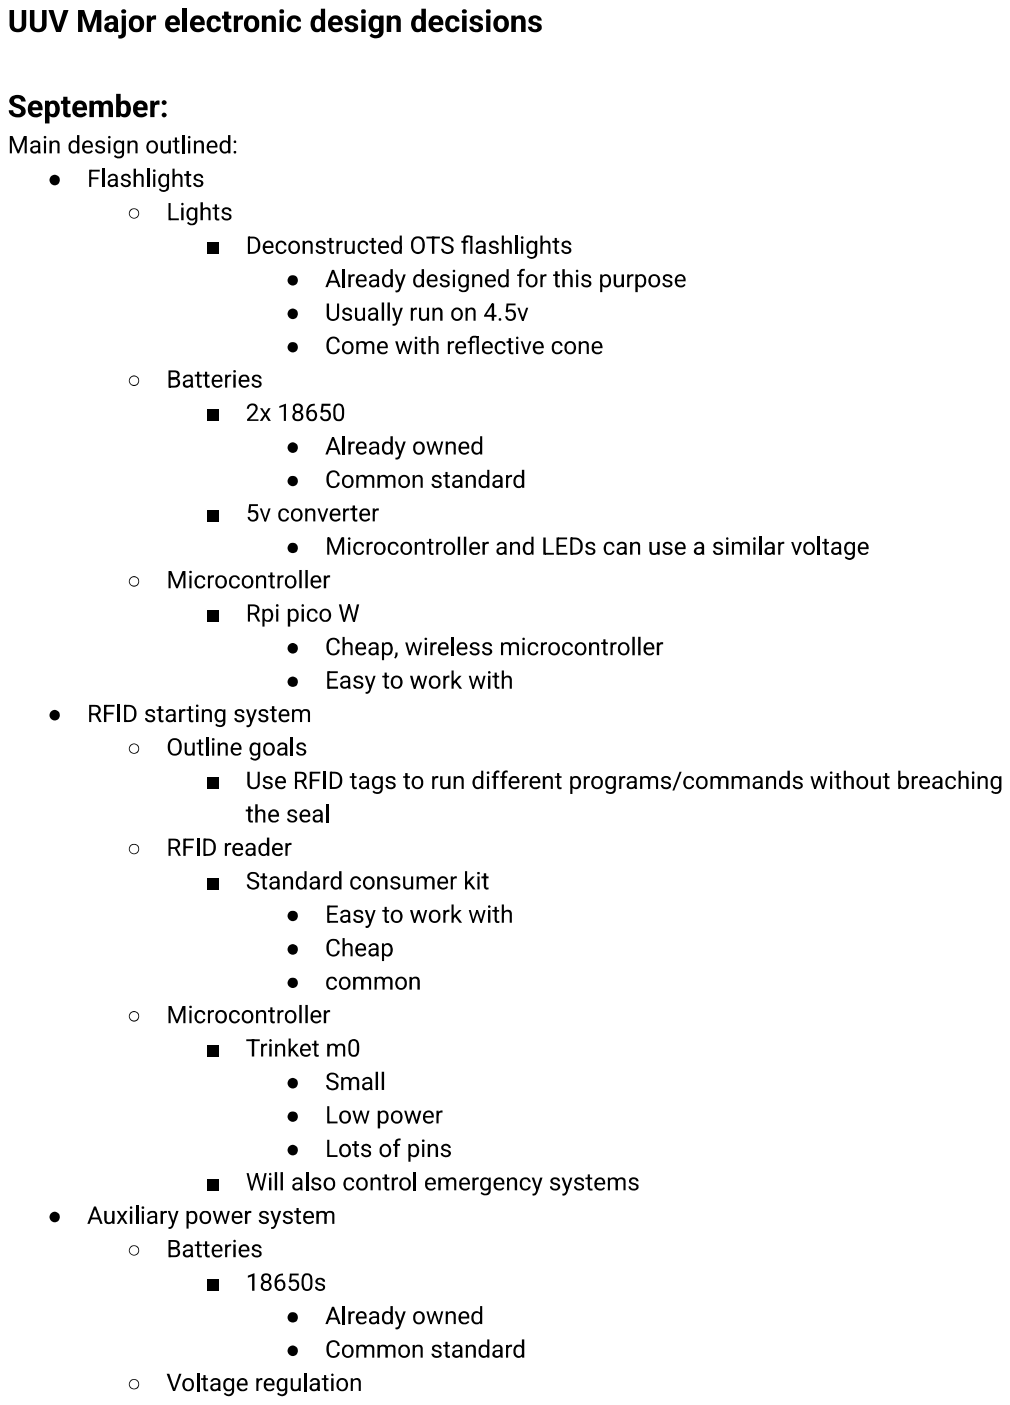
[picture p107: page 1]

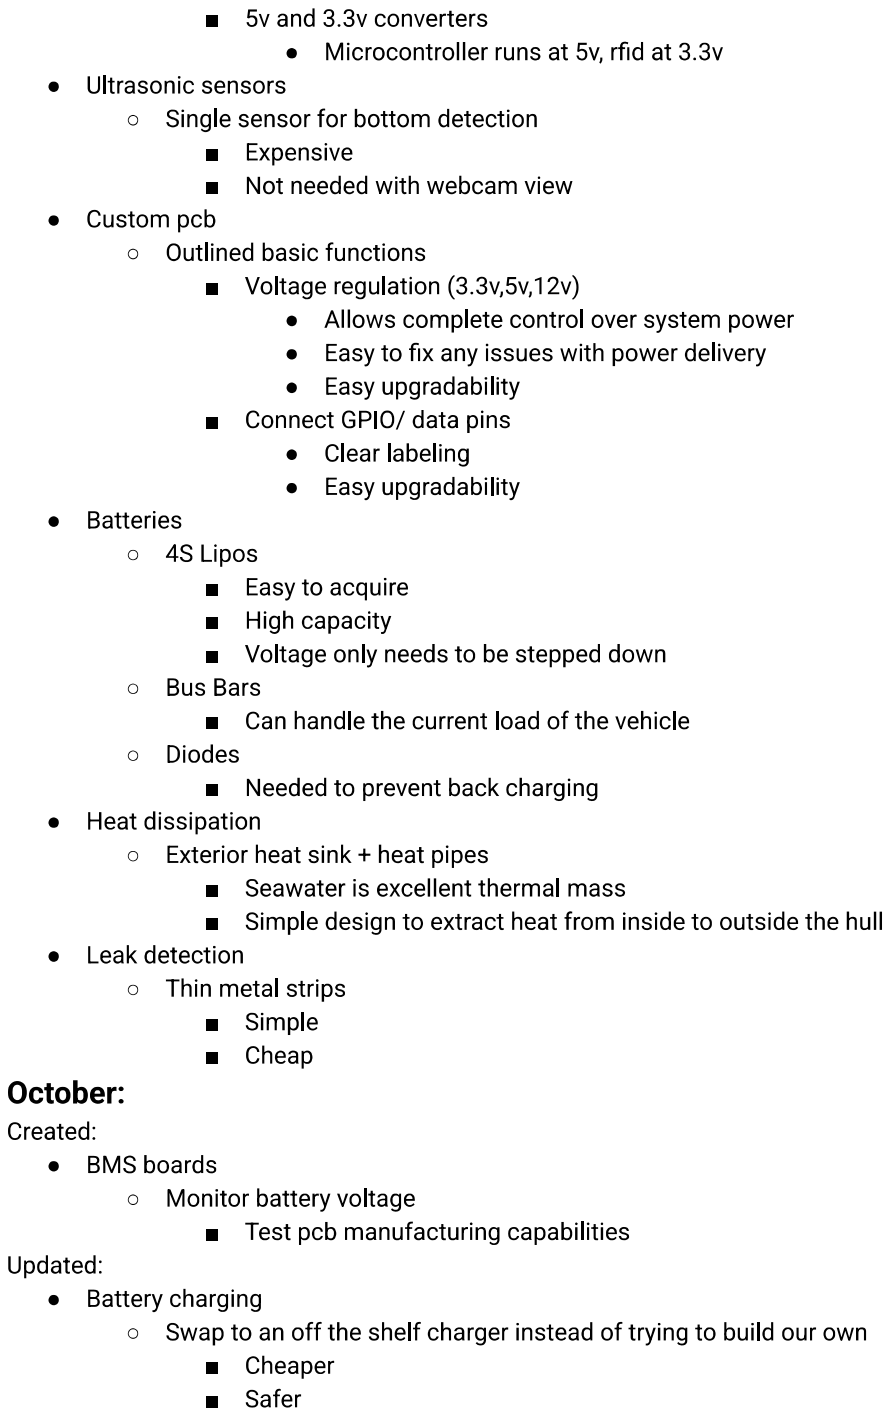
[picture p108: page 2]

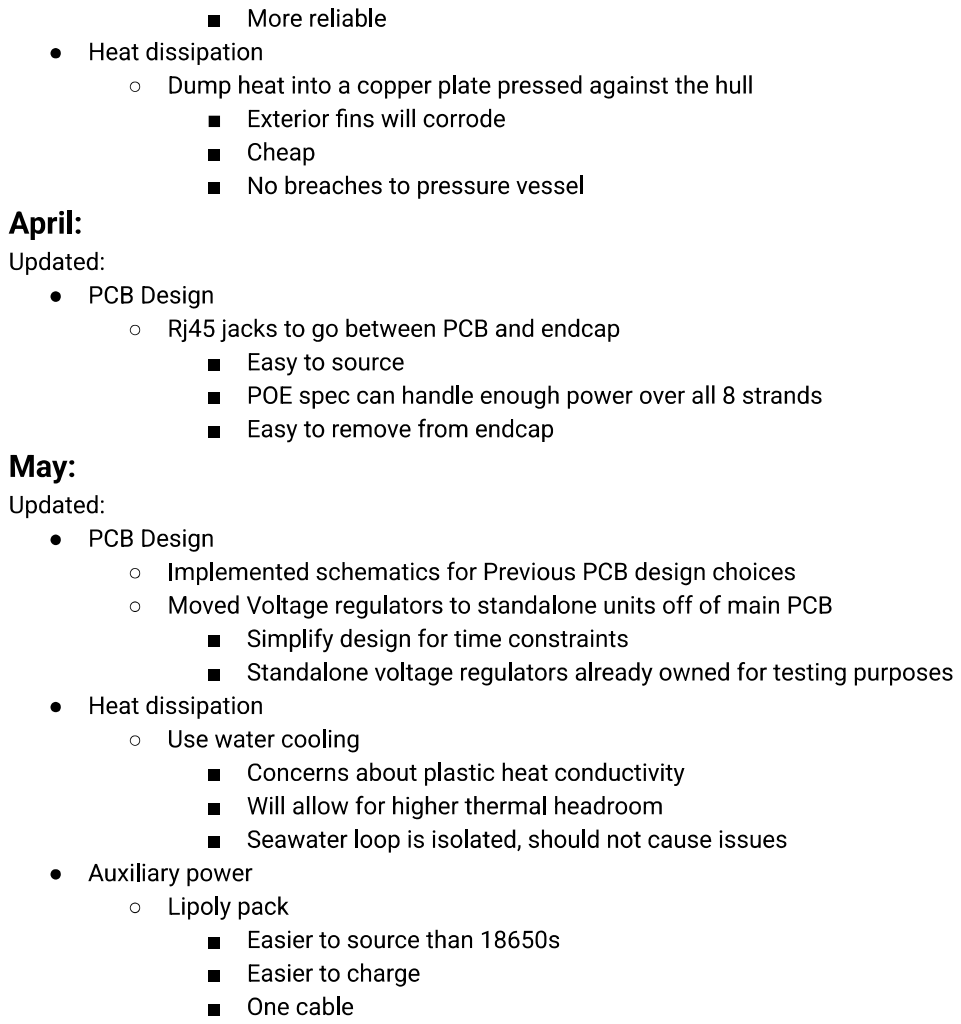
[picture p109: page 3]
