Robot-printer/ROV-project/Documents/Project Log/ROV W24 Sub-team summary (outdated).pdf

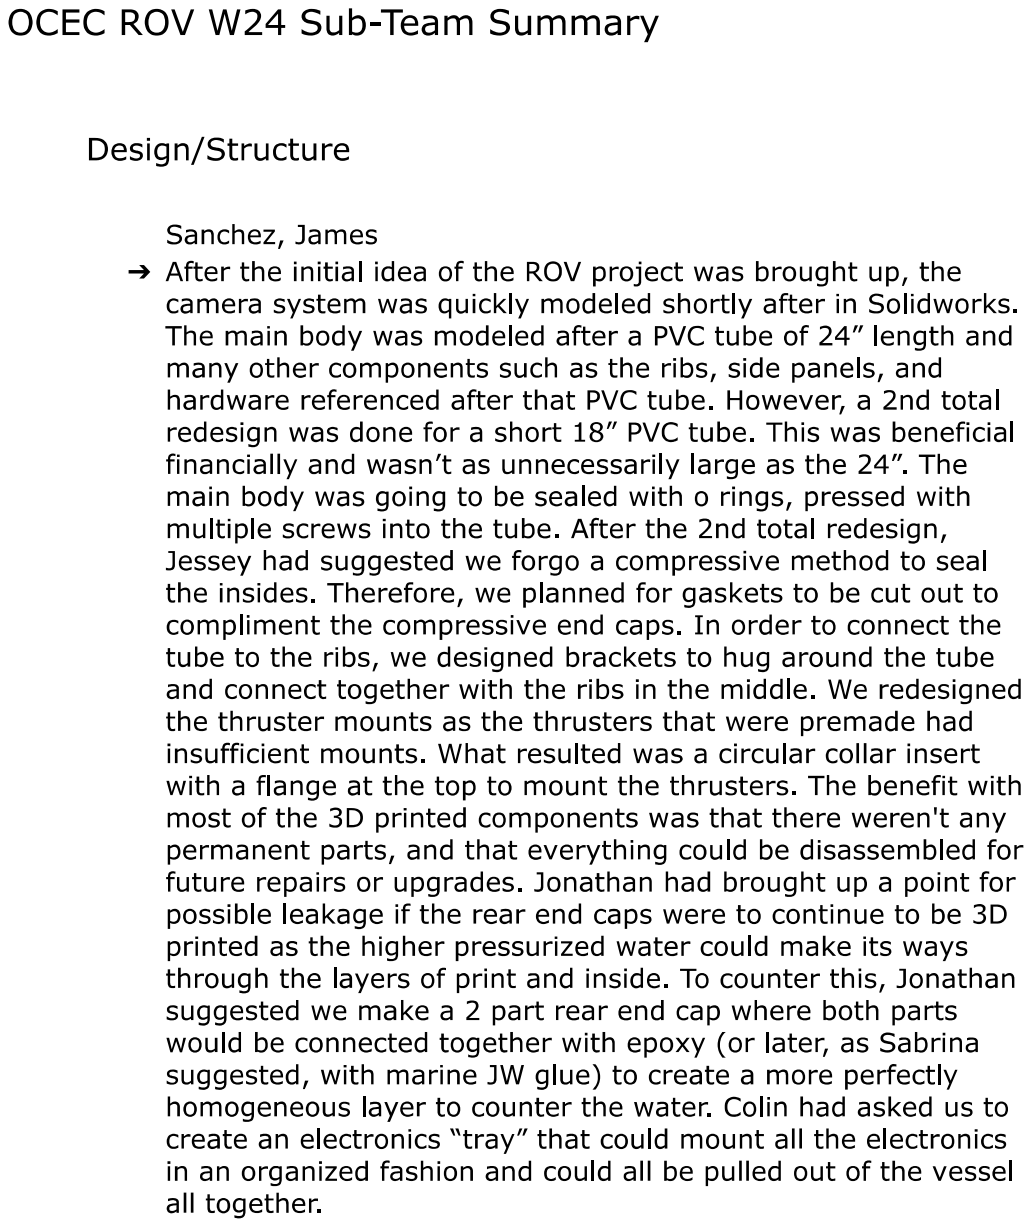
[picture p110: page 1]

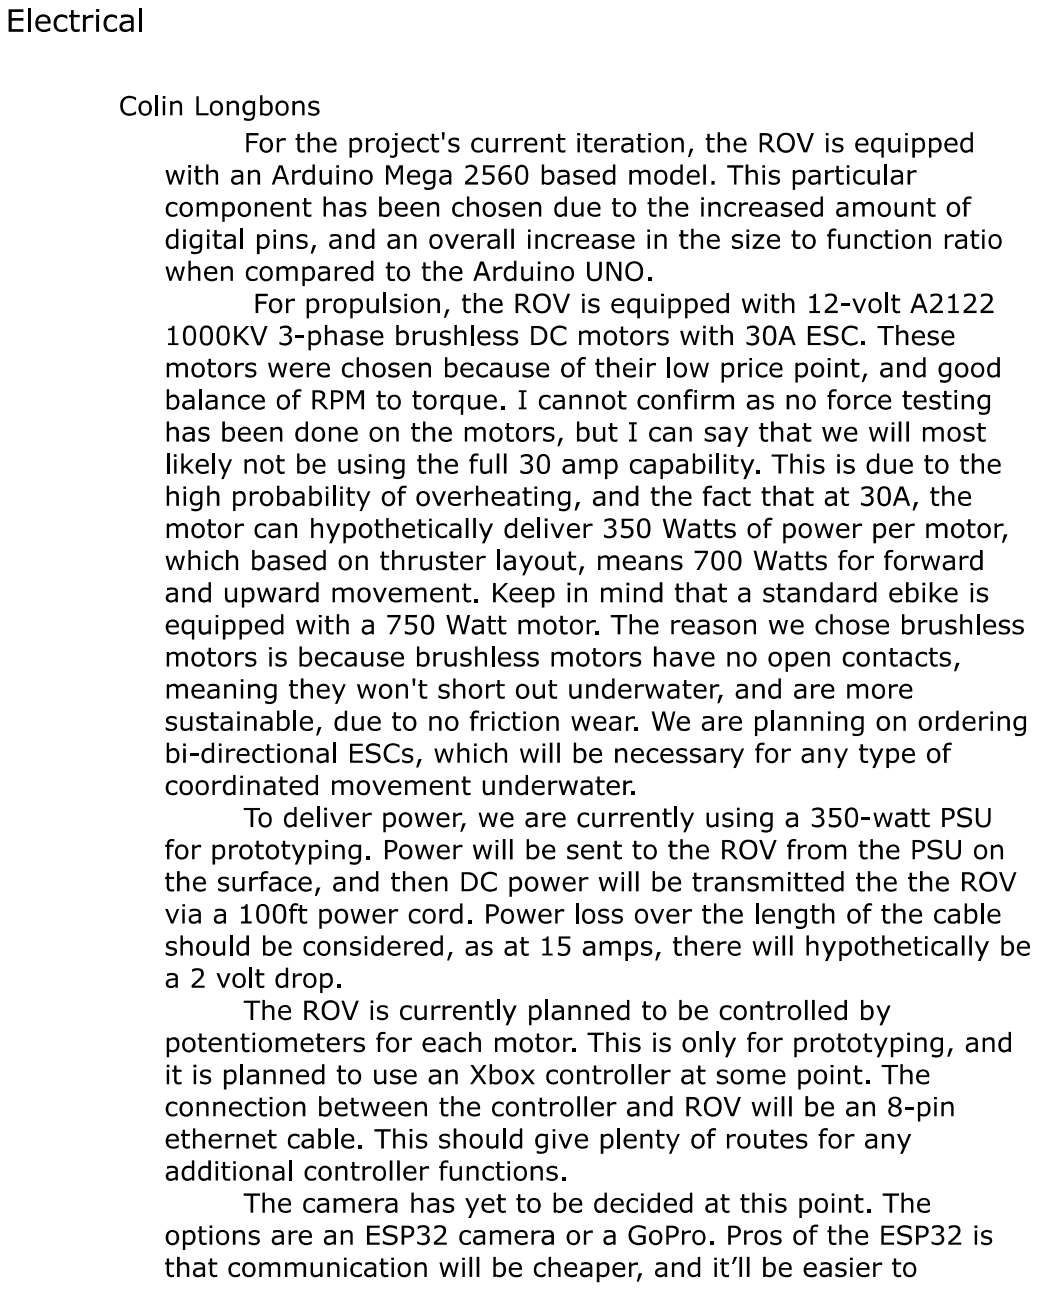
[picture p111: page 2]

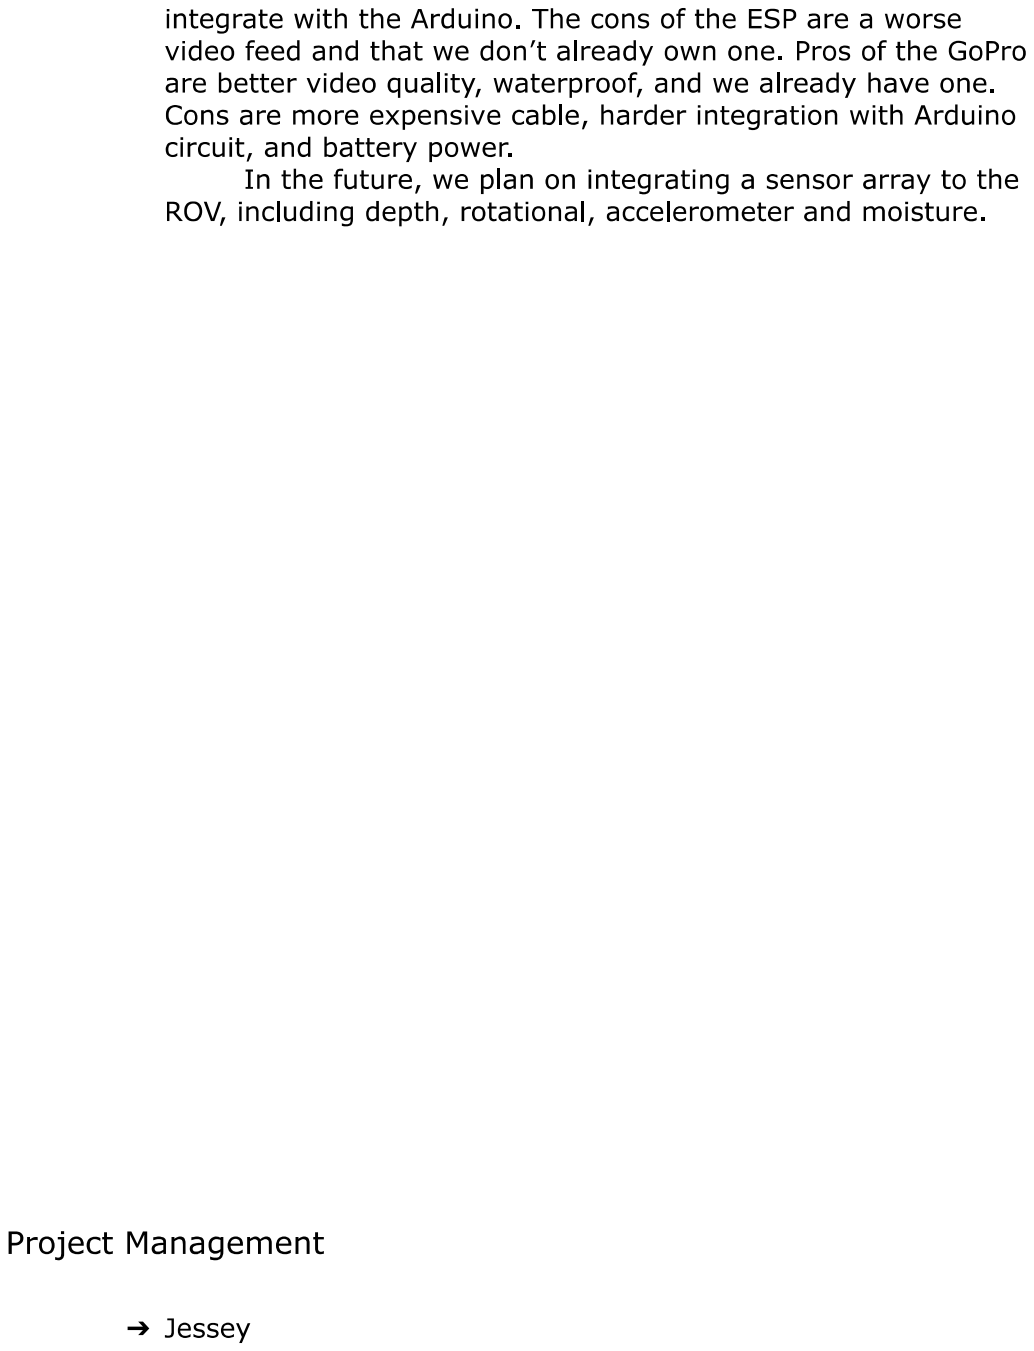
[picture p112: page 3]
