Robot-printer/ROV-project/(list of files, drawings)

Other design files:
PCB/Altium files/MainboardPCB.PcbDoc
PCB/Altium files/MainboardPCB.SchDoc
PCB/Altium files/Motor endcap.PcbDoc
PCB/Altium files/motor endcap.SchDoc
