Robot-printer/ROV-project/Laptop/To Pi/Controller input.py

from inputs import get_gamepad
import math
import threading
import tkinter
import turtle




class XboxController(object):
    MAX_TRIG_VAL = math.pow(2, 8)
    MAX_JOY_VAL = math.pow(2, 15)

    def __init__(self):

        self.LeftJoystickY = 0
        self.LeftJoystickX = 0
        self.RightJoystickY = 0
        self.RightJoystickX = 0
        self.LeftTrigger = 0
        self.RightTrigger = 0
        self.LeftBumper = 0
        self.RightBumper = 0
        self.A = 0
        self.X = 0
        self.Y = 0
        self.B = 0
        self.LeftThumb = 0
        self.RightThumb = 0
        self.Back = 0
        self.Start = 0
        self.LeftDPad = 0
        self.RightDPad = 0
        self.UpDPad = 0
        self.DownDPad = 0

        self._monitor_thread = threading.Thread(target=self._monitor_controller, args=())
        self._monitor_thread.daemon = True
        self._monitor_thread.start()


    def read(self): # return the buttons/triggers that you care about in this methode
        x1 = self.LeftJoystickX
        y1 = self.LeftJoystickY
        x2 = self.RightJoystickX
        y2 = self.RightJoystickY
        a = self.A
        b = self.B
        x = self.X
        y = self.Y
        rb = self.RightBumper
        rt = self.RightTrigger
        lb = self.LeftBumper
        lt = self.LeftTrigger
        return [x1, y1, x2, y2, a, b, x, y, rb, lb, rt, lt]


    def _monitor_controller(self):
        while True:
            events = get_gamepad()
            for event in events:
                if event.code == 'ABS_Y':
                    self.LeftJoystickY = event.state / XboxController.MAX_JOY_VAL # normalize between -1 and 1
                elif event.code == 'ABS_X':
                    self.LeftJoystickX = event.state / XboxController.MAX_JOY_VAL # normalize between -1 and 1
                elif event.code == 'ABS_RY':
                    self.RightJoystickY = event.state / XboxController.MAX_JOY_VAL # normalize between -1 and 1
                elif event.code == 'ABS_RX':
                    self.RightJoystickX = event.state / XboxController.MAX_JOY_VAL # normalize between -1 and 1
                elif event.code == 'ABS_Z':
                    self.LeftTrigger = event.state / XboxController.MAX_TRIG_VAL # normalize between 0 and 1
                elif event.code == 'ABS_RZ':
                    self.RightTrigger = event.state / XboxController.MAX_TRIG_VAL # normalize between 0 and 1
                elif event.code == 'BTN_TL':
                    self.LeftBumper = event.state
                elif event.code == 'BTN_TR':
                    self.RightBumper = event.state
                elif event.code == 'BTN_SOUTH':
                    self.A = event.state
                elif event.code == 'BTN_NORTH':
                    self.Y = event.state #previously switched with X
                elif event.code == 'BTN_WEST':
                    self.X = event.state #previously switched with Y
                elif event.code == 'BTN_EAST':
                    self.B = event.state
                elif event.code == 'BTN_THUMBL':
                    self.LeftThumb = event.state
                elif event.code == 'BTN_THUMBR':
                    self.RightThumb = event.state
                elif event.code == 'BTN_SELECT':
                    self.Back = event.state
                elif event.code == 'BTN_START':
                    self.Start = event.state
                elif event.code == 'BTN_TRIGGER_HAPPY1':
                    self.LeftDPad = event.state
                elif event.code == 'BTN_TRIGGER_HAPPY2':
                    self.RightDPad = event.state
                elif event.code == 'BTN_TRIGGER_HAPPY3':
                    self.UpDPad = event.state
                elif event.code == 'BTN_TRIGGER_HAPPY4':
                    self.DownDPad = event.state




if __name__ == '__main__':
    joy = XboxController()
    colourList=['black','red','orange','yellow','green','blue','aqua','indigo','violet','purple']
    currentColour=0
    while True:
        #print(joy.read())
        turtle.color(colourList[currentColour])
        turtle.right(50*joy.read()[2])
        turtle.forward(10*joy.read()[1])
        turtle.speed(5.25+(4.75*joy.read()[10])-(4.75*joy.read()[11]))
        #print(turtle.speed())
        if joy.read()[4]==1:
            turtle.home()
        if joy.read()[6]==1:
            print(turtle.pos())
        if joy.read()[5]==1:
            turtle.clearscreen()
        if joy.read()[8]==1:
            if currentColour< len(colourList)-1:
                currentColour+=1
            else:
                currentColour =0
        if joy.read()[9]==1:
            if currentColour> 0:
                currentColour-=1
            else:
                currentColour =9
        if joy.read()[7]==1:
            turtle.pu()
        elif joy.read()[7]==0:
            turtle.pd()
        
        
        
        
        
        
