Robot-printer/ROV-project/(commit log)

2024-02-10 Update to motor controller to account for 4 motors, and 3 potentiometers
2024-10-31 Rename Arduino/Platform/redirect to Arduino/Platform/Servos/dummy file
2024-10-31 Update and rename Arduino/Platform/ardusetup.py to Arduino/Platform/TestBench/ardusetup.py
2024-11-13 Uploaded Thruster Math Report
2024-11-13 Added Thrust Mathematics report
2024-11-13 Uploaded Thruster Mathematics Report
2024-12-18 Added pinout image for the arduino mega
2025-01-16 Created Motor Control program file
2025-01-16 Created file for keeping track of what computer/microcontroller does what for the UUV
    [UUV Computer Systems Functions.xlsx]
2025-01-21 Create script for motor/ESC test bench
2025-01-22 Added first batch of cad files
    [17715A11_Galvanized Steel Corner Bracket.SLDPRT, 90257A007_Super-Corrosion-Resistant 316 Stainless Steel Hex Nut.SLDPRT, 92185A155_Super-Corrosion-Resistant 316 Stainless Steel Socket Head Screw.SLDPRT, Bottom_Cage.SLDPRT, Cage_Side left.SLDPRT, Cage_Side.SLDPRT, Clear_Acrylic_Dome-JamesSanPC.SLDPRT, Clear_PVC_Pipe.SLDPRT]
2025-01-22 added second batch of cad files
    [7310K12_Plastic Submersible Cord Grip.SLDPRT, 7310K23_Plastic Submersible Cord Grip.SLDPRT, 90242A160_Super-Corrosion-Resistant 316 Stainless Steel Hex Nut.SLDPRT, 90585A116_316 Stainless Steel Hex Drive Flat Head Screw.SLDPRT, 91290A113_Alloy Steel Socket Head Screw.SLDPRT, 91290A119_Alloy Steel Socket Head Screw.SLDPRT, 92185A178_Super-Corrosion-Resistant 316 Stainless Steel Socket Head Screw.S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]
2025-01-29 Created script for communication between Raspberry Pi and Arduino
    subject to change
2025-01-29 Minor edits to Computer Sys Functions Spreadsheet
    [UUV Computer Systems Functions.xlsx]
2025-01-29 Created CAD guidelines and documentation on how files should be named and where to reference human readable names for CAD files.
2025-01-30 Updated computer systems spreadsheet
    [UUV Computer Systems Functions.xlsx]
2025-01-30 Changes to motor test script (No longer used)
    [MotorTestScript.ino]
2025-01-31 Uploading current batch of CAD files.
    [Assembled UUV 1.0.SLDASM, B02_1.1.SLDPRT, B02_1.2.SLDPRT, Central Pipe 1.0.SLDPRT, E01_1.1.SLDPRT, Electronics Tray 1.0 (WIP; Height subject to change).SLDPRT, New Assembled UUV 1.0.SLDASM, S01_1.1.SLDPRT]
2025-01-31 Fixed name of file
    [ArdRasPiSerialComm.ino]
2025-01-31 Created python script for RasPi side of RasPi/Arduino communication
2025-02-01 Rename PCB/Component Datasheets/tps3828-q1.pdf to PCB/Component Datasheets/USB hubs/tps3828-q1.pdf
2025-02-01 Rename PCB/Component Datasheets/tusb2036.pdf to PCB/Component Datasheets/USB hubs/tusb2036.pdf
2025-02-01 Rename PCB/Component Datasheets/ABL.pdf to PCB/Component Datasheets/USB hubs/ABL.pdf
2025-02-04 Added libraries for Servo/ESC control & 6DoF sensor
2025-02-05 Added more CAD files. Note: need to add HRN to the ID key files
    [E03_2.1.SLDPRT, S01_1.3.SLDPRT, S01_1.3.STEP, W01_1.1.SLDPRT, W02_1.1.SLDPRT]
2025-02-06 Fixed CAD ID Format file and added a new CAD guideline
2025-02-13 Created file for arduino side of arduino/raspi communication
2025-02-13 Created file for controlling motors
2025-02-13 Added simple functionality for reading serial data from Arduino
2025-02-18 Moved existing software documentation to specific Software Documentation folder
    [UUV Computer Systems Functions.xlsx]
2025-02-19 Added more Raspberry Pi tasks to list in Software Documentation
2025-02-21 Updated software documentation to have information about Arduino main program
2025-02-27 Added entry for Raspberry Pi main program
2025-02-27 Created Main Arduino program
2025-02-27 Moved motor control and 6 axis sensor scripts to main folder and converted to c++ files and created header files
2025-02-27 Minor changes to 6 axis sensor program (DEPRECATED)
2025-02-27 Fixed C++ programs to compile correctly
    [6AxisSensor.cpp, Main.ino, MotorControl.cpp, MotorControl.h]
2025-02-28 Tweaked motor control code
2025-03-05 Created program for configuring ESCs with Arduino
2025-03-05 expanded controller inputs
    Code to be ran on rasberrypi through motor driver connected to GPIO ports controlled by ps4 controller
    for testing purposes
    GPIO pin specifics: Motor A (left side): Enable pin 12, Forward pin 16, Backward pin 18
    Motor B (right side): Enable pin 13, Forward pin 22, Backward pin 24
2025-03-07 Mech BOM
    [BOM template - Sheet1.ods]
2025-03-07 Renamed Mech BOM
    [Mech-BOM.ods]
2025-03-08 Added information for Arduino tasks
2025-03-08 Tweaked motor control program
2025-03-08 Tweaked 6 axis sensor program
2025-03-08 Created program for Arduino side of serial communication
2025-03-10 Created software team bill of materials
    [Software-BOM.csv]
2025-03-19 Added cad parts
    [Aluminum Faceplate mms.SLDPRT, Aluminum rod MMGS.SLDPRT, Bracket concept 2 MMGS.SLDPRT, Dimentioned ROV Assembly MMGS.SLDASM, Dimentioned end cap MMGS.SLDPRT, OG rov concept 1.1.SLDASM, Plastic dome MMGS.SLDPRT, Plastic tube MMGS.SLDPRT]
2025-03-28 Added Arduino libraries for various sensors to Modules directory
2025-03-30 Added temporary code to echo any serial messages the Arduino receives
2025-03-30 Added ability for arduino to indicate that the serial connection is ready
2025-03-30 Gave RasPi ability to dynamically find serial port to open, and wait until arduino indicates ready before continuing
2025-03-31 Created spreadsheet that lists the different message types for serial communication
    [SerialCommunicationProtocolMessageTypes.ods]
2025-04-01 Changed serial ready address
    [SerialCommunicationProtocolMessageTypes.ods]
2025-04-10 New Working cad files
    [AUVMotorSupport.SLDPRT, Aluminum Faceplate mms.SLDPRT, Aluminum faceplate mms.SLDPRT, Aluminum rod MMGS.SLDPRT, Back faceplate MMGS.SLDPRT, Bracket concept 2 MMGS.SLDPRT, Dimentioned ROV Assembly MMGS.SLDASM, Dimentioned assembly MMGS.SLDASM]
2025-04-18 Created simulated ultrasonic sensor (still in progress) and minor tweaks to visuals
2025-04-18 Changed simulated tube to better reflect true dimensions
2025-04-24 Inventory of Jen's surprise mystery parts
    [Electronics team BOM - Sheet1.csv]
2025-05-06 Added message type for printing debug info
2025-05-06 updated count of some items
    [Electronics team BOM - Sheet1.csv]
2025-05-06 Inventory of new components
    [Software-BOM.csv]
2025-05-06 Added message category for printing debug info
2025-05-06 tweaked debug printing and added parser case for accepting debug messages from arduino
2025-05-06 Modified file
    [SerialCommunicationProtocolMessageTypes.ods]
2025-05-07 parts and documentation
    [AUV Assembly.SLDASM, AUVMotorSupport.SLDPRT, Front collar.SLDPRT, Front dome.SLDPRT, Long steel rod.SLDPRT, PVC Bracket.SLDPRT, PVC Pipe.SLDPRT, Plate1.SLDPRT]
2025-05-07 Create ESC_init.txt
    Quick note of how to initialize the ESCs on power-up
2025-05-10 Update and rename Updated BOM - Sheet1.csv to 08-05-25 BOM keyport request.csv
    [08-05-25 BOM keyport request.csv]
2025-05-17 Create bom dumy
2025-05-17 Update and rename Keyport BOM1.csv to Keyport BOM1 - fullfilled.csv
    [Keyport BOM1 - fullfilled.csv]
2025-05-17 Update and rename Keyport BOM2 - Sheet1.csv to Keyport BOM2 - pending, submitted.csv
    [Keyport BOM2 - pending, submitted.csv]
2025-05-20 Modified test script to work with four motors
2025-05-20 Inventoried item
    [Electronics team BOM - Sheet1.csv]
2025-05-20 Created directory for operator laptop programs
    [pyvenv.cfg]
2025-05-20 added IMU code to test environment
2025-05-21 Create ROV Circuit diagram - Page 1.png
2025-05-22 Create Mech-BOM May.ods
    [Mech-BOM May.ods]
2025-05-23 Added up to date assembly
    [17715A11_Galvanized Steel Corner Bracket.SLDPRT, 7310K12_Plastic Submersible Cord Grip.SLDPRT, 7310K23_Plastic Submersible Cord Grip.SLDPRT, 90242A160_Super-Corrosion-Resistant 316 Stainless Steel Hex Nut.SLDPRT, 90257A007_Super-Corrosion-Resistant 316 Stainless Steel Hex Nut.SLDPRT, 90585A116_316 Stainless Steel Hex Drive Flat Head Screw.SLDPRT, 91290A113_Alloy Steel Socket Head Screw.SLDPRT, 91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]
2025-05-24 added PCB files
    [MainboardPCB.PcbDoc, MainboardPCB.SchDoc]
2025-05-24 updated PCB files
    [MainboardPCB.PcbDoc, MainboardPCB.SchDoc]
2025-05-28 finished first pcb design
    [MainboardPCB.PcbDoc, MainboardPCB.SchDoc]
2025-05-28 Create UUV Mainboard.csv
    [UUV Mainboard.csv]
2025-05-29 Update UUV Mainboard.csv
    [UUV Mainboard.csv]
2025-05-30 added endcap pcbs
    [MainboardPCB.PcbDoc, endcap.PrjPcb, endcap.csv]
2025-05-30 updated mainboard
    [MainboardPCB.PcbDoc, MainboardPCB.SchDoc]
2025-05-30 fixed endcap pcb files
    [Motor endcap.PcbDoc, endcap.PrjPcb, motor endcap.SchDoc]
2025-06-06 Test code for sensors, to make sure they work
    Need to put them into project folders for Arduino IDE to recognize them
2025-06-06 Moved sensor testing code into project folders
2025-06-06 Updated Arduino Bus IO library
2025-06-06 Screencaps of old "Tie fighter" design and current design
2025-06-13 Propeller prototype
    [Propeller-Z01.SLDPRT]
2025-06-14 Begun reorganizing CAD files.
    [AUV Assembly.SLDASM, AUVMotorSupport.SLDPRT, Aluminum faceplate mms.SLDPRT, Assembled UUV 1.0.SLDASM, B02_1.1.SLDPRT, B02_1.2.SLDPRT, Back faceplate MMGS.SLDPRT, Central Pipe 1.0.SLDPRT]
2025-06-24 drawings upload
    [Hor Nacell FINAL DRAWING.SLDDRW, Horizontal Nacell Guard DRAWING.SLDDRW, Verical Motor Mount DRAWING.SLDDRW, Vertical Nacelle drawing.SLDDRW]
2025-07-01 Created new IMU code, added initialization function for all the IMU modules used in the vehicle
2025-07-01 Removed placeholder code, added call to new IMU initialization function
2025-07-04 WIP Adding calls to new IMU code
2025-07-04 Changed type of object for sensors, added function to register IMUs, various other changes
2025-07-04 Upload from 7/3/25
    [HandleA.STEP]
2025-07-07 Add documents and reorganization
    [Hor Nacell FINAL DRAWING.SLDDRW, Horizontal Nacell Guard DRAWING.SLDDRW, Mech-BOM May.ods, Mech-BOM.ods, Verical Motor Mount DRAWING.SLDDRW, Vertical Nacelle drawing.SLDDRW]
2025-07-10 Changes to ultrasonic sensor reading
2025-07-11 Fixxed bracket
    [AUV Assembly.SLDASM, PVC Bracket.SLDPRT]
2025-07-13 Realy fixed pvc bracket
    [PVC Bracket.SLDPRT]
2025-07-15 Create PVC Bracket.STEP
    [PVC Bracket.STEP]
2025-07-24 Update and rename 3D files/CAD parts/Spring 2025/E04_1.0(pt 2).STEP to 3D files/CAD parts/Spring 2025/electronics Tray/E04_1.0(pt 2).STEP
    [E04_1.0(pt 2).STEP]
2025-07-24 Rename 3D files/CAD parts/Spring 2025/E04_1.0.SLDPRT to 3D files/CAD parts/Spring 2025/Electronics tray/E04_1.0.SLDPRT
    [E04_1.0.SLDPRT]
2025-07-24 Update and rename E04_1.0(pt 2).STEP to E04_1.0(pt 2).STEP
    [E04_1.0(pt 2).STEP]
2025-07-24 Update and rename 3D files/CAD parts/Spring 2025/E04_1.0.STEP to 3D files/CAD parts/Spring 2025/Electronics tray/E04_1.0.STEP
    [E04_1.0.STEP]
2025-07-25 Create Propeller FINAL.STEP
    [Propeller FINAL.STEP]
2025-07-25 Create Hor Nacelle Split 2.STEP
    [Hor Nacelle Split 2.STEP]
2025-07-25 Delete 3D files/CAD parts/Spring 2025/Hor Nacelle Split 2.STEP
    Bye Bye File
    [Hor Nacelle Split 2.STEP]
2025-07-29 Uploaded Horizontal nacelle and motor mount files
    [Hor Nacell 005 FINAL.SLDPRT, Motor mount Hor 001 FINAL.SLDPRT, Motor mount vert 003.SLDPRT]
2025-07-30 Created throttle resolver
2025-07-30 Changes to main arduino sketch
2025-08-13 Arduino code update
2025-08-14 Added motor control groups
